panda73111/HDMI-eagle/README.md

[pandaLight on 3D Warehouse](https://3dwarehouse.sketchup.com/model.html?id=u218e26f0-69cc-4069-a915-63719f472bee)
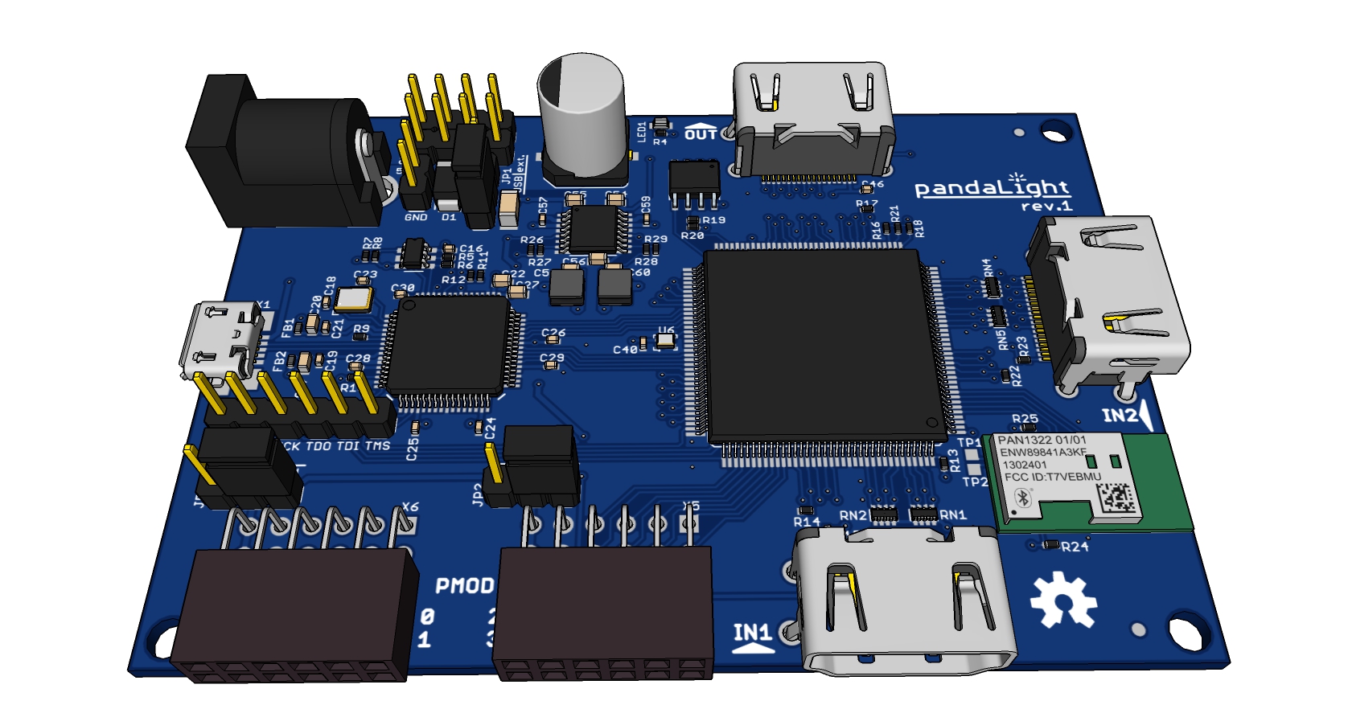
[picture p1: pandalLight/render/full.jpg]
pandaLight render
