panda73111/HDMI-eagle/pandalLight/Collada/pandaLight_rev1/eagleUp_pandaLight_bottom_board.png

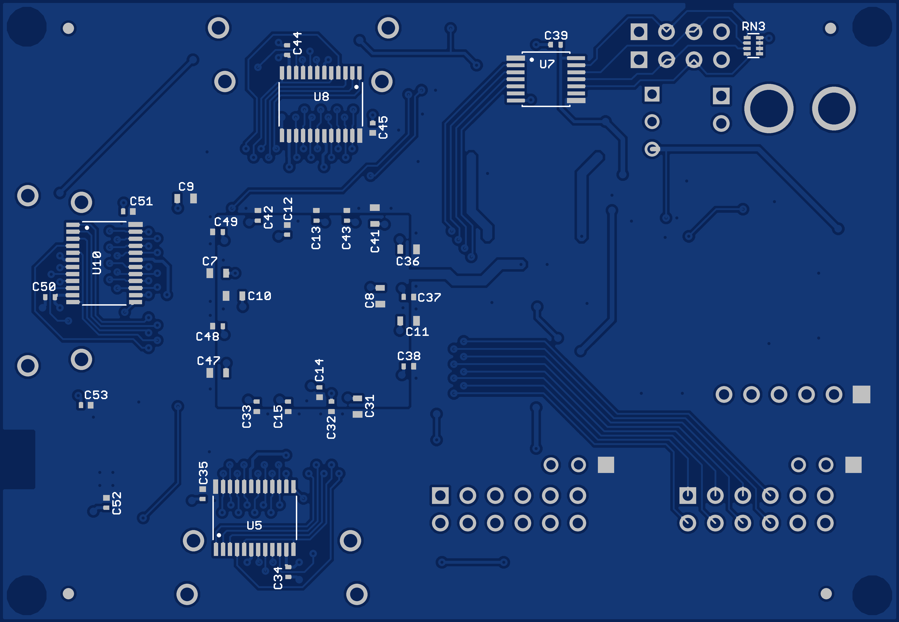
pandalLight/Collada/pandaLight_rev1/eagleUp_pandaLight_bottom_board.png
