panda73111/HDMI-eagle/pandalLight/Collada/pandaLight_rev1/textur_top.png

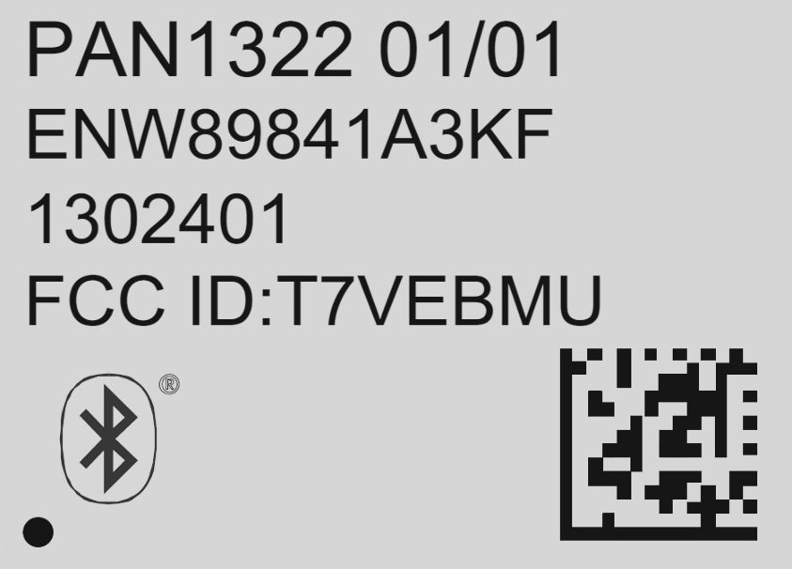
pandalLight/Collada/pandaLight_rev1/textur_top.png
