panda73111/HDMI-eagle/pandalLight/render/bottom.jpg

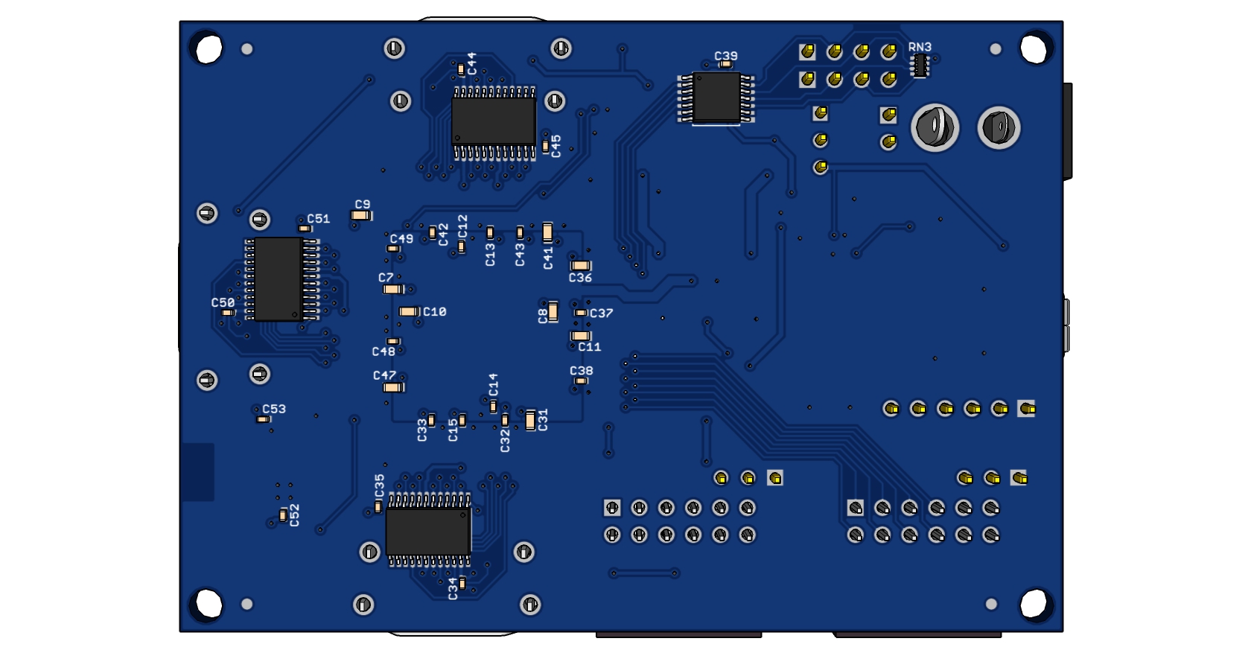
pandalLight/render/bottom.jpg
