panda73111/HDMI-eagle/pandalLight/render/top.jpg

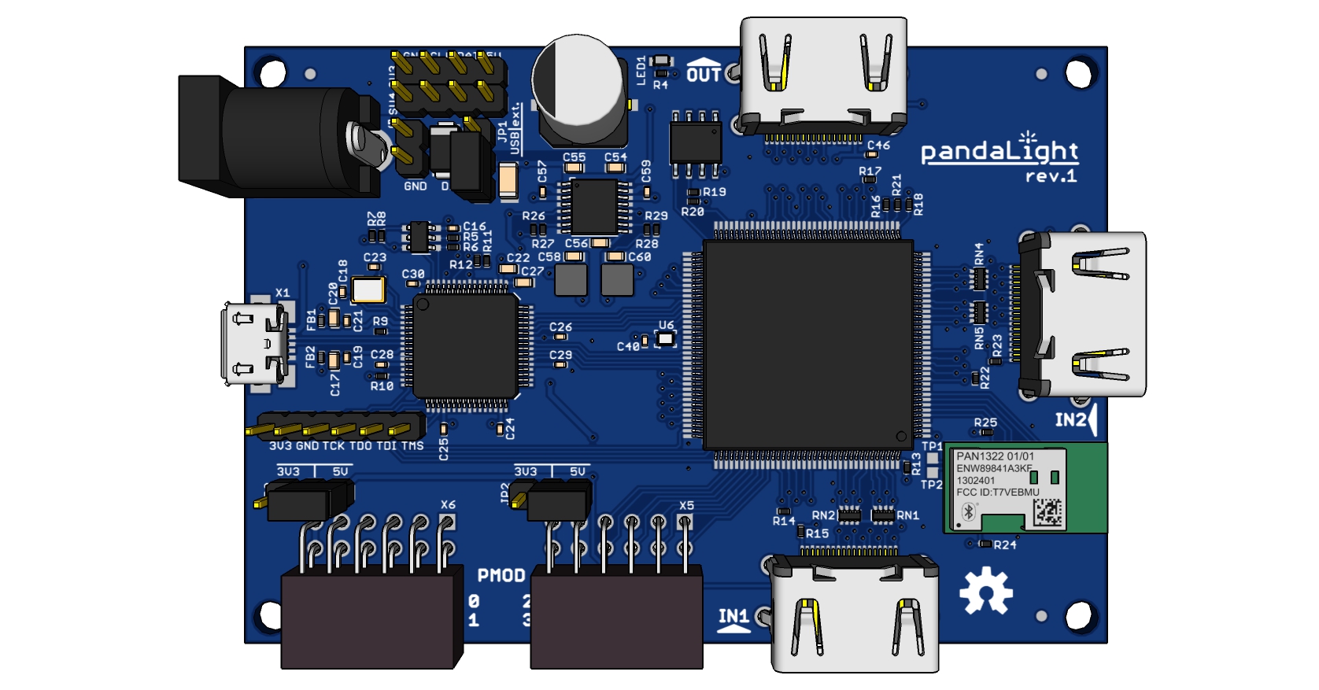
pandalLight/render/top.jpg
