panda73111/HDMI-eagle/(list of files, cad)

Other CAD files:
pandalLight/pandaLight_rev1.skp
