panda73111/HDMI-eagle/pandalLight/pandaLight.brd

## EAGLE design pandalLight/pandaLight.brd (2017-02-20)

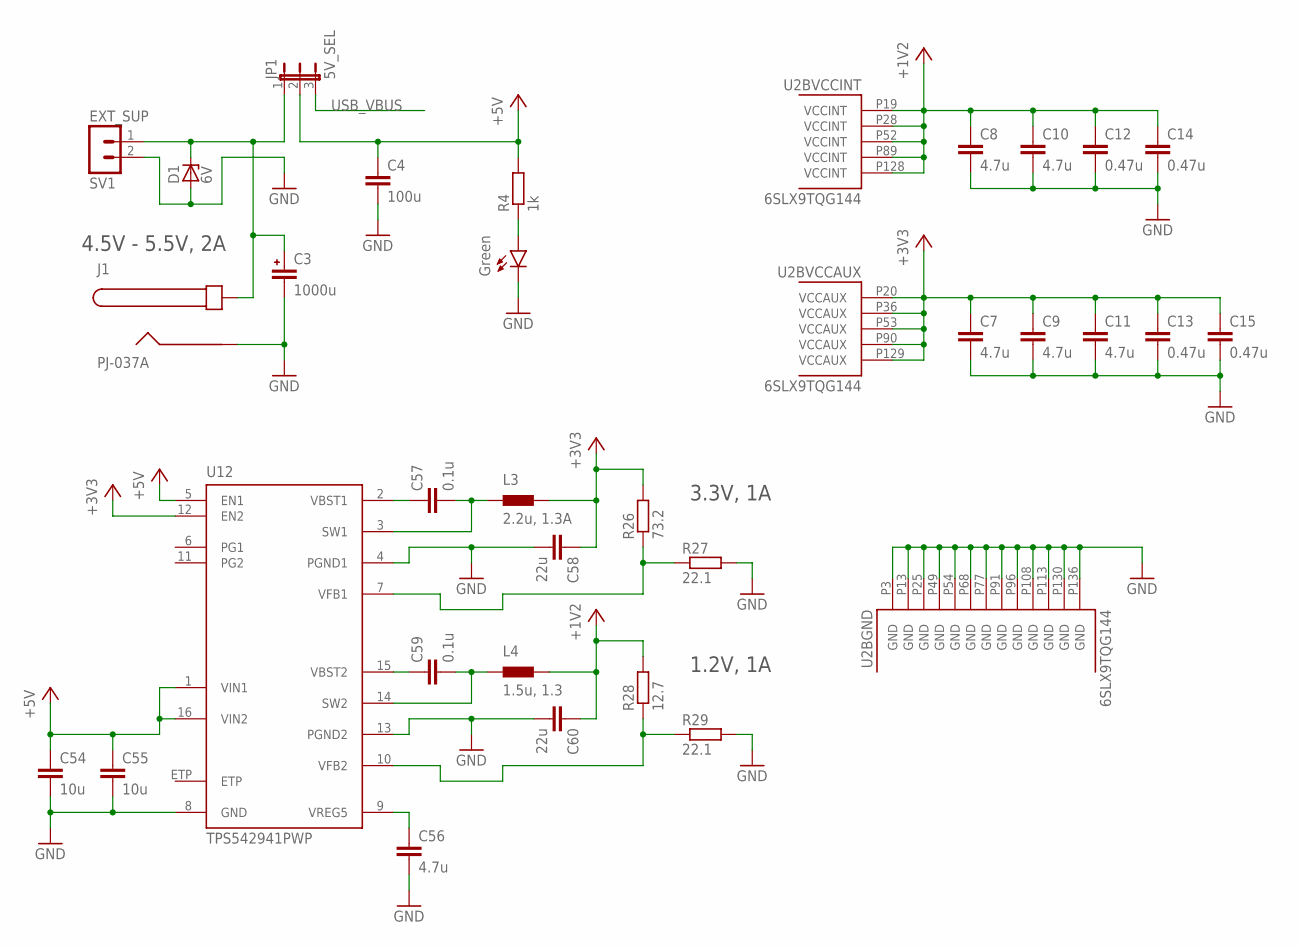
[picture p7: schematic pandaLight.sch, sheet 1, Power]

Parts:
C3: 1000u; MVY_HA0; PARTNO EMVY6R3ADA102MHA0G
C4: 100u; C1206; PARTNO CL31A107MQHNNNE
C7, C8, C9, C10, C11, C56: 4.7u; C0603; PARTNO C0603C475K9PACTU
C12, C13, C14, C15: 0.47u; C0402; PARTNO C1005X5R0J474K050BB
C54, C55: 10u; C0603; PARTNO CL10A106MQ8NNNC
C57, C59: 0.1u; C0402; PARTNO CL05B104KP5NNNC
C58, C60: 22u; C0603; PARTNO CL10A226MQ8NRNC
D1: 6V; DO-214AC; PARTNO SMAJ6.0A
J1: PJ-037A; PARTNO PJ-037A
JP1: 5V_SEL; JP2; PARTNO SPC02SYAN
L3: 2.2u, 1.3A; SRN3015_3X3; PARTNO SRN3015-2R2M
L4: 1.5u, 1.3; SRN3015_3X3; PARTNO SRN3015-1R5Y
LED1: Green; LED-0603; PARTNO LTST-C191KGKT
R4: 1k; R0402; PARTNO ERJ-2RKF1001X
R26: 73.2; R0402; PARTNO ERJ-2RKF73R2X
R27, R29: 22.1; R0402; PARTNO ERJ-2RKF22R1X
R28: 12.7; R0402; PARTNO ERJ-2RKF12R7X
SV1: EXT_SUP; MA02-1; PARTNO *
U2: 6SLX9TQG144; TQ144; PARTNO XC6SLX9-3TQG144C
U12: TPS542941PWP; R-PDSO-G16; PARTNO TPS542941PWP

Connections:
5V_SUP: C3.1, D1.C, J1.CENTER, JP1.1, SV1.1; also elsewhere on the board
+1V2: C8.1, C10.1, C12.1, C14.1, C60.1, L4.2, R28.2, U2.P19 (VCCINT), U2.P28 (VCCINT), U2.P52 (VCCINT), U2.P89 (VCCINT), U2.P128 (VCCINT)
+3V3: C7.1, C9.1, C11.1, C13.1, C15.1, C58.1, L3.2, R26.2, U2.P20 (VCCAUX), U2.P36 (VCCAUX), U2.P53 (VCCAUX), U2.P90 (VCCAUX), U2.P129 (VCCAUX), U12.12 (EN2); also elsewhere on the board
+5V: C4.1, C54.1, C55.1, JP1.2, R4.2, U12.1 (VIN1), U12.5 (EN1), U12.16 (VIN2); also elsewhere on the board
GND: C3.2, C4.2, C7.2, C8.2, C9.2, C10.2, C11.2, C12.2, C13.2, C14.2, C15.2, C54.2, C55.2, C56.2, C58.2, C60.2, D1.A, J1.BARREL, LED1.C, R27.2, R29.2, SV1.2, U2.P3 (GND), U2.P13 (GND), U2.P25 (GND), U2.P49 (GND), U2.P54 (GND), U2.P68 (GND), U2.P77 (GND), U2.P91 (GND), U2.P96 (GND), U2.P108 (GND), U2.P113 (GND), U2.P130 (GND), U2.P136 (GND), U12.4 (PGND1), U12.8 (GND), U12.13 (PGND2); also elsewhere on the board
unnamed: C57.2, L3.1, U12.3 (SW1)
unnamed: R26.1, R27.1, U12.7 (VFB1)
unnamed: C57.1, U12.2 (VBST1)
unnamed: R28.1, R29.1, U12.10 (VFB2)
unnamed: C59.1, U12.15 (VBST2)
unnamed: C59.2, L4.1, U12.14 (SW2)
unnamed: LED1.A, R4.1
USB_VBUS: JP1.3; also elsewhere on the board
VREG5: C56.1, U12.9 (VREG5)

Notes on the sheet:
4.5V - 5.5V, 2A
3.3V, 1A
1.2V, 1A

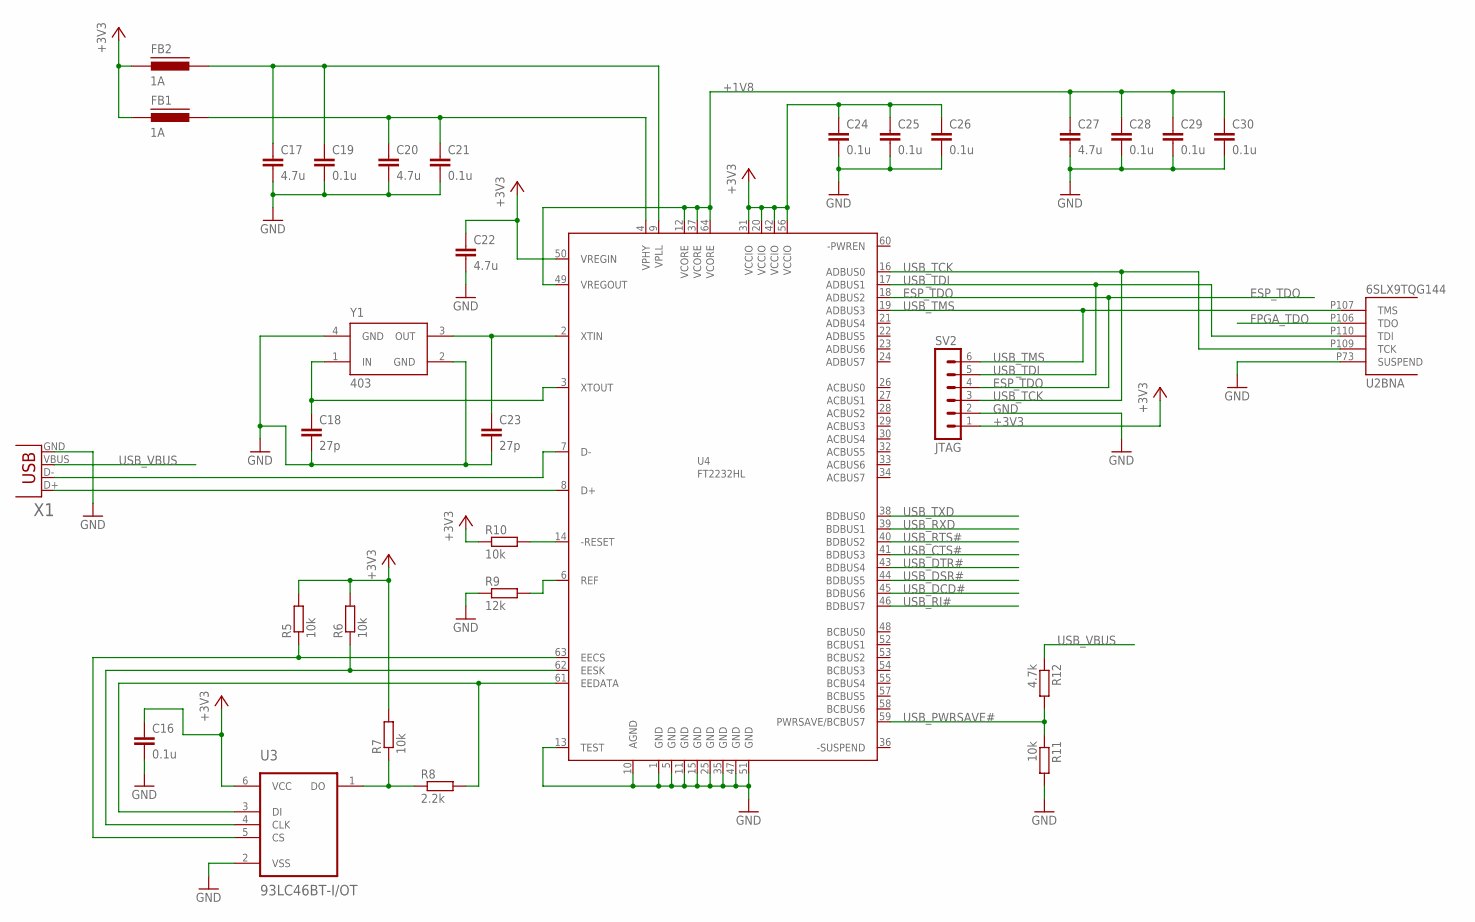
[picture p8: schematic pandaLight.sch, sheet 2, USB]

Parts:
C16, C19, C21, C24, C25, C26, C28, C29, C30: 0.1u; C0402; PARTNO CL05B104KP5NNNC
C17, C20, C22, C27: 4.7u; C0603; PARTNO C0603C475K9PACTU
C18, C23: 27p; C0402; PARTNO CL05C270JB5NNNC
FB1, FB2: 1A; FB0402; PARTNO BK1005HS100-T
R5, R6, R7, R10, R11: 10k; R0402; PARTNO ERJ-2RKF1002X
R8: 2.2k; R0402; PARTNO ERJ-2RKF2201X
R9: 12k; R0402; PARTNO ERJ-2RKF1202X
R12: 4.7k; R0402; PARTNO ERJ-2RKF4701X
SV2: JTAG; MA06-1; PARTNO *
U2: 6SLX9TQG144; TQ144; PARTNO XC6SLX9-3TQG144C
U3: 93LC46BT-I/OT; SOT23-6; PARTNO 93LC46BT-I/OT
U4: FT2232HL; LQFP64; PARTNO FT2232HL-REEL
X1: USBUB-S; USB-UB-S; PARTNO 10118192-0001LF
Y1: 403; 403-3.2X2.5; PARTNO 403C35D12M00000

Connections:
+1V8: C27.1, C28.1, C29.1, C30.1, U4.12 (VCORE), U4.37 (VCORE), U4.49 (VREGOUT), U4.64 (VCORE)
+3V3: C16.1, C22.1, C24.1, C25.1, C26.1, FB1.1, FB2.1, R5.2, R6.2, R7.2, R10.1, SV2.1, U3.6 (VCC), U4.20 (VCCIO), U4.31 (VCCIO), U4.42 (VCCIO), U4.50 (VREGIN), U4.56 (VCCIO); also elsewhere on the board
ESP_TDO: SV2.4, U4.18 (ADBUS2); also elsewhere on the board
FPGA_TDO: U2.P106 (TDO); also elsewhere on the board
GND: C16.2, C17.2, C18.2, C19.2, C20.2, C21.2, C22.2, C23.2, C24.2, C25.2, C26.2, C27.2, C28.2, C29.2, C30.2, R9.1, R11.2, SV2.2, U2.P73 (SUSPEND), U3.2 (VSS), U4.1 (GND), U4.5 (GND), U4.10 (AGND), U4.11 (GND), U4.13 (TEST), U4.15 (GND), U4.25 (GND), U4.35 (GND), U4.47 (GND), U4.51 (GND), X1.GND, Y1.2 (GND), Y1.4 (GND); also elsewhere on the board
unnamed: C23.1, U4.2 (XTIN), Y1.3 (OUT)
unnamed: C18.1, U4.3 (XTOUT), Y1.1 (IN)
unnamed: R5.1, U3.5 (CS), U4.63 (EECS)
unnamed: U4.7 (D-), X1.D-
unnamed: U4.8 (D+), X1.D+
unnamed: R6.1, U3.4 (CLK), U4.62 (EESK)
unnamed: R8.2, U3.3 (DI), U4.61 (EEDATA)
unnamed: R9.2, U4.6 (REF)
unnamed: R7.1, R8.1, U3.1 (DO)
unnamed: R10.2, U4.14 (-RESET)
unnamed: C20.1, C21.1, FB1.2, U4.4 (VPHY)
unnamed: C17.1, C19.1, FB2.2, U4.9 (VPLL)
USB_CTS#: U4.41 (BDBUS3); also elsewhere on the board
USB_DCD#: U4.45 (BDBUS6); also elsewhere on the board
USB_DSR#: U4.44 (BDBUS5); also elsewhere on the board
USB_DTR#: U4.43 (BDBUS4); also elsewhere on the board
USB_PWRSAVE#: R11.1, R12.2, U4.59 (PWRSAVE/BCBUS7)
USB_RI#: U4.46 (BDBUS7); also elsewhere on the board
USB_RTS#: U4.40 (BDBUS2); also elsewhere on the board
USB_RXD: U4.39 (BDBUS1); also elsewhere on the board
USB_TCK: SV2.3, U2.P109 (TCK), U4.16 (ADBUS0); also elsewhere on the board
USB_TDI: SV2.5, U2.P110 (TDI), U4.17 (ADBUS1)
USB_TMS: SV2.6, U2.P107 (TMS), U4.19 (ADBUS3); also elsewhere on the board
USB_TXD: U4.38 (BDBUS0); also elsewhere on the board
USB_VBUS: R12.1, X1.VBUS; also elsewhere on the board

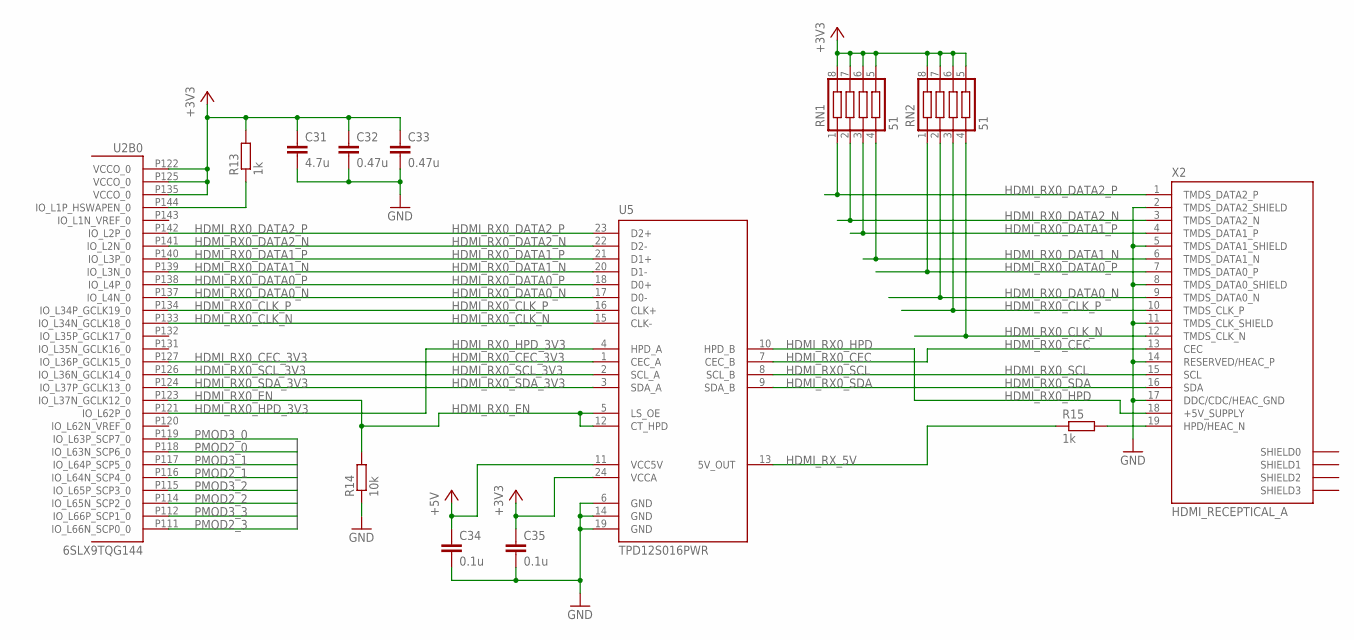
[picture p9: schematic pandaLight.sch, sheet 3, B0, HDMI Rx0]

Parts:
C31: 4.7u; C0603; PARTNO C0603C475K9PACTU
C32, C33: 0.47u; C0402; PARTNO C1005X5R0J474K050BB
C34, C35: 0.1u; C0402; PARTNO CL05B104KP5NNNC
R13, R15: 1k; R0402; PARTNO ERJ-2RKF1001X
R14: 10k; R0402; PARTNO ERJ-2RKF1002X
RN1, RN2: 51; 741C083; PARTNO 741C083510JP
U2: 6SLX9TQG144; TQ144; PARTNO XC6SLX9-3TQG144C
U5: TPD12S016PWR; PW_R-PDSO-G24; PARTNO TPD12S016PWR
X2: HDMI_RECEPTICAL_A; HDMI_TYPE_A_RECEPTICAL; PARTNO 10029449-111RLF

Connections:
+3V3: C31.1, C32.1, C33.1, C35.1, R13.2, RN1.5, RN1.6, RN1.7, RN1.8, RN2.5, RN2.6, RN2.7, RN2.8, U2.P122 (VCCO_0), U2.P125 (VCCO_0), U2.P135 (VCCO_0), U5.24 (VCCA); also elsewhere on the board
+5V: C34.1, U5.11 (VCC5V); also elsewhere on the board
GND: C31.2, C32.2, C33.2, C34.2, C35.2, R14.1, U5.6 (GND), U5.14 (GND), U5.19 (GND), X2.2 (TMDS_DATA2_SHIELD), X2.5 (TMDS_DATA1_SHIELD), X2.8 (TMDS_DATA0_SHIELD), X2.11 (TMDS_CLK_SHIELD), X2.14 (RESERVED/HEAC_P), X2.17 (DDC/CDC/HEAC_GND); also elsewhere on the board
HDMI_RX0_CEC: U5.7 (CEC_B), X2.13 (CEC)
HDMI_RX0_CEC_3V3: U2.P127 (IO_L36P_GCLK15_0), U5.1 (CEC_A)
HDMI_RX0_CLK_N: RN2.4, U2.P133 (IO_L34N_GCLK18_0), U5.15 (CLK-), X2.12 (TMDS_CLK_N)
HDMI_RX0_CLK_P: RN2.3, U2.P134 (IO_L34P_GCLK19_0), U5.16 (CLK+), X2.10 (TMDS_CLK_P)
HDMI_RX0_DATA0_N: RN2.2, U2.P137 (IO_L4N_0), U5.17 (D0-), X2.9 (TMDS_DATA0_N)
HDMI_RX0_DATA0_P: RN2.1, U2.P138 (IO_L4P_0), U5.18 (D0+), X2.7 (TMDS_DATA0_P)
HDMI_RX0_DATA1_N: RN1.4, U2.P139 (IO_L3N_0), U5.20 (D1-), X2.6 (TMDS_DATA1_N)
HDMI_RX0_DATA1_P: RN1.3, U2.P140 (IO_L3P_0), U5.21 (D1+), X2.4 (TMDS_DATA1_P)
HDMI_RX0_DATA2_N: RN1.2, U2.P141 (IO_L2N_0), U5.22 (D2-), X2.3 (TMDS_DATA2_N)
HDMI_RX0_DATA2_P: RN1.1, U2.P142 (IO_L2P_0), U5.23 (D2+), X2.1 (TMDS_DATA2_P)
HDMI_RX0_EN: R14.2, U2.P123 (IO_L37N_GCLK12_0), U5.5 (LS_OE), U5.12 (CT_HPD)
HDMI_RX0_HPD: U5.10 (HPD_B), X2.18 (+5V_SUPPLY)
HDMI_RX0_HPD_3V3: U2.P121 (IO_L62P_0), U5.4 (HPD_A)
HDMI_RX0_SCL: U5.8 (SCL_B), X2.15 (SCL)
HDMI_RX0_SCL_3V3: U2.P126 (IO_L36N_GCLK14_0), U5.2 (SCL_A)
HDMI_RX0_SDA: U5.9 (SDA_B), X2.16 (SDA)
HDMI_RX0_SDA_3V3: U2.P124 (IO_L37P_GCLK13_0), U5.3 (SDA_A)
HDMI_RX_5V: R15.1, U5.13 (5V_OUT)
unnamed: R13.1, U2.P144 (IO_L1P_HSWAPEN_0)
unnamed: R15.2, X2.19 (HPD/HEAC_N)
PMOD2_0: U2.P118 (IO_L63N_SCP6_0); also elsewhere on the board
PMOD2_1: U2.P116 (IO_L64N_SCP4_0); also elsewhere on the board
PMOD2_2: U2.P114 (IO_L65N_SCP2_0); also elsewhere on the board
PMOD2_3: U2.P111 (IO_L66N_SCP0_0); also elsewhere on the board
PMOD3_0: U2.P119 (IO_L63P_SCP7_0); also elsewhere on the board
PMOD3_1: U2.P117 (IO_L64P_SCP5_0); also elsewhere on the board
PMOD3_2: U2.P115 (IO_L65P_SCP3_0); also elsewhere on the board
PMOD3_3: U2.P112 (IO_L66P_SCP1_0); also elsewhere on the board

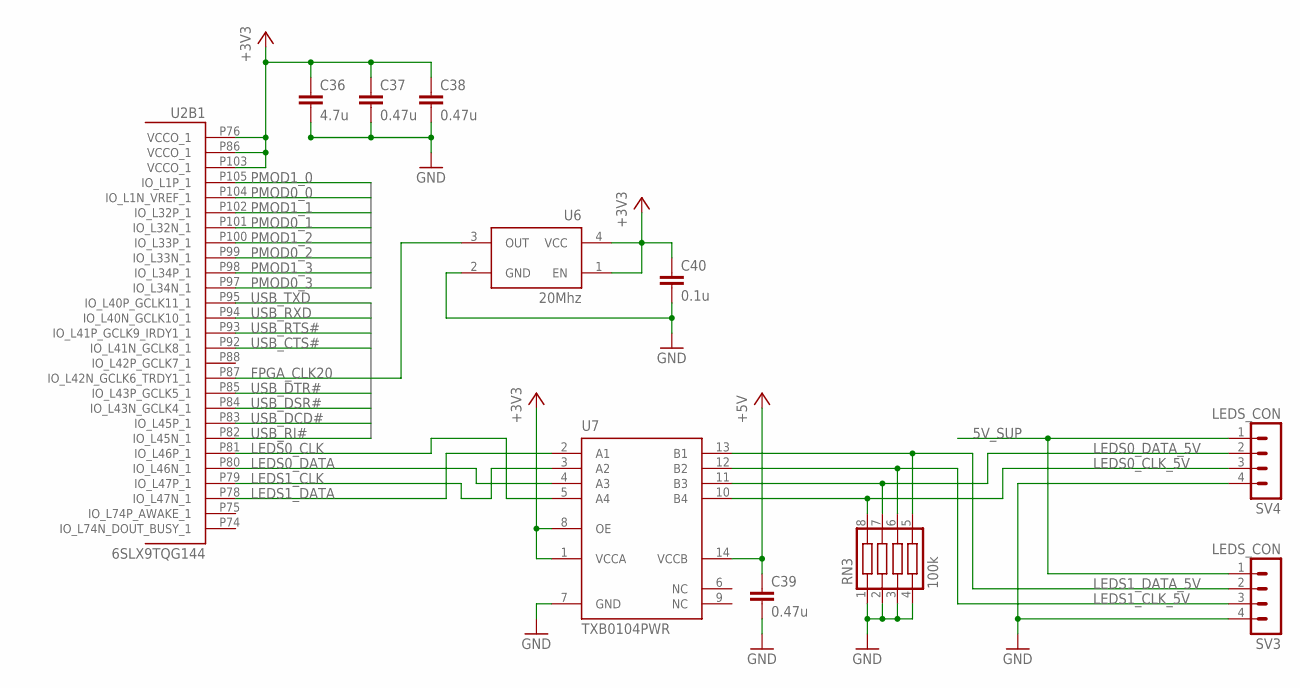
[picture p10: schematic pandaLight.sch, sheet 4, B1, LEDs]

Parts:
C36: 4.7u; C0603; PARTNO C0603C475K9PACTU
C37, C38, C39: 0.47u; C0402; PARTNO C1005X5R0J474K050BB
C40: 0.1u; C0402; PARTNO CL05B104KP5NNNC
RN3: 100k; 741C083; PARTNO 741C083104JP
SV3, SV4: LEDS_CON; MA04-1; PARTNO *
U2: 6SLX9TQG144; TQ144; PARTNO XC6SLX9-3TQG144C
U6: 20Mhz; OSCI-1.6X1.2; PARTNO ASCO-20.000MHZ-EK-T3
U7: TXB0104PWR; R-PDSO-G14; PARTNO TXB0104PWR

Connections:
5V_SUP: SV3.1, SV4.1; also elsewhere on the board
+3V3: C36.1, C37.1, C38.1, C40.1, U2.P76 (VCCO_1), U2.P86 (VCCO_1), U2.P103 (VCCO_1), U6.1 (EN), U6.4 (VCC), U7.1 (VCCA), U7.8 (OE); also elsewhere on the board
+5V: C39.1, U7.14 (VCCB); also elsewhere on the board
FPGA_CLK20: U2.P87 (IO_L42N_GCLK6_TRDY1_1), U6.3 (OUT)
GND: C36.2, C37.2, C38.2, C39.2, C40.2, RN3.1, RN3.2, RN3.3, RN3.4, SV3.4, SV4.4, U6.2 (GND), U7.7 (GND); also elsewhere on the board
LEDS0_CLK: U2.P81 (IO_L46P_1), U7.5 (A4)
LEDS0_CLK_5V: RN3.8, SV4.3, U7.10 (B4)
LEDS0_DATA: U2.P80 (IO_L46N_1), U7.4 (A3)
LEDS0_DATA_5V: RN3.7, SV4.2, U7.11 (B3)
LEDS1_CLK: U2.P79 (IO_L47P_1), U7.3 (A2)
LEDS1_CLK_5V: RN3.6, SV3.3, U7.12 (B2)
LEDS1_DATA: U2.P78 (IO_L47N_1), U7.2 (A1)
LEDS1_DATA_5V: RN3.5, SV3.2, U7.13 (B1)
PMOD0_0: U2.P104 (IO_L1N_VREF_1); also elsewhere on the board
PMOD0_1: U2.P101 (IO_L32N_1); also elsewhere on the board
PMOD0_2: U2.P99 (IO_L33N_1); also elsewhere on the board
PMOD0_3: U2.P97 (IO_L34N_1); also elsewhere on the board
PMOD1_0: U2.P105 (IO_L1P_1); also elsewhere on the board
PMOD1_1: U2.P102 (IO_L32P_1); also elsewhere on the board
PMOD1_2: U2.P100 (IO_L33P_1); also elsewhere on the board
PMOD1_3: U2.P98 (IO_L34P_1); also elsewhere on the board
USB_CTS#: U2.P92 (IO_L41N_GCLK8_1); also elsewhere on the board
USB_DCD#: U2.P83 (IO_L45P_1); also elsewhere on the board
USB_DSR#: U2.P84 (IO_L43N_GCLK4_1); also elsewhere on the board
USB_DTR#: U2.P85 (IO_L43P_GCLK5_1); also elsewhere on the board
USB_RI#: U2.P82 (IO_L45N_1); also elsewhere on the board
USB_RTS#: U2.P93 (IO_L41P_GCLK9_IRDY1_1); also elsewhere on the board
USB_RXD: U2.P94 (IO_L40N_GCLK10_1); also elsewhere on the board
USB_TXD: U2.P95 (IO_L40P_GCLK11_1); also elsewhere on the board

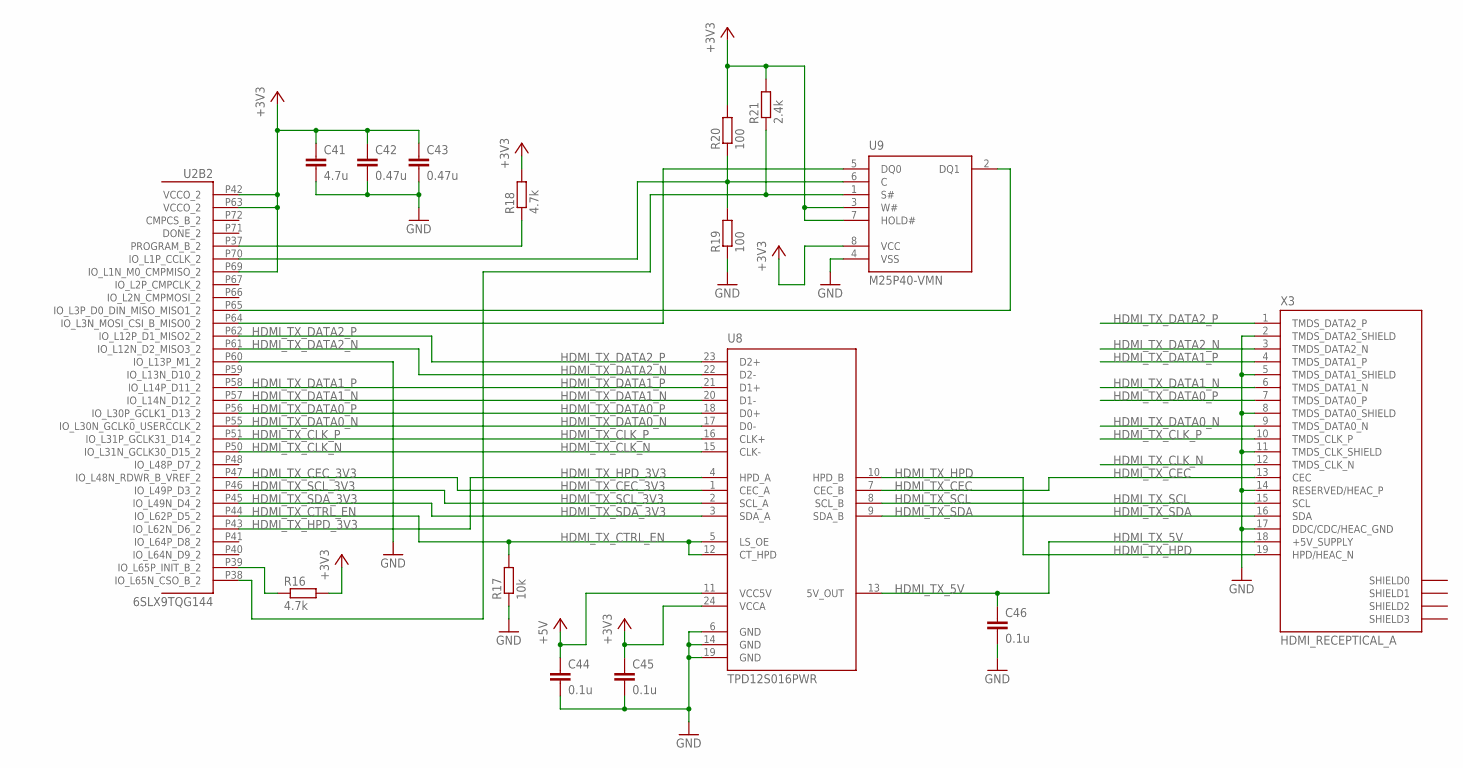
[picture p11: schematic pandaLight.sch, sheet 5, B2, HDMI Tx]

Parts:
C41: 4.7u; C0603; PARTNO C0603C475K9PACTU
C42, C43: 0.47u; C0402; PARTNO C1005X5R0J474K050BB
C44, C45, C46: 0.1u; C0402; PARTNO CL05B104KP5NNNC
R16, R18: 4.7k; R0402; PARTNO ERJ-2RKF4701X
R17: 10k; R0402; PARTNO ERJ-2RKF1002X
R19, R20: 100; R0402; PARTNO ERJ-2GEJ101X
R21: 2.4k; R0402; PARTNO ERJ-2RKF2401X
U2: 6SLX9TQG144; TQ144; PARTNO XC6SLX9-3TQG144C
U8: TPD12S016PWR; PW_R-PDSO-G24; PARTNO TPD12S016PWR
U9: M25P40-VMN; SO8N; PARTNO M25P80-VMN6TP
X3: HDMI_RECEPTICAL_A; HDMI_TYPE_A_RECEPTICAL; PARTNO 10029449-111RLF

Connections:
+3V3: C41.1, C42.1, C43.1, C45.1, R16.2, R18.2, R20.2, R21.2, U2.P42 (VCCO_2), U2.P63 (VCCO_2), U2.P69 (IO_L1N_M0_CMPMISO_2), U8.24 (VCCA), U9.3 (W#), U9.7 (HOLD#), U9.8 (VCC); also elsewhere on the board
+5V: C44.1, U8.11 (VCC5V); also elsewhere on the board
GND: C41.2, C42.2, C43.2, C44.2, C45.2, C46.2, R17.1, R19.1, U2.P60 (IO_L13P_M1_2), U8.6 (GND), U8.14 (GND), U8.19 (GND), U9.4 (VSS), X3.2 (TMDS_DATA2_SHIELD), X3.5 (TMDS_DATA1_SHIELD), X3.8 (TMDS_DATA0_SHIELD), X3.11 (TMDS_CLK_SHIELD), X3.14 (RESERVED/HEAC_P), X3.17 (DDC/CDC/HEAC_GND); also elsewhere on the board
HDMI_TX_5V: C46.1, U8.13 (5V_OUT), X3.18 (+5V_SUPPLY)
HDMI_TX_CEC: U8.7 (CEC_B), X3.13 (CEC)
HDMI_TX_CEC_3V3: U2.P47 (IO_L48N_RDWR_B_VREF_2), U8.1 (CEC_A)
HDMI_TX_CLK_N: U2.P50 (IO_L31N_GCLK30_D15_2), U8.15 (CLK-), X3.12 (TMDS_CLK_N)
HDMI_TX_CLK_P: U2.P51 (IO_L31P_GCLK31_D14_2), U8.16 (CLK+), X3.10 (TMDS_CLK_P)
HDMI_TX_CTRL_EN: R17.2, U2.P44 (IO_L62P_D5_2), U8.5 (LS_OE), U8.12 (CT_HPD)
HDMI_TX_DATA0_N: U2.P55 (IO_L30N_GCLK0_USERCCLK_2), U8.17 (D0-), X3.9 (TMDS_DATA0_N)
HDMI_TX_DATA0_P: U2.P56 (IO_L30P_GCLK1_D13_2), U8.18 (D0+), X3.7 (TMDS_DATA0_P)
HDMI_TX_DATA1_N: U2.P57 (IO_L14N_D12_2), U8.20 (D1-), X3.6 (TMDS_DATA1_N)
HDMI_TX_DATA1_P: U2.P58 (IO_L14P_D11_2), U8.21 (D1+), X3.4 (TMDS_DATA1_P)
HDMI_TX_DATA2_N: U2.P61 (IO_L12N_D2_MISO3_2), U8.22 (D2-), X3.3 (TMDS_DATA2_N)
HDMI_TX_DATA2_P: U2.P62 (IO_L12P_D1_MISO2_2), U8.23 (D2+), X3.1 (TMDS_DATA2_P)
HDMI_TX_HPD: U8.10 (HPD_B), X3.19 (HPD/HEAC_N)
HDMI_TX_HPD_3V3: U2.P43 (IO_L62N_D6_2), U8.4 (HPD_A)
HDMI_TX_SCL: U8.8 (SCL_B), X3.15 (SCL)
HDMI_TX_SCL_3V3: U2.P46 (IO_L49P_D3_2), U8.2 (SCL_A)
HDMI_TX_SDA: U8.9 (SDA_B), X3.16 (SDA)
HDMI_TX_SDA_3V3: U2.P45 (IO_L49N_D4_2), U8.3 (SDA_A)
unnamed: R18.1, U2.P37 (PROGRAM_B_2)
unnamed: R16.1, U2.P39 (IO_L65P_INIT_B_2)
unnamed: U2.P64 (IO_L3N_MOSI_CSI_B_MISO0_2), U9.5 (DQ0)
unnamed: R21.1, U2.P38 (IO_L65N_CSO_B_2), U9.1 (S#)
unnamed: R19.2, R20.1, U2.P70 (IO_L1P_CCLK_2), U9.6 (C)
unnamed: U2.P65 (IO_L3P_D0_DIN_MISO_MISO1_2), U9.2 (DQ1)

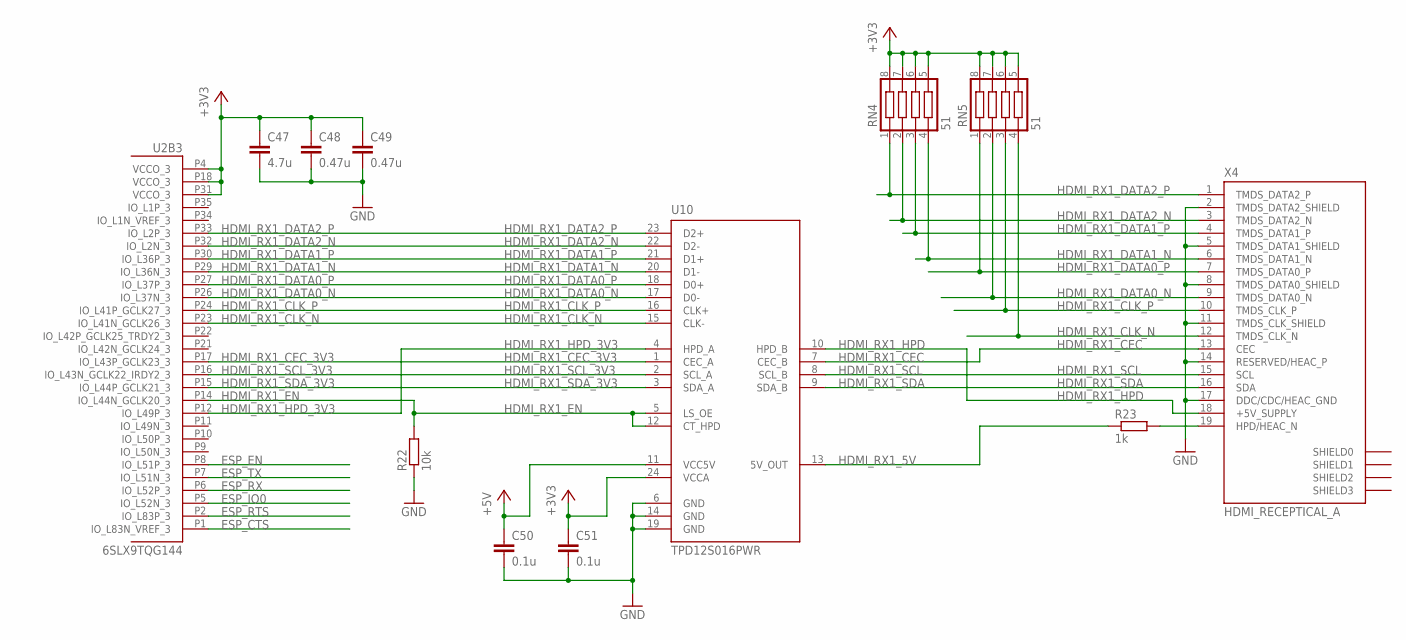
[picture p12: schematic pandaLight.sch, sheet 6, B3, HDMI Rx1, Bluetooth/WiFi]

Parts:
C47: 4.7u; C0603; PARTNO C0603C475K9PACTU
C48, C49: 0.47u; C0402; PARTNO C1005X5R0J474K050BB
C50, C51: 0.1u; C0402; PARTNO CL05B104KP5NNNC
R22: 10k; R0402; PARTNO ERJ-2RKF1002X
R23: 1k; R0402; PARTNO ERJ-2RKF1001X
RN4, RN5: 51; 741C083; PARTNO 741C083510JP
U2: 6SLX9TQG144; TQ144; PARTNO XC6SLX9-3TQG144C
U10: TPD12S016PWR; PW_R-PDSO-G24; PARTNO TPD12S016PWR
X4: HDMI_RECEPTICAL_A; HDMI_TYPE_A_RECEPTICAL; PARTNO 10029449-111RLF

Connections:
+3V3: C47.1, C48.1, C49.1, C51.1, RN4.5, RN4.6, RN4.7, RN4.8, RN5.5, RN5.6, RN5.7, RN5.8, U2.P4 (VCCO_3), U2.P18 (VCCO_3), U2.P31 (VCCO_3), U10.24 (VCCA); also elsewhere on the board
+5V: C50.1, U10.11 (VCC5V); also elsewhere on the board
ESP_CTS: U2.P1 (IO_L83N_VREF_3); also elsewhere on the board
ESP_EN: U2.P8 (IO_L51P_3); also elsewhere on the board
ESP_IO0: U2.P5 (IO_L52N_3); also elsewhere on the board
ESP_RTS: U2.P2 (IO_L83P_3); also elsewhere on the board
ESP_RX: U2.P6 (IO_L52P_3); also elsewhere on the board
ESP_TX: U2.P7 (IO_L51N_3); also elsewhere on the board
GND: C47.2, C48.2, C49.2, C50.2, C51.2, R22.1, U10.6 (GND), U10.14 (GND), U10.19 (GND), X4.2 (TMDS_DATA2_SHIELD), X4.5 (TMDS_DATA1_SHIELD), X4.8 (TMDS_DATA0_SHIELD), X4.11 (TMDS_CLK_SHIELD), X4.14 (RESERVED/HEAC_P), X4.17 (DDC/CDC/HEAC_GND); also elsewhere on the board
HDMI_RX1_5V: R23.1, U10.13 (5V_OUT)
HDMI_RX1_CEC: U10.7 (CEC_B), X4.13 (CEC)
HDMI_RX1_CEC_3V3: U2.P17 (IO_L43P_GCLK23_3), U10.1 (CEC_A)
HDMI_RX1_CLK_N: RN5.4, U2.P23 (IO_L41N_GCLK26_3), U10.15 (CLK-), X4.12 (TMDS_CLK_N)
HDMI_RX1_CLK_P: RN5.3, U2.P24 (IO_L41P_GCLK27_3), U10.16 (CLK+), X4.10 (TMDS_CLK_P)
HDMI_RX1_DATA0_N: RN5.2, U2.P26 (IO_L37N_3), U10.17 (D0-), X4.9 (TMDS_DATA0_N)
HDMI_RX1_DATA0_P: RN5.1, U2.P27 (IO_L37P_3), U10.18 (D0+), X4.7 (TMDS_DATA0_P)
HDMI_RX1_DATA1_N: RN4.4, U2.P29 (IO_L36N_3), U10.20 (D1-), X4.6 (TMDS_DATA1_N)
HDMI_RX1_DATA1_P: RN4.3, U2.P30 (IO_L36P_3), U10.21 (D1+), X4.4 (TMDS_DATA1_P)
HDMI_RX1_DATA2_N: RN4.2, U2.P32 (IO_L2N_3), U10.22 (D2-), X4.3 (TMDS_DATA2_N)
HDMI_RX1_DATA2_P: RN4.1, U2.P33 (IO_L2P_3), U10.23 (D2+), X4.1 (TMDS_DATA2_P)
HDMI_RX1_EN: R22.2, U2.P14 (IO_L44N_GCLK20_3), U10.5 (LS_OE), U10.12 (CT_HPD)
HDMI_RX1_HPD: U10.10 (HPD_B), X4.18 (+5V_SUPPLY)
HDMI_RX1_HPD_3V3: U2.P12 (IO_L49P_3), U10.4 (HPD_A)
HDMI_RX1_SCL: U10.8 (SCL_B), X4.15 (SCL)
HDMI_RX1_SCL_3V3: U2.P16 (IO_L43N_GCLK22_IRDY2_3), U10.2 (SCL_A)
HDMI_RX1_SDA: U10.9 (SDA_B), X4.16 (SDA)
HDMI_RX1_SDA_3V3: U2.P15 (IO_L44P_GCLK21_3), U10.3 (SDA_A)
unnamed: R23.2, X4.19 (HPD/HEAC_N)

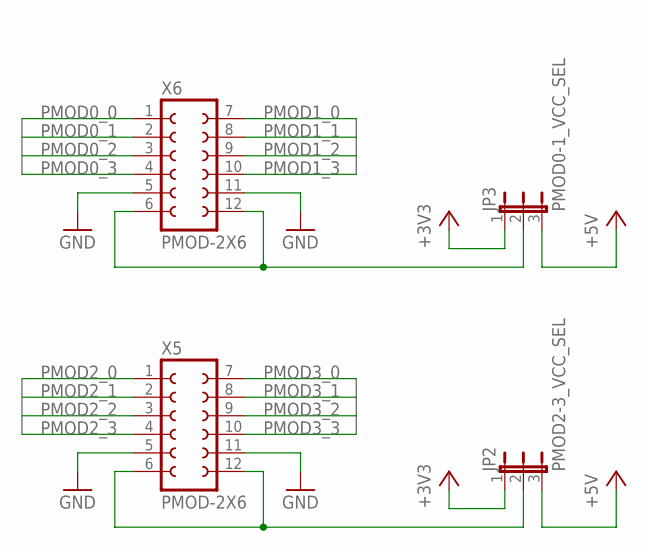
[picture p13: schematic pandaLight.sch, sheet 7, PMOD]

Parts:
JP2: PMOD2-3_VCC_SEL; JP2; PARTNO SPC02SYAN
JP3: PMOD0-1_VCC_SEL; JP2; PARTNO SPC02SYAN
X5, X6: PMOD-2X6; PARTNO PPTC062LJBN-RC

Connections:
+3V3: JP2.1, JP3.1; also elsewhere on the board
+5V: JP2.3, JP3.3; also elsewhere on the board
GND: X5.5, X5.11, X6.5, X6.11; also elsewhere on the board
unnamed: JP2.2, X5.6, X5.12
unnamed: JP3.2, X6.6, X6.12
PMOD0_0: X6.1; also elsewhere on the board
PMOD0_1: X6.2; also elsewhere on the board
PMOD0_2: X6.3; also elsewhere on the board
PMOD0_3: X6.4; also elsewhere on the board
PMOD1_0: X6.7; also elsewhere on the board
PMOD1_1: X6.8; also elsewhere on the board
PMOD1_2: X6.9; also elsewhere on the board
PMOD1_3: X6.10; also elsewhere on the board
PMOD2_0: X5.1; also elsewhere on the board
PMOD2_1: X5.2; also elsewhere on the board
PMOD2_2: X5.3; also elsewhere on the board
PMOD2_3: X5.4; also elsewhere on the board
PMOD3_0: X5.7; also elsewhere on the board
PMOD3_1: X5.8; also elsewhere on the board
PMOD3_2: X5.9; also elsewhere on the board
PMOD3_3: X5.10; also elsewhere on the board

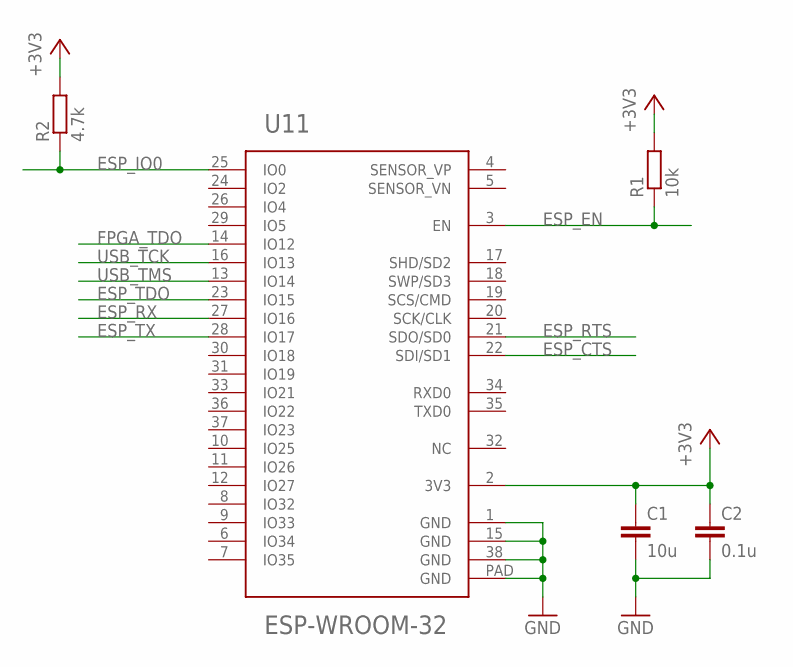
[picture p14: schematic pandaLight.sch, sheet 8, Bluetooth/WiFi]

Parts:
C1: 10u; C0603
C2: 0.1u; C0402; PARTNO CL05B104KP5NNNC
R1: 10k; R0402; PARTNO ERJ-2RKF1002X
R2: 4.7k; R0402; PARTNO ERJ-2RKF1002X
U11: ESP-WROOM-32

Connections:
+3V3: C1.1, C2.1, R1.2, R2.2, U11.2 (3V3); also elsewhere on the board
ESP_CTS: U11.22 (SDI/SD1); also elsewhere on the board
ESP_EN: R1.1, U11.3 (EN); also elsewhere on the board
ESP_IO0: R2.1, U11.25 (IO0); also elsewhere on the board
ESP_RTS: U11.21 (SDO/SD0); also elsewhere on the board
ESP_RX: U11.27 (IO16); also elsewhere on the board
ESP_TDO: U11.23 (IO15); also elsewhere on the board
ESP_TX: U11.28 (IO17); also elsewhere on the board
FPGA_TDO: U11.14 (IO12); also elsewhere on the board
GND: C1.2, C2.2, U11.1 (GND), U11.15 (GND), U11.38 (GND), U11.PAD (GND); also elsewhere on the board
USB_TCK: U11.16 (IO13); also elsewhere on the board
USB_TMS: U11.13 (IO14); also elsewhere on the board

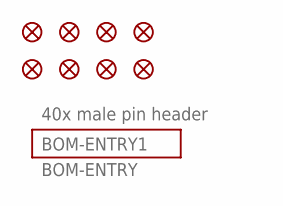
[picture p15: schematic pandaLight.sch, sheet 9, misc]

Parts:
FID1, FID2, FID3, FID4, FID5, FID6, FID7, FID8: FIDUCIAL1X2; FIDUCIAL-1X2

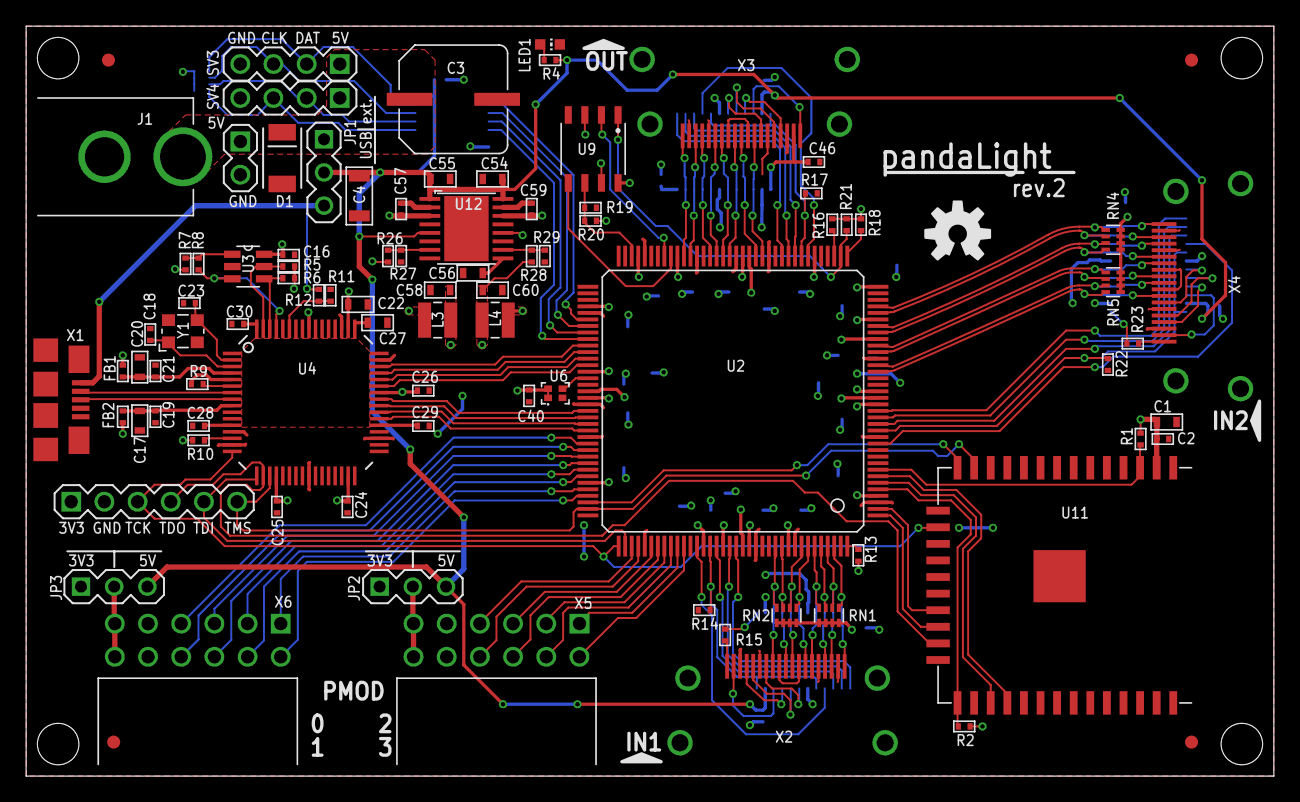
[picture p16: board pandaLight.brd from above]

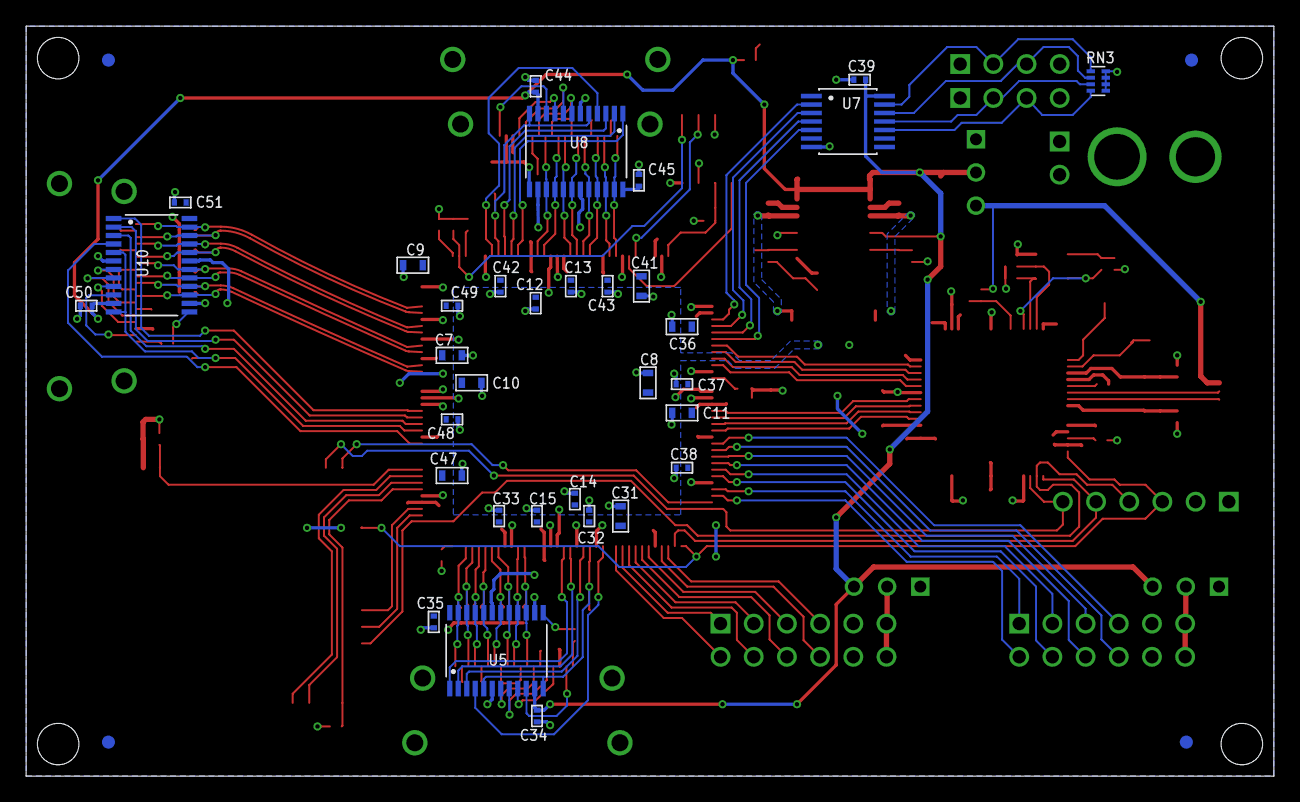
[picture p17: board pandaLight.brd from below]

Board: 2 copper layers, 95.5 x 57.4 mm, 128 parts (37 on the bottom side), 137 nets.

Other parts of the board:
OSHW-LOGO: OSHW-LOGO-M
