panda73111/HDMI-eagle/pandaLightPlus/pandaLightPlus.brd

## EAGLE design pandaLightPlus/pandaLightPlus.brd (2014-06-23)

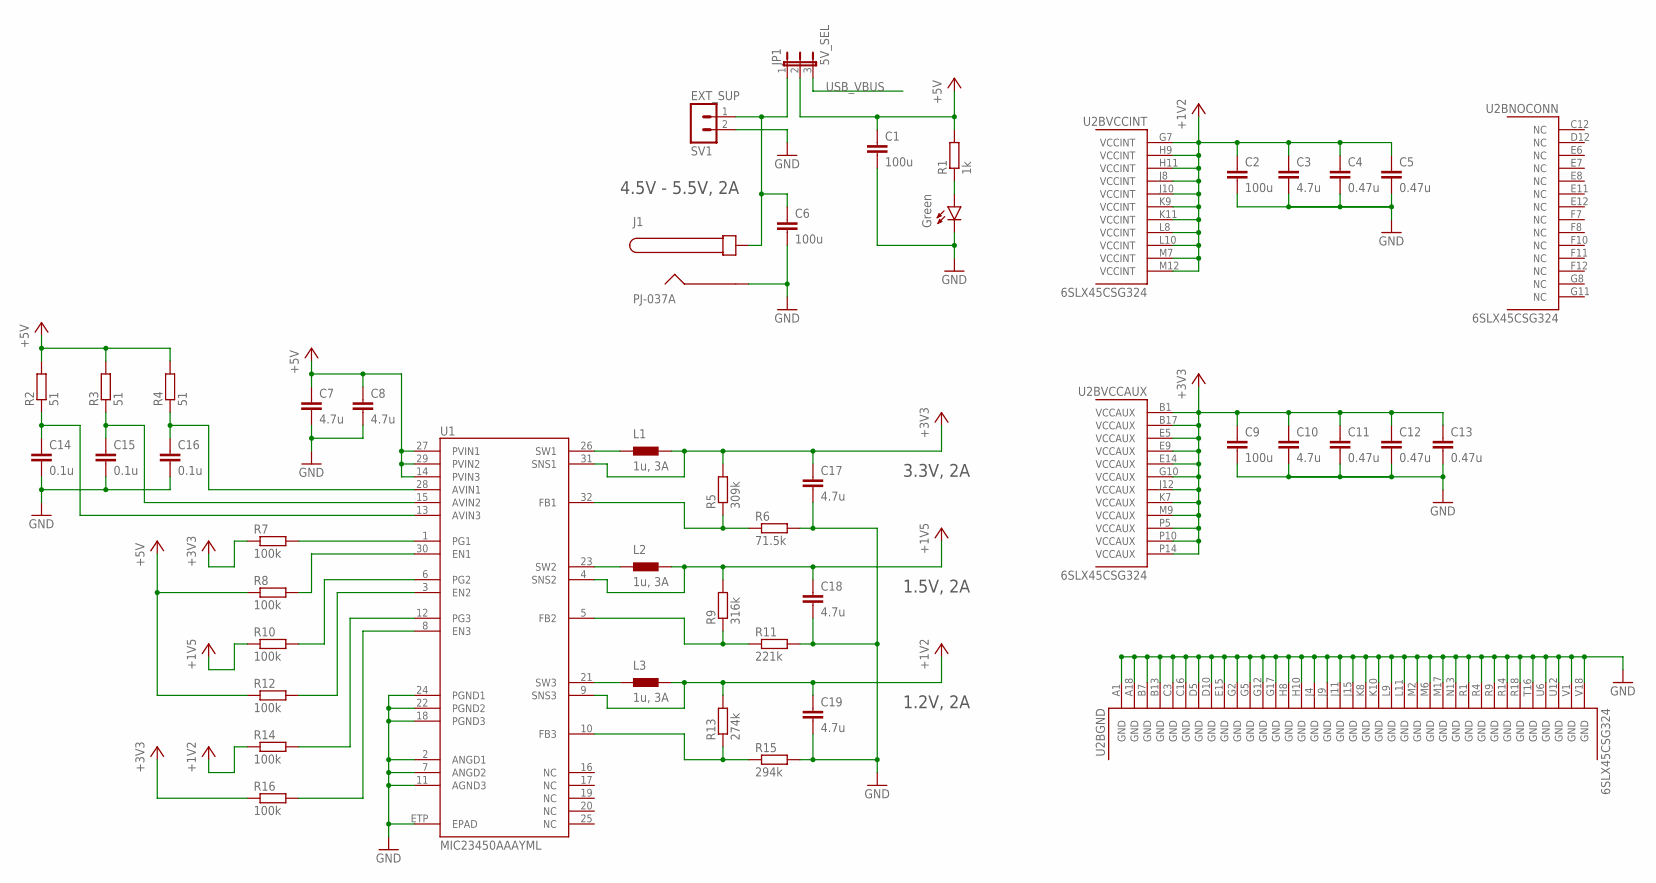
[picture p18: schematic pandaLightPlus.sch, sheet 1, Power]

Parts:
C1, C2, C6, C9: 100u; 1206; PARTNO CL31A107MQHNNNE
C3, C7, C8, C10, C17, C18, C19: 4.7u; 0603; PARTNO C0603C475K9PACTU
C4, C5, C11, C12, C13: 0.47u; 0402; PARTNO C1005X5R0J474K050BB
C14, C15, C16: 0.1u; 0402; PARTNO CL05B104KP5NNNC
J1: PJ-037A; PARTNO PJ-037A
JP1: 5V_SEL; JP2; PARTNO *
L1, L2, L3: 1u, 3A; 1008; PARTNO CIG22E1R0MNE
LED1: Green; LED-0603; PARTNO LG Q971-KN-1
R1: 1k; 0402; PARTNO ERJ-2RKF1001X
R2, R3, R4: 51; 0402; PARTNO ERJ-2RKF51R0X
R5: 309k; 0402; PARTNO ERJ-2RKF3093X
R6: 71.5k; 0402; PARTNO ERJ-2RKF7152X
R7, R8, R10, R12, R14, R16: 100k; 0402; PARTNO ERJ-2RKF1003X
R9: 316k; 0402; PARTNO ERJ-2RKF3163X
R11: 221k; 0402; PARTNO ERJ-2RKF2213X
R13: 274k; 0402; PARTNO ERJ-2RKF2743X
R15: 294k; 0402; PARTNO ERJ-2RKF2943X
SV1: EXT_SUP; MA02-1; PARTNO *
U1: MIC23450AAAYML; QFN-32-5X5; PARTNO MIC23450-AAAYML TR
U2: 6SLX45CSG324; CS324; PARTNO XC6SLX45-3CSG324C

Connections:
+1V2: C2.1, C3.1, C4.1, C5.1, C19.1, L3.2, R13.2, R14.1, U1.9 (SNS3), U2.G7 (VCCINT), U2.H9 (VCCINT), U2.H11 (VCCINT), U2.J8 (VCCINT), U2.J10 (VCCINT), U2.K9 (VCCINT), U2.K11 (VCCINT), U2.L8 (VCCINT), U2.L10 (VCCINT), U2.M7 (VCCINT), U2.M12 (VCCINT)
+1V5: C18.1, L2.2, R9.2, R10.1, U1.4 (SNS2); also elsewhere on the board
+3V3: C9.1, C10.1, C11.1, C12.1, C13.1, C17.1, L1.2, R5.2, R7.1, R16.1, U1.31 (SNS1), U2.B1 (VCCAUX), U2.B17 (VCCAUX), U2.E5 (VCCAUX), U2.E9 (VCCAUX), U2.E14 (VCCAUX), U2.G10 (VCCAUX), U2.J12 (VCCAUX), U2.K7 (VCCAUX), U2.M9 (VCCAUX), U2.P5 (VCCAUX), U2.P10 (VCCAUX), U2.P14 (VCCAUX); also elsewhere on the board
+5V: C1.1, C7.1, C8.1, JP1.2, R1.2, R2.2, R3.2, R4.2, R8.1, R12.1, U1.14 (PVIN3), U1.27 (PVIN1), U1.29 (PVIN2); also elsewhere on the board
CENTER: C6.1, J1.CENTER, JP1.1, SV1.1
GND: C1.2, C2.2, C3.2, C4.2, C5.2, C6.2, C7.2, C8.2, C9.2, C10.2, C11.2, C12.2, C13.2, C14.2, C15.2, C16.2, C17.2, C18.2, C19.2, J1.BARREL, LED1.C, R6.2, R11.2, R15.2, SV1.2, U1.2 (ANGD1), U1.7 (ANGD2), U1.11 (AGND3), U1.18 (PGND3), U1.22 (PGND2), U1.24 (PGND1), U1.ETP (EPAD), U2.A1 (GND), U2.A18 (GND), U2.B7 (GND), U2.B13 (GND), U2.C3 (GND), U2.C16 (GND), U2.D5 (GND), U2.D10 (GND), U2.E15 (GND), U2.G2 (GND), U2.G5 (GND), U2.G12 (GND), U2.G17 (GND), U2.H8 (GND), U2.H10 (GND), U2.J4 (GND), U2.J9 (GND), U2.J11 (GND), U2.J15 (GND), U2.K8 (GND), U2.K10 (GND), U2.L9 (GND), U2.L11 (GND), U2.M2 (GND), U2.M6 (GND), U2.M17 (GND), U2.N13 (GND), U2.R1 (GND), U2.R4 (GND), U2.R9 (GND), U2.R14 (GND), U2.R18 (GND), U2.T16 (GND), U2.U6 (GND), U2.U12 (GND), U2.V1 (GND), U2.V18 (GND); also elsewhere on the board
unnamed: L1.1, U1.26 (SW1)
unnamed: C16.1, R4.1, U1.28 (AVIN1)
unnamed: L2.1, U1.23 (SW2)
unnamed: L3.1, U1.21 (SW3)
unnamed: R13.1, R15.1, U1.10 (FB3)
unnamed: R10.2, U1.6 (PG2)
unnamed: R5.1, R6.1, U1.32 (FB1)
unnamed: R7.2, U1.1 (PG1)
unnamed: R9.1, R11.1, U1.5 (FB2)
unnamed: R12.2, U1.3 (EN2)
unnamed: R8.2, U1.30 (EN1)
unnamed: R14.2, U1.12 (PG3)
unnamed: R16.2, U1.8 (EN3)
unnamed: C15.1, R3.1, U1.15 (AVIN2)
unnamed: LED1.A, R1.1
unnamed: C14.1, R2.1, U1.13 (AVIN3)
USB_VBUS: JP1.3; also elsewhere on the board

Notes on the sheet:
4.5V - 5.5V, 2A
3.3V, 2A
1.5V, 2A
1.2V, 2A

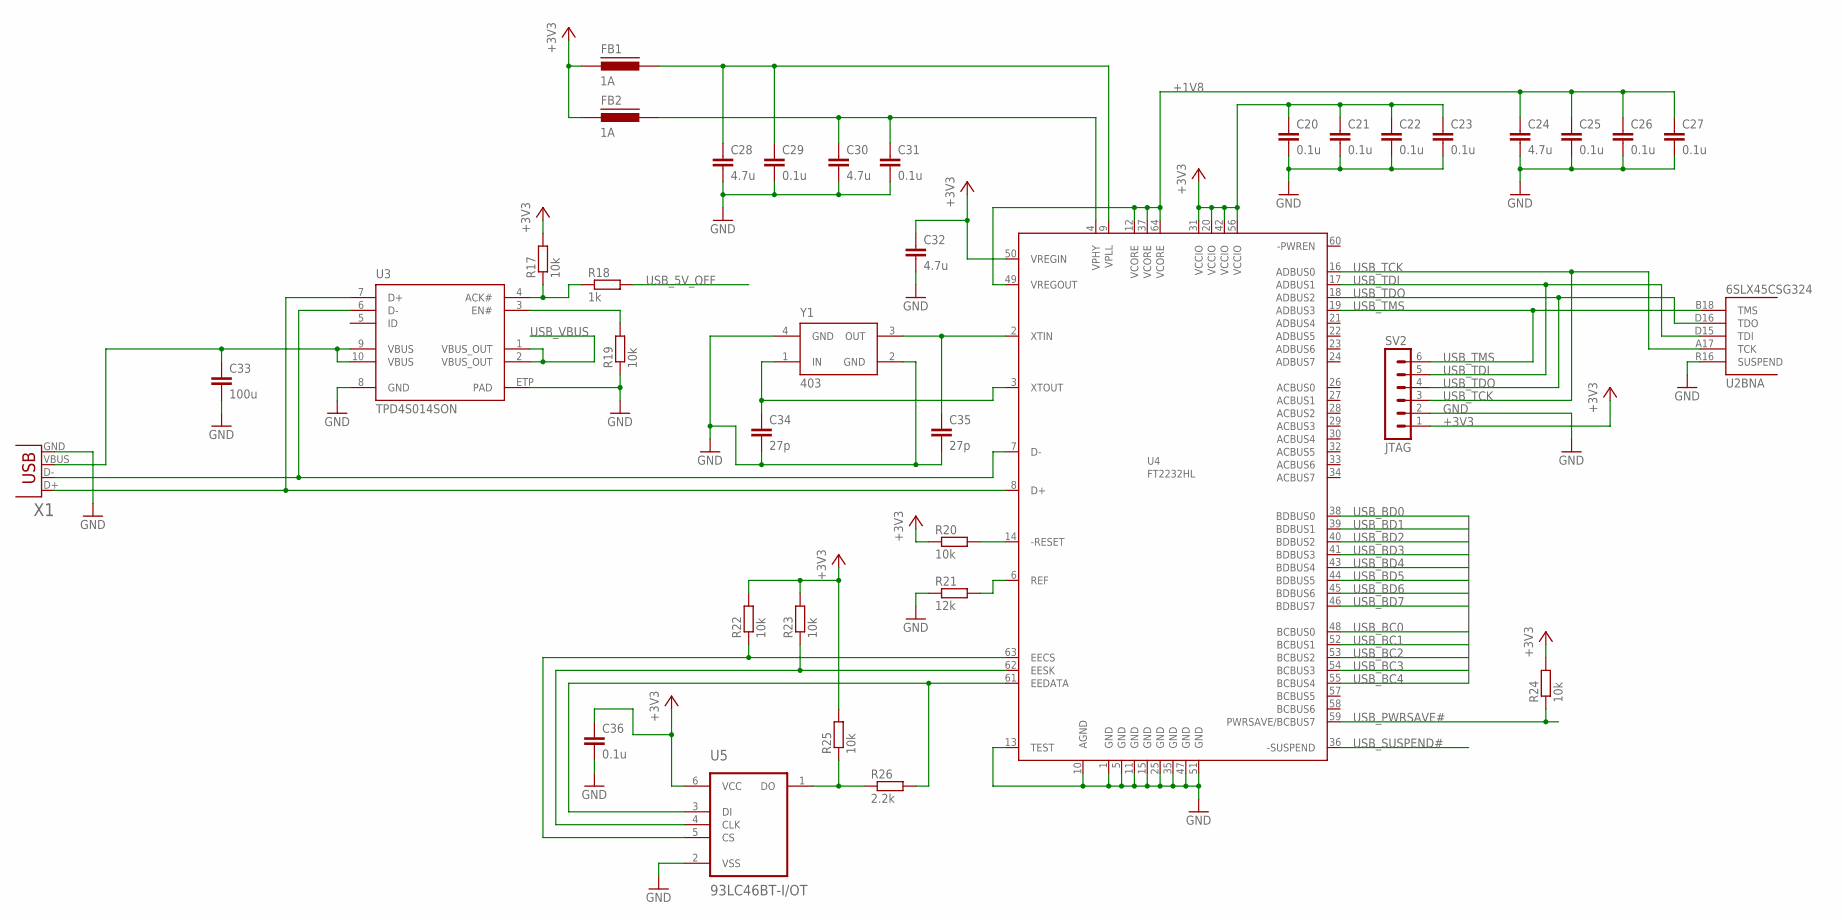
[picture p19: schematic pandaLightPlus.sch, sheet 2, USB]

Parts:
C20, C21, C22, C23, C25, C26, C27, C29, C31, C36: 0.1u; 0402; PARTNO CL05B104KP5NNNC
C24, C28, C30, C32: 4.7u; 0603; PARTNO C0603C475K9PACTU
C33: 100u; 1206; PARTNO CL31A107MQHNNNE
C34, C35: 27p; 0402; PARTNO CL05C270JB5NNNC
FB1, FB2: 1A; 0402; PARTNO BK1005HS100-T
R17, R19, R20, R22, R23, R24, R25: 10k; 0402; PARTNO ERJ-2RKF1002X
R18: 1k; 0402; PARTNO ERJ-2RKF1001X
R21: 12k; 0402; PARTNO ERJ-2RKF1202X
R26: 2.2k; 0402; PARTNO ERJ-2RKF2201X
SV2: JTAG; MA06-1; PARTNO *
U2: 6SLX45CSG324; CS324; PARTNO XC6SLX45-3CSG324C
U3: TPD4S014SON; SON10; PARTNO TPD4S014DSQR
U4: FT2232HL; LQFP64; PARTNO FT2232HL-REEL
U5: 93LC46BT-I/OT; SOT23-6; PARTNO 93LC46BT-I/OT
X1: USBUB-S; USB-UB-S; PARTNO 10118192-0001LF
Y1: 403; 403-3.2X2.5; PARTNO 403C35D12M00000

Connections:
+1V8: C24.1, C25.1, C26.1, C27.1, U4.12 (VCORE), U4.37 (VCORE), U4.49 (VREGOUT), U4.64 (VCORE)
+3V3: C20.1, C21.1, C22.1, C23.1, C32.1, C36.1, FB1.1, FB2.1, R17.2, R20.1, R22.2, R23.2, R24.2, R25.2, SV2.1, U4.20 (VCCIO), U4.31 (VCCIO), U4.42 (VCCIO), U4.50 (VREGIN), U4.56 (VCCIO), U5.6 (VCC); also elsewhere on the board
GND: C20.2, C21.2, C22.2, C23.2, C24.2, C25.2, C26.2, C27.2, C28.2, C29.2, C30.2, C31.2, C32.2, C33.2, C34.2, C35.2, C36.2, R19.1, R21.1, SV2.2, U2.R16 (SUSPEND), U3.8 (GND), U3.ETP (PAD), U4.1 (GND), U4.5 (GND), U4.10 (AGND), U4.11 (GND), U4.13 (TEST), U4.15 (GND), U4.25 (GND), U4.35 (GND), U4.47 (GND), U4.51 (GND), U5.2 (VSS), X1.GND, Y1.2 (GND), Y1.4 (GND); also elsewhere on the board
unnamed: C35.1, U4.2 (XTIN), Y1.3 (OUT)
unnamed: C34.1, U4.3 (XTOUT), Y1.1 (IN)
unnamed: R22.1, U4.63 (EECS), U5.5 (CS)
unnamed: U3.6 (D-), U4.7 (D-), X1.D-
unnamed: U3.7 (D+), U4.8 (D+), X1.D+
unnamed: R23.1, U4.62 (EESK), U5.4 (CLK)
unnamed: R26.2, U4.61 (EEDATA), U5.3 (DI)
unnamed: R21.2, U4.6 (REF)
unnamed: R25.1, R26.1, U5.1 (DO)
unnamed: R20.2, U4.14 (-RESET)
unnamed: C30.1, C31.1, FB2.2, U4.4 (VPHY)
unnamed: C28.1, C29.1, FB1.2, U4.9 (VPLL)
unnamed: C33.1, U3.9 (VBUS), U3.10 (VBUS), X1.VBUS
USB_5V_ACK#: R17.1, R18.1, U3.4 (ACK#)
USB_5V_DISABLE: R19.2, U3.3 (EN#)
USB_5V_OFF: R18.2
USB_BC0: U4.48 (BCBUS0)
USB_BC1: U4.52 (BCBUS1)
USB_BC2: U4.53 (BCBUS2)
USB_BC3: U4.54 (BCBUS3)
USB_BC4: U4.55 (BCBUS4)
USB_BD0: U4.38 (BDBUS0)
USB_BD1: U4.39 (BDBUS1)
USB_BD2: U4.40 (BDBUS2)
USB_BD3: U4.41 (BDBUS3)
USB_BD4: U4.43 (BDBUS4)
USB_BD5: U4.44 (BDBUS5)
USB_BD6: U4.45 (BDBUS6)
USB_BD7: U4.46 (BDBUS7)
USB_PWRSAVE#: R24.1, U4.59 (PWRSAVE/BCBUS7)
USB_SUSPEND#: U4.36 (-SUSPEND)
USB_TCK: SV2.3, U2.A17 (TCK), U4.16 (ADBUS0)
USB_TDI: SV2.5, U2.D15 (TDI), U4.17 (ADBUS1)
USB_TDO: SV2.4, U2.D16 (TDO), U4.18 (ADBUS2)
USB_TMS: SV2.6, U2.B18 (TMS), U4.19 (ADBUS3)
USB_VBUS: U3.1 (VBUS_OUT), U3.2 (VBUS_OUT); also elsewhere on the board

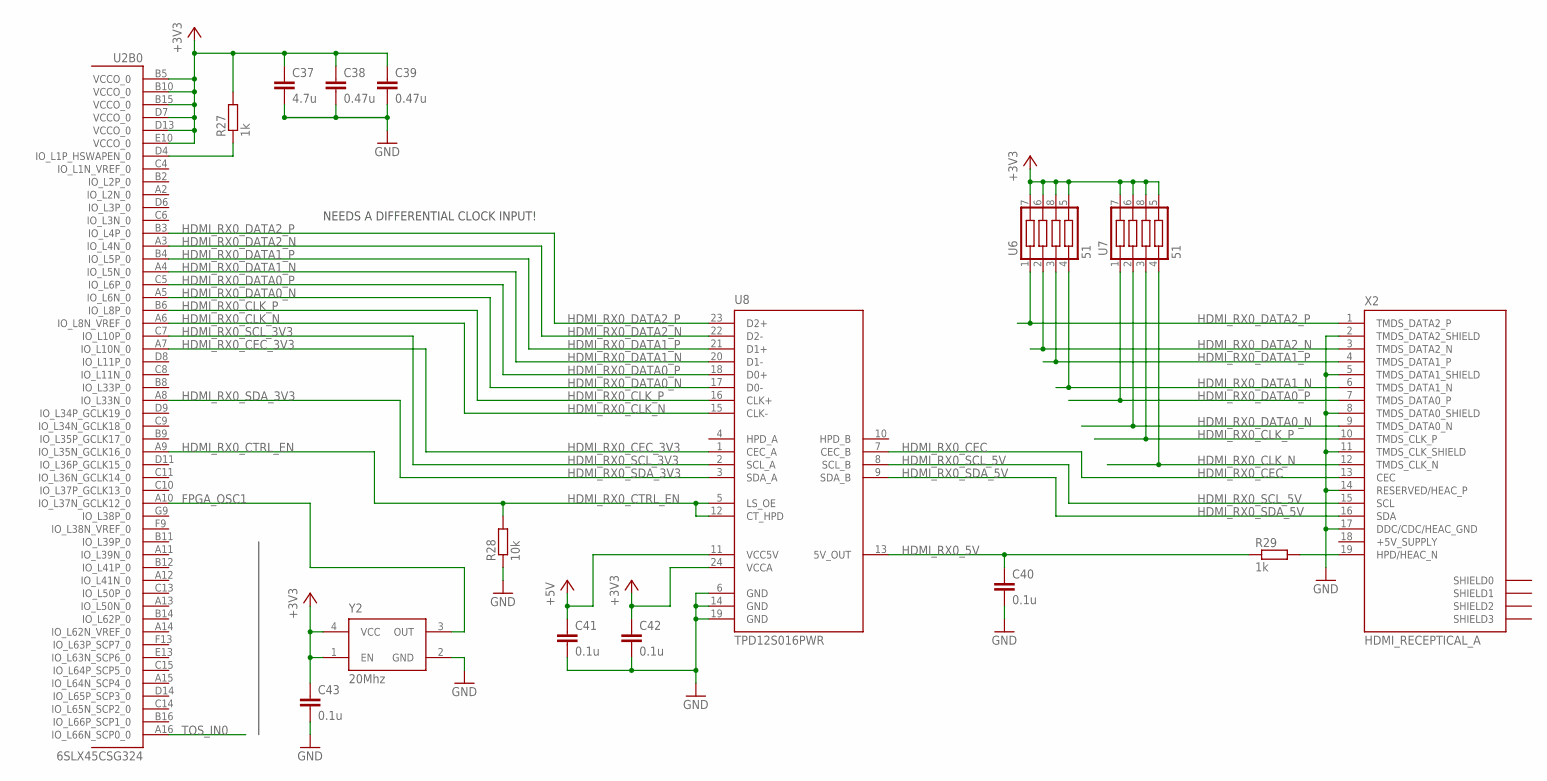
[picture p20: schematic pandaLightPlus.sch, sheet 3, B0, HDMI Rx0]

Parts:
C37: 4.7u; 0603; PARTNO C0603C475K9PACTU
C38, C39: 0.47u; 0402; PARTNO C1005X5R0J474K050BB
C40, C41, C42, C43: 0.1u; 0402; PARTNO CL05B104KP5NNNC
R27, R29: 1k; 0402; PARTNO ERJ-2RKF1001X
R28: 10k; 0402; PARTNO ERJ-2RKF1002X
U2: 6SLX45CSG324; CS324; PARTNO XC6SLX45-3CSG324C
U6, U7: 51; 741C083; PARTNO 741C083510JP
U8: TPD12S016PWR; PW_R-PDSO-G24; PARTNO TPD12S016PWR
X2: HDMI_RECEPTICAL_A; HDMI_TYPE_A_RECEPTICAL; PARTNO 10029449-111RLF
Y2: 20Mhz; 636; PARTNO 636L3C020M00000

Connections:
+3V3: C37.1, C38.1, C39.1, C42.1, C43.1, R27.2, U2.B5 (VCCO_0), U2.B10 (VCCO_0), U2.B15 (VCCO_0), U2.D7 (VCCO_0), U2.D13 (VCCO_0), U2.E10 (VCCO_0), U6.5 (13), U6.6 (15), U6.7 (16), U6.8 (C3), U7.5 (13), U7.6 (15), U7.7 (16), U7.8 (C3), U8.24 (VCCA), Y2.1 (EN), Y2.4 (VCC); also elsewhere on the board
+5V: C41.1, U8.11 (VCC5V); also elsewhere on the board
FPGA_OSC1: U2.A10 (IO_L37N_GCLK12_0), Y2.3 (OUT)
GND: C37.2, C38.2, C39.2, C40.2, C41.2, C42.2, C43.2, R28.1, U8.6 (GND), U8.14 (GND), U8.19 (GND), X2.2 (TMDS_DATA2_SHIELD), X2.5 (TMDS_DATA1_SHIELD), X2.8 (TMDS_DATA0_SHIELD), X2.11 (TMDS_CLK_SHIELD), X2.14 (RESERVED/HEAC_P), X2.17 (DDC/CDC/HEAC_GND), Y2.2 (GND); also elsewhere on the board
HDMI_RX0_5V: C40.1, R29.1, U8.13 (5V_OUT)
HDMI_RX0_CEC: U8.7 (CEC_B), X2.13 (CEC)
HDMI_RX0_CEC_3V3: U2.A7 (IO_L10N_0), U8.1 (CEC_A)
HDMI_RX0_CLK_N: U2.A6 (IO_L8N_VREF_0), U7.4, U8.15 (CLK-), X2.12 (TMDS_CLK_N)
HDMI_RX0_CLK_P: U2.B6 (IO_L8P_0), U7.3, U8.16 (CLK+), X2.10 (TMDS_CLK_P)
HDMI_RX0_CTRL_EN: R28.2, U2.A9 (IO_L35N_GCLK16_0), U8.5 (LS_OE), U8.12 (CT_HPD)
HDMI_RX0_DATA0_N: U2.A5 (IO_L6N_0), U7.2, U8.17 (D0-), X2.9 (TMDS_DATA0_N)
HDMI_RX0_DATA0_P: U2.C5 (IO_L6P_0), U7.1, U8.18 (D0+), X2.7 (TMDS_DATA0_P)
HDMI_RX0_DATA1_N: U2.A4 (IO_L5N_0), U6.4, U8.20 (D1-), X2.6 (TMDS_DATA1_N)
HDMI_RX0_DATA1_P: U2.B4 (IO_L5P_0), U6.3, U8.21 (D1+), X2.4 (TMDS_DATA1_P)
HDMI_RX0_DATA2_N: U2.A3 (IO_L4N_0), U6.2, U8.22 (D2-), X2.3 (TMDS_DATA2_N)
HDMI_RX0_DATA2_P: U2.B3 (IO_L4P_0), U6.1, U8.23 (D2+), X2.1 (TMDS_DATA2_P)
HDMI_RX0_SCL_3V3: U2.C7 (IO_L10P_0), U8.2 (SCL_A)
HDMI_RX0_SCL_5V: U8.8 (SCL_B), X2.15 (SCL)
HDMI_RX0_SDA_3V3: U2.A8 (IO_L33N_0), U8.3 (SDA_A)
HDMI_RX0_SDA_5V: U8.9 (SDA_B), X2.16 (SDA)
unnamed: R27.1, U2.D4 (IO_L1P_HSWAPEN_0)
unnamed: R29.2, X2.19 (HPD/HEAC_N)
TOS_IN0: U2.A16 (IO_L66N_SCP0_0); also elsewhere on the board

Notes on the sheet:
NEEDS A DIFFERENTIAL CLOCK INPUT!

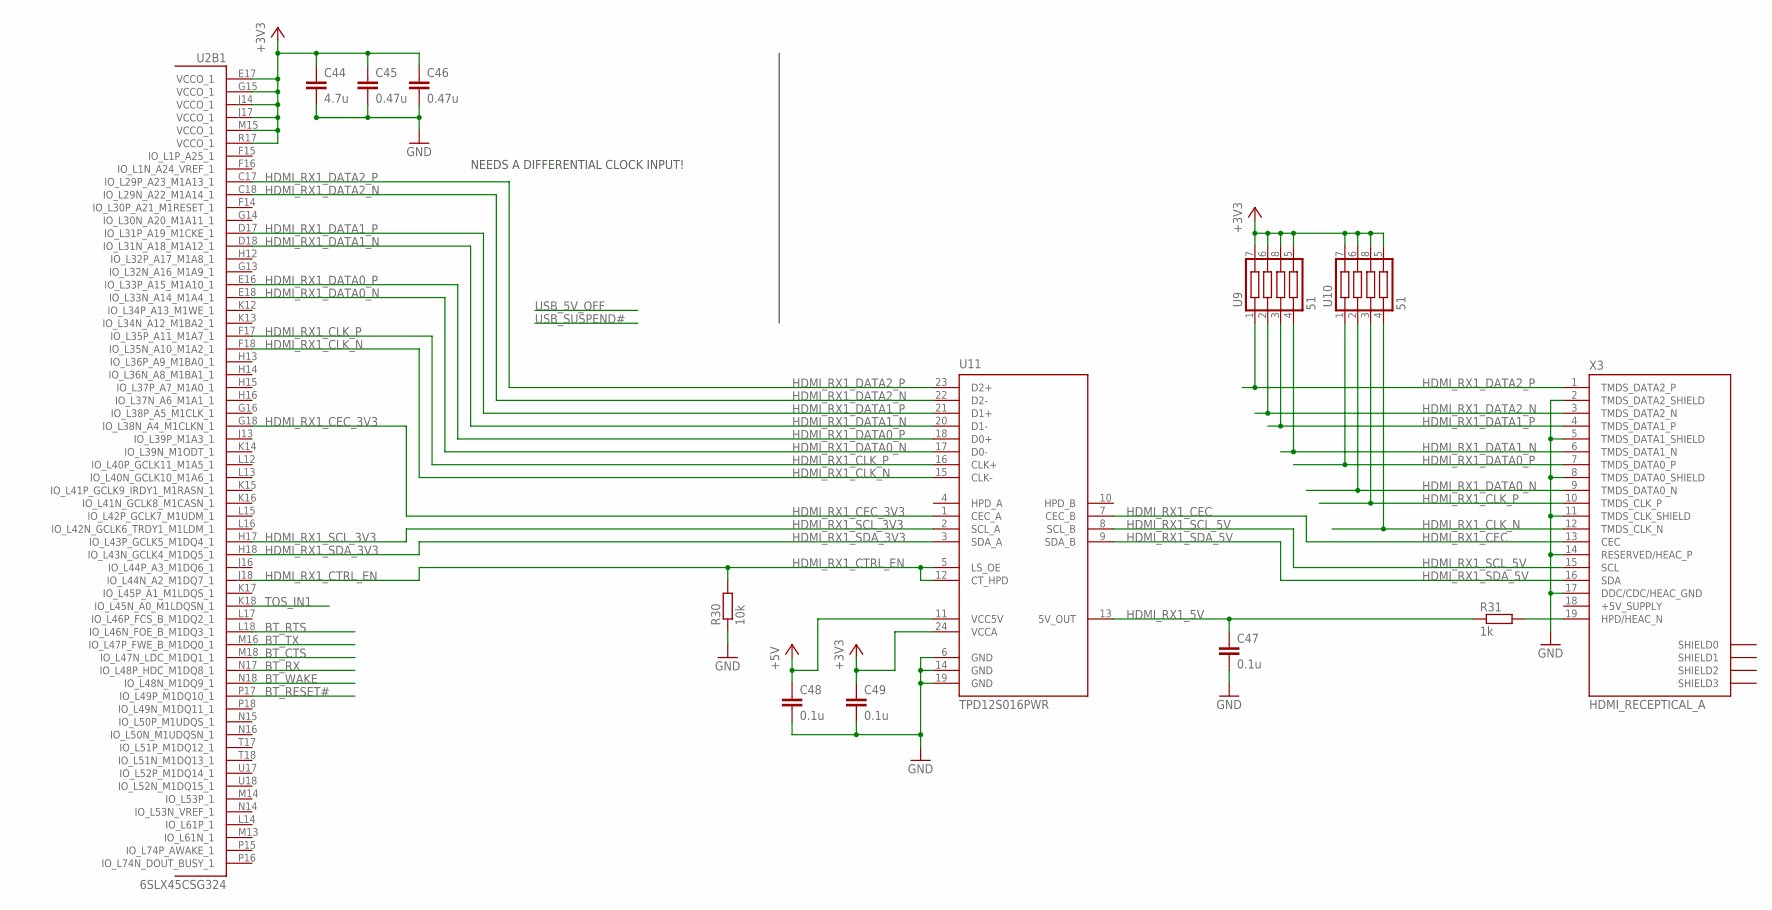
[picture p21: schematic pandaLightPlus.sch, sheet 4, B1, HDMI Rx1]

Parts:
C44: 4.7u; 0603; PARTNO C0603C475K9PACTU
C45, C46: 0.47u; 0402; PARTNO C1005X5R0J474K050BB
C47, C48, C49: 0.1u; 0402; PARTNO CL05B104KP5NNNC
R30: 10k; 0402; PARTNO ERJ-2RKF1002X
R31: 1k; 0402; PARTNO ERJ-2RKF1001X
U2: 6SLX45CSG324; CS324; PARTNO XC6SLX45-3CSG324C
U9, U10: 51; 741C083; PARTNO 741C083510JP
U11: TPD12S016PWR; PW_R-PDSO-G24; PARTNO TPD12S016PWR
X3: HDMI_RECEPTICAL_A; HDMI_TYPE_A_RECEPTICAL; PARTNO 10029449-111RLF

Connections:
+3V3: C44.1, C45.1, C46.1, C49.1, U2.E17 (VCCO_1), U2.G15 (VCCO_1), U2.J14 (VCCO_1), U2.J17 (VCCO_1), U2.M15 (VCCO_1), U2.R17 (VCCO_1), U9.5 (13), U9.6 (15), U9.7 (16), U9.8 (C3), U10.5 (13), U10.6 (15), U10.7 (16), U10.8 (C3), U11.24 (VCCA); also elsewhere on the board
+5V: C48.1, U11.11 (VCC5V); also elsewhere on the board
BT_CTS: U2.M18 (IO_L47N_LDC_M1DQ1_1); also elsewhere on the board
BT_RESET#: U2.P17 (IO_L49P_M1DQ10_1); also elsewhere on the board
BT_RTS: U2.L18 (IO_L46N_FOE_B_M1DQ3_1); also elsewhere on the board
BT_RX: U2.N17 (IO_L48P_HDC_M1DQ8_1); also elsewhere on the board
BT_TX: U2.M16 (IO_L47P_FWE_B_M1DQ0_1); also elsewhere on the board
BT_WAKE: U2.N18 (IO_L48N_M1DQ9_1); also elsewhere on the board
GND: C44.2, C45.2, C46.2, C47.2, C48.2, C49.2, R30.1, U11.6 (GND), U11.14 (GND), U11.19 (GND), X3.2 (TMDS_DATA2_SHIELD), X3.5 (TMDS_DATA1_SHIELD), X3.8 (TMDS_DATA0_SHIELD), X3.11 (TMDS_CLK_SHIELD), X3.14 (RESERVED/HEAC_P), X3.17 (DDC/CDC/HEAC_GND); also elsewhere on the board
HDMI_RX1_5V: C47.1, R31.1, U11.13 (5V_OUT)
HDMI_RX1_CEC: U11.7 (CEC_B), X3.13 (CEC)
HDMI_RX1_CEC_3V3: U2.G18 (IO_L38N_A4_M1CLKN_1), U11.1 (CEC_A)
HDMI_RX1_CLK_N: U2.F18 (IO_L35N_A10_M1A2_1), U10.4, U11.15 (CLK-), X3.12 (TMDS_CLK_N)
HDMI_RX1_CLK_P: U2.F17 (IO_L35P_A11_M1A7_1), U10.3, U11.16 (CLK+), X3.10 (TMDS_CLK_P)
HDMI_RX1_CTRL_EN: R30.2, U2.J18 (IO_L44N_A2_M1DQ7_1), U11.5 (LS_OE), U11.12 (CT_HPD)
HDMI_RX1_DATA0_N: U2.E18 (IO_L33N_A14_M1A4_1), U10.2, U11.17 (D0-), X3.9 (TMDS_DATA0_N)
HDMI_RX1_DATA0_P: U2.E16 (IO_L33P_A15_M1A10_1), U10.1, U11.18 (D0+), X3.7 (TMDS_DATA0_P)
HDMI_RX1_DATA1_N: U2.D18 (IO_L31N_A18_M1A12_1), U9.4, U11.20 (D1-), X3.6 (TMDS_DATA1_N)
HDMI_RX1_DATA1_P: U2.D17 (IO_L31P_A19_M1CKE_1), U9.3, U11.21 (D1+), X3.4 (TMDS_DATA1_P)
HDMI_RX1_DATA2_N: U2.C18 (IO_L29N_A22_M1A14_1), U9.2, U11.22 (D2-), X3.3 (TMDS_DATA2_N)
HDMI_RX1_DATA2_P: U2.C17 (IO_L29P_A23_M1A13_1), U9.1, U11.23 (D2+), X3.1 (TMDS_DATA2_P)
HDMI_RX1_SCL_3V3: U2.H17 (IO_L43P_GCLK5_M1DQ4_1), U11.2 (SCL_A)
HDMI_RX1_SCL_5V: U11.8 (SCL_B), X3.15 (SCL)
HDMI_RX1_SDA_3V3: U2.H18 (IO_L43N_GCLK4_M1DQ5_1), U11.3 (SDA_A)
HDMI_RX1_SDA_5V: U11.9 (SDA_B), X3.16 (SDA)
unnamed: R31.2, X3.19 (HPD/HEAC_N)
TOS_IN1: U2.K18 (IO_L45N_A0_M1LDQSN_1); also elsewhere on the board

Notes on the sheet:
NEEDS A DIFFERENTIAL CLOCK INPUT!

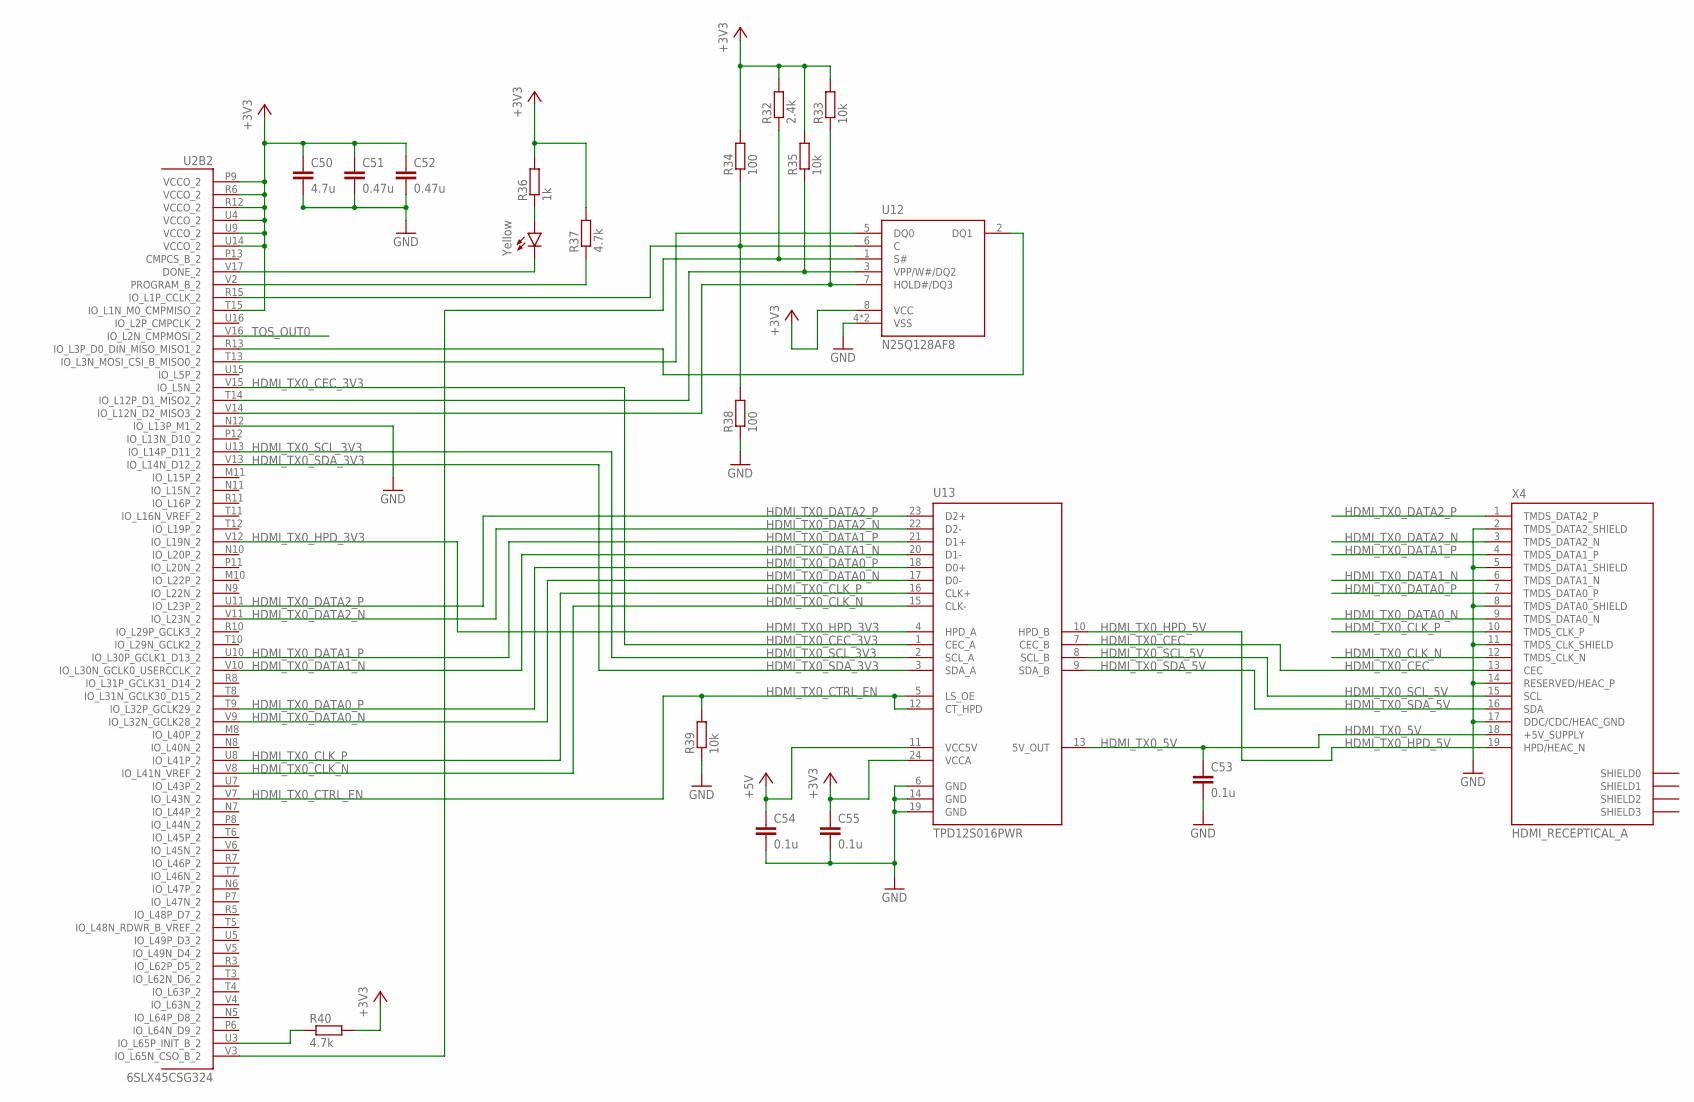
[picture p22: schematic pandaLightPlus.sch, sheet 5, B2, HDMI Tx0]

Parts:
C50: 4.7u; 0603; PARTNO C0603C475K9PACTU
C51, C52: 0.47u; 0402; PARTNO C1005X5R0J474K050BB
C53, C54, C55: 0.1u; 0402; PARTNO CL05B104KP5NNNC
LED2: Yellow; LED-0603; PARTNO LY Q976-P1S2-36
R32: 2.4k; 0402; PARTNO ERJ-2RKF2401X
R33, R35, R39: 10k; 0402; PARTNO ERJ-2RKF1002X
R34, R38: 100; 0402; PARTNO ERJ-2GEJ101X
R36: 1k; 0402; PARTNO ERJ-2RKF1001X
R37, R40: 4.7k; 0402; PARTNO ERJ-2RKF4701X
U2: 6SLX45CSG324; CS324; PARTNO XC6SLX45-3CSG324C
U12: N25Q128AF8; V-PDFN-8_8X6; PARTNO N25Q128A13EF840E
U13: TPD12S016PWR; PW_R-PDSO-G24; PARTNO TPD12S016PWR
X4: HDMI_RECEPTICAL_A; HDMI_TYPE_A_RECEPTICAL; PARTNO 10029449-111RLF

Connections:
+3V3: C50.1, C51.1, C52.1, C55.1, R32.2, R33.2, R34.2, R35.2, R36.2, R37.2, R40.2, U2.P9 (VCCO_2), U2.R6 (VCCO_2), U2.R12 (VCCO_2), U2.T15 (IO_L1N_M0_CMPMISO_2), U2.U4 (VCCO_2), U2.U9 (VCCO_2), U2.U14 (VCCO_2), U12.8 (VCC), U13.24 (VCCA); also elsewhere on the board
+5V: C54.1, U13.11 (VCC5V); also elsewhere on the board
GND: C50.2, C51.2, C52.2, C53.2, C54.2, C55.2, R38.1, R39.1, U2.N12 (IO_L13P_M1_2), U12.4 (VSS), U12.ETP (VSS), U13.6 (GND), U13.14 (GND), U13.19 (GND), X4.2 (TMDS_DATA2_SHIELD), X4.5 (TMDS_DATA1_SHIELD), X4.8 (TMDS_DATA0_SHIELD), X4.11 (TMDS_CLK_SHIELD), X4.14 (RESERVED/HEAC_P), X4.17 (DDC/CDC/HEAC_GND); also elsewhere on the board
HDMI_TX0_5V: C53.1, U13.13 (5V_OUT), X4.18 (+5V_SUPPLY)
HDMI_TX0_CEC: U13.7 (CEC_B), X4.13 (CEC)
HDMI_TX0_CEC_3V3: U2.V15 (IO_L5N_2), U13.1 (CEC_A)
HDMI_TX0_CLK_N: U2.V8 (IO_L41N_VREF_2), U13.15 (CLK-), X4.12 (TMDS_CLK_N)
HDMI_TX0_CLK_P: U2.U8 (IO_L41P_2), U13.16 (CLK+), X4.10 (TMDS_CLK_P)
HDMI_TX0_CTRL_EN: R39.2, U2.V7 (IO_L43N_2), U13.5 (LS_OE), U13.12 (CT_HPD)
HDMI_TX0_DATA0_N: U2.V9 (IO_L32N_GCLK28_2), U13.17 (D0-), X4.9 (TMDS_DATA0_N)
HDMI_TX0_DATA0_P: U2.T9 (IO_L32P_GCLK29_2), U13.18 (D0+), X4.7 (TMDS_DATA0_P)
HDMI_TX0_DATA1_N: U2.V10 (IO_L30N_GCLK0_USERCCLK_2), U13.20 (D1-), X4.6 (TMDS_DATA1_N)
HDMI_TX0_DATA1_P: U2.U10 (IO_L30P_GCLK1_D13_2), U13.21 (D1+), X4.4 (TMDS_DATA1_P)
HDMI_TX0_DATA2_N: U2.V11 (IO_L23N_2), U13.22 (D2-), X4.3 (TMDS_DATA2_N)
HDMI_TX0_DATA2_P: U2.U11 (IO_L23P_2), U13.23 (D2+), X4.1 (TMDS_DATA2_P)
HDMI_TX0_HPD_3V3: U2.V12 (IO_L19N_2), U13.4 (HPD_A)
HDMI_TX0_HPD_5V: U13.10 (HPD_B), X4.19 (HPD/HEAC_N)
HDMI_TX0_SCL_3V3: U2.U13 (IO_L14P_D11_2), U13.2 (SCL_A)
HDMI_TX0_SCL_5V: U13.8 (SCL_B), X4.15 (SCL)
HDMI_TX0_SDA_3V3: U2.V13 (IO_L14N_D12_2), U13.3 (SDA_A)
HDMI_TX0_SDA_5V: U13.9 (SDA_B), X4.16 (SDA)
unnamed: LED2.C, U2.V17 (DONE_2)
unnamed: R37.1, U2.V2 (PROGRAM_B_2)
unnamed: LED2.A, R36.1
unnamed: R40.1, U2.U3 (IO_L65P_INIT_B_2)
unnamed: U2.T13 (IO_L3N_MOSI_CSI_B_MISO0_2), U12.5 (DQ0)
unnamed: R32.1, U2.V3 (IO_L65N_CSO_B_2), U12.1 (S#)
unnamed: R34.1, R38.2, U2.R15 (IO_L1P_CCLK_2), U12.6 (C)
unnamed: U2.R13 (IO_L3P_D0_DIN_MISO_MISO1_2), U12.2 (DQ1)
unnamed: R35.1, U2.T14 (IO_L12P_D1_MISO2_2), U12.3 (VPP/W#/DQ2)
unnamed: R33.1, U2.V14 (IO_L12N_D2_MISO3_2), U12.7 (HOLD#/DQ3)
TOS_OUT0: U2.V16 (IO_L2N_CMPMOSI_2); also elsewhere on the board

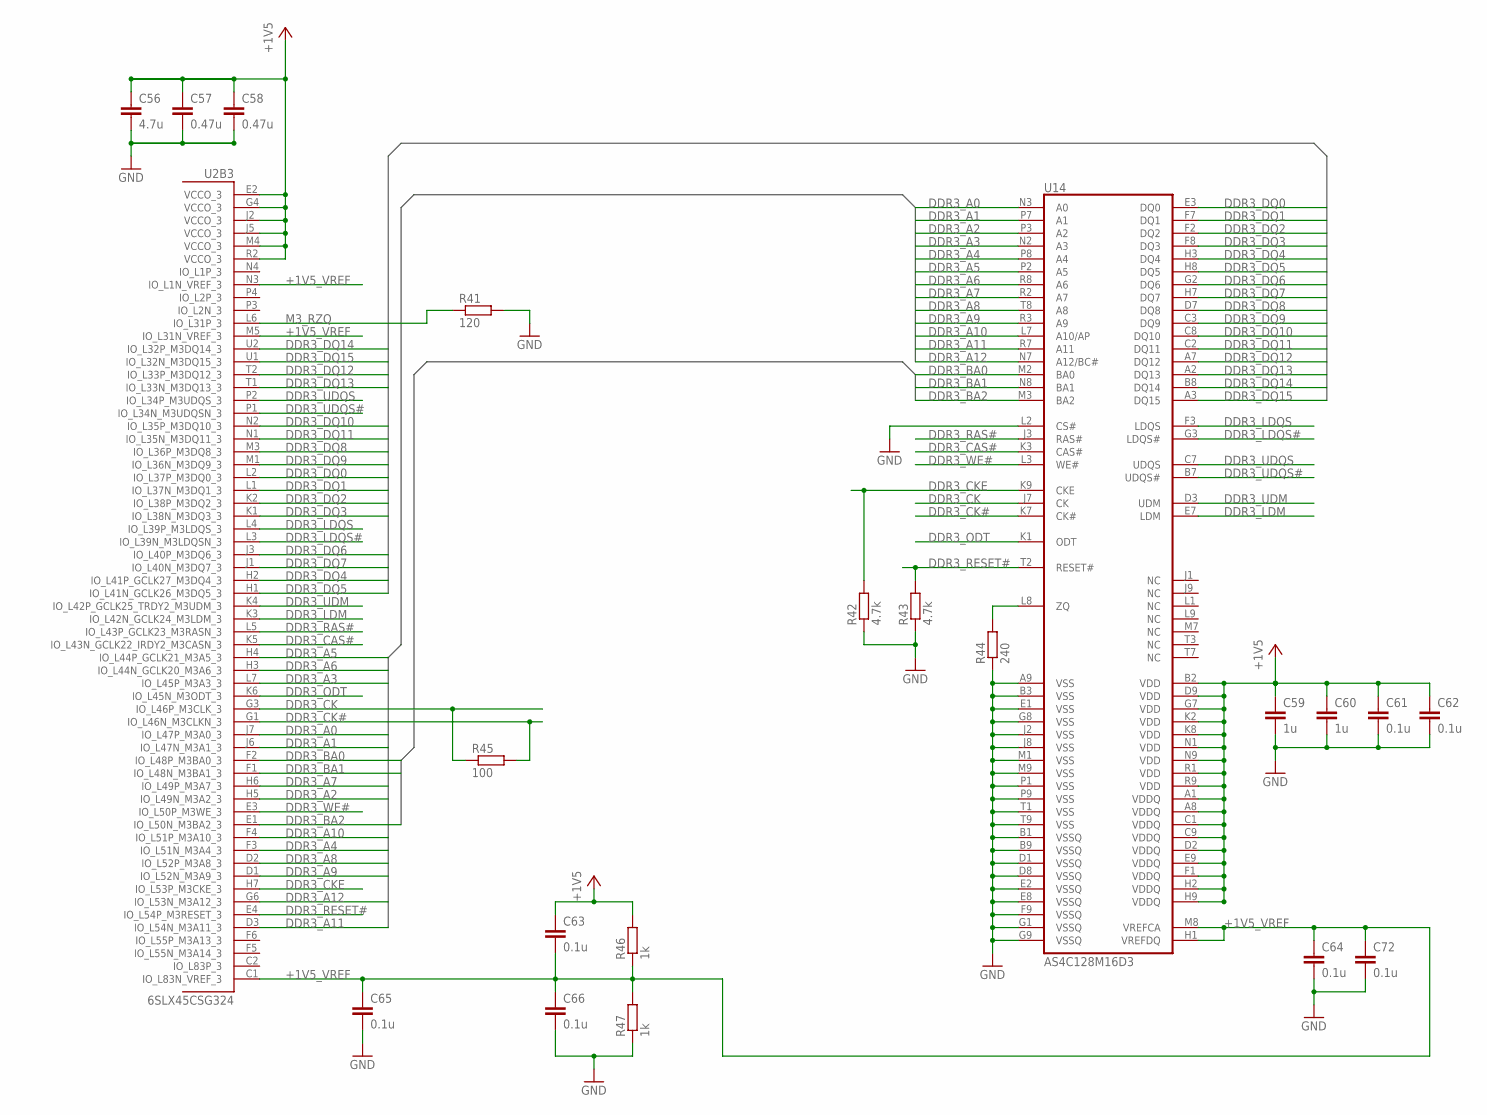
[picture p23: schematic pandaLightPlus.sch, sheet 6, B3, DDR3]

Parts:
C56: 4.7u; 0603; PARTNO C0603C475K9PACTU
C57, C58: 0.47u; 0402; PARTNO C1005X5R0J474K050BB
C59, C60: 1u; 0402; PARTNO C1005X5R0J105M050BB
C61, C62, C63, C64, C65, C66, C72: 0.1u; 0402; PARTNO CL05B104KP5NNNC
R41: 120; 0402; PARTNO ERJ-2RKF1200X
R42, R43: 4.7k; 0402; PARTNO ERJ-2RKF4701X
R44: 240; 0402; PARTNO ERJ-2RKF2400X
R45: 100; 0402; PARTNO ERJ-2GEJ101X
R46, R47: 1k; 0402; PARTNO ERJ-2RKF1001X
U2: 6SLX45CSG324; CS324; PARTNO XC6SLX45-3CSG324C
U14: AS4C128M16D3; 96-FBGA_13X9; PARTNO AS4C128M16D3-12BCN

Connections:
+1V5: C56.1, C57.1, C58.1, C59.1, C60.1, C61.1, C62.1, C63.1, R46.2, U2.E2 (VCCO_3), U2.G4 (VCCO_3), U2.J2 (VCCO_3), U2.J5 (VCCO_3), U2.M4 (VCCO_3), U2.R2 (VCCO_3), U14.A1 (VDDQ), U14.A8 (VDDQ), U14.B2 (VDD), U14.C1 (VDDQ), U14.C9 (VDDQ), U14.D2 (VDDQ), U14.D9 (VDD), U14.E9 (VDDQ), U14.F1 (VDDQ), U14.G7 (VDD), U14.H2 (VDDQ), U14.H9 (VDDQ), U14.K2 (VDD), U14.K8 (VDD), U14.N1 (VDD), U14.N9 (VDD), U14.R1 (VDD), U14.R9 (VDD); also elsewhere on the board
+1V5_VREF: C63.2, C64.1, C65.1, C66.1, C72.1, R46.1, R47.2, U2.C1 (IO_L83N_VREF_3), U2.M5 (IO_L31N_VREF_3), U2.N3 (IO_L1N_VREF_3), U14.H1 (VREFDQ), U14.M8 (VREFCA)
DDR3_A0: U2.J7 (IO_L47P_M3A0_3), U14.N3 (A0)
DDR3_A1: U2.J6 (IO_L47N_M3A1_3), U14.P7 (A1)
DDR3_A2: U2.H5 (IO_L49N_M3A2_3), U14.P3 (A2)
DDR3_A3: U2.L7 (IO_L45P_M3A3_3), U14.N2 (A3)
DDR3_A4: U2.F3 (IO_L51N_M3A4_3), U14.P8 (A4)
DDR3_A5: U2.H4 (IO_L44P_GCLK21_M3A5_3), U14.P2 (A5)
DDR3_A6: U2.H3 (IO_L44N_GCLK20_M3A6_3), U14.R8 (A6)
DDR3_A7: U2.H6 (IO_L49P_M3A7_3), U14.R2 (A7)
DDR3_A8: U2.D2 (IO_L52P_M3A8_3), U14.T8 (A8)
DDR3_A9: U2.D1 (IO_L52N_M3A9_3), U14.R3 (A9)
DDR3_A10: U2.F4 (IO_L51P_M3A10_3), U14.L7 (A10/AP)
DDR3_A11: U2.D3 (IO_L54N_M3A11_3), U14.R7 (A11)
DDR3_A12: U2.G6 (IO_L53N_M3A12_3), U14.N7 (A12/BC#)
DDR3_BA0: U2.F2 (IO_L48P_M3BA0_3), U14.M2 (BA0)
DDR3_BA1: U2.F1 (IO_L48N_M3BA1_3), U14.N8 (BA1)
DDR3_BA2: U2.E1 (IO_L50N_M3BA2_3), U14.M3 (BA2)
DDR3_CAS#: U2.K5 (IO_L43N_GCLK22_IRDY2_M3CASN_3), U14.K3 (CAS#)
DDR3_CK: R45.1, U2.G3 (IO_L46P_M3CLK_3), U14.J7 (CK)
DDR3_CK#: R45.2, U2.G1 (IO_L46N_M3CLKN_3), U14.K7 (CK#)
DDR3_CKE: R42.2, U2.H7 (IO_L53P_M3CKE_3), U14.K9 (CKE)
DDR3_DQ0: U2.L2 (IO_L37P_M3DQ0_3), U14.E3 (DQ0)
DDR3_DQ1: U2.L1 (IO_L37N_M3DQ1_3), U14.F7 (DQ1)
DDR3_DQ2: U2.K2 (IO_L38P_M3DQ2_3), U14.F2 (DQ2)
DDR3_DQ3: U2.K1 (IO_L38N_M3DQ3_3), U14.F8 (DQ3)
DDR3_DQ4: U2.H2 (IO_L41P_GCLK27_M3DQ4_3), U14.H3 (DQ4)
DDR3_DQ5: U2.H1 (IO_L41N_GCLK26_M3DQ5_3), U14.H8 (DQ5)
DDR3_DQ6: U2.J3 (IO_L40P_M3DQ6_3), U14.G2 (DQ6)
DDR3_DQ7: U2.J1 (IO_L40N_M3DQ7_3), U14.H7 (DQ7)
DDR3_DQ8: U2.M3 (IO_L36P_M3DQ8_3), U14.D7 (DQ8)
DDR3_DQ9: U2.M1 (IO_L36N_M3DQ9_3), U14.C3 (DQ9)
DDR3_DQ10: U2.N2 (IO_L35P_M3DQ10_3), U14.C8 (DQ10)
DDR3_DQ11: U2.N1 (IO_L35N_M3DQ11_3), U14.C2 (DQ11)
DDR3_DQ12: U2.T2 (IO_L33P_M3DQ12_3), U14.A7 (DQ12)
DDR3_DQ13: U2.T1 (IO_L33N_M3DQ13_3), U14.A2 (DQ13)
DDR3_DQ14: U2.U2 (IO_L32P_M3DQ14_3), U14.B8 (DQ14)
DDR3_DQ15: U2.U1 (IO_L32N_M3DQ15_3), U14.A3 (DQ15)
DDR3_LDM: U2.K3 (IO_L42N_GCLK24_M3LDM_3), U14.E7 (LDM)
DDR3_LDQS: U2.L4 (IO_L39P_M3LDQS_3), U14.F3 (LDQS)
DDR3_LDQS#: U2.L3 (IO_L39N_M3LDQSN_3), U14.G3 (LDQS#)
DDR3_ODT: U2.K6 (IO_L45N_M3ODT_3), U14.K1 (ODT)
DDR3_RAS#: U2.L5 (IO_L43P_GCLK23_M3RASN_3), U14.J3 (RAS#)
DDR3_RESET#: R43.2, U2.E4 (IO_L54P_M3RESET_3), U14.T2 (RESET#)
DDR3_UDM: U2.K4 (IO_L42P_GCLK25_TRDY2_M3UDM_3), U14.D3 (UDM)
DDR3_UDQS: U2.P2 (IO_L34P_M3UDQS_3), U14.C7 (UDQS)
DDR3_UDQS#: U2.P1 (IO_L34N_M3UDQSN_3), U14.B7 (UDQS#)
DDR3_WE#: U2.E3 (IO_L50P_M3WE_3), U14.L3 (WE#)
GND: C56.2, C57.2, C58.2, C59.2, C60.2, C61.2, C62.2, C64.2, C65.2, C66.2, C72.2, R41.2, R42.1, R43.1, R44.1, R47.1, U14.A9 (VSS), U14.B1 (VSSQ), U14.B3 (VSS), U14.B9 (VSSQ), U14.D1 (VSSQ), U14.D8 (VSSQ), U14.E1 (VSS), U14.E2 (VSSQ), U14.E8 (VSSQ), U14.F9 (VSSQ), U14.G1 (VSSQ), U14.G8 (VSS), U14.G9 (VSSQ), U14.J2 (VSS), U14.J8 (VSS), U14.L2 (CS#), U14.M1 (VSS), U14.M9 (VSS), U14.P1 (VSS), U14.P9 (VSS), U14.T1 (VSS), U14.T9 (VSS); also elsewhere on the board
M3_RZQ: R41.1, U2.L6 (IO_L31P_3)
unnamed: R44.2, U14.L8 (ZQ)

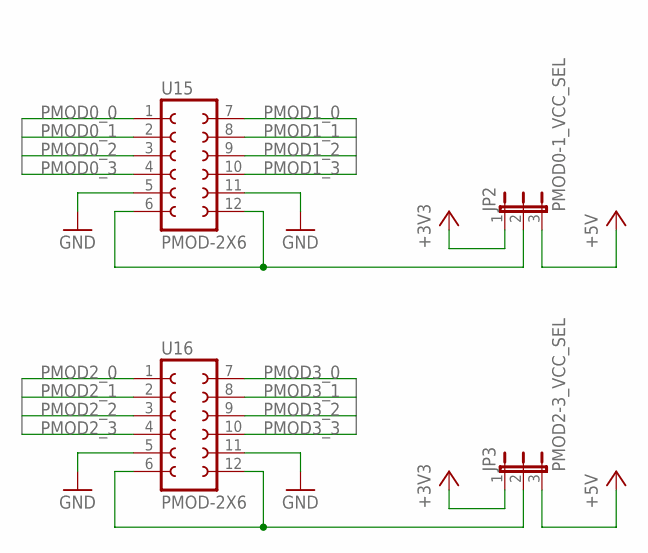
[picture p24: schematic pandaLightPlus.sch, sheet 7, PMOD]

Parts:
JP2: PMOD0-1_VCC_SEL; JP2; PARTNO *
JP3: PMOD2-3_VCC_SEL; JP2; PARTNO *
U15, U16: PMOD-2X6; PARTNO PPTC062LJBN-RC

Connections:
+3V3: JP2.1, JP3.1; also elsewhere on the board
+5V: JP2.3, JP3.3; also elsewhere on the board
GND: U15.5, U15.11, U16.5, U16.11; also elsewhere on the board
unnamed: JP3.2, U16.6, U16.12
unnamed: JP2.2, U15.6, U15.12
PMOD0_0: U15.1
PMOD0_1: U15.2
PMOD0_2: U15.3
PMOD0_3: U15.4
PMOD1_0: U15.7
PMOD1_1: U15.8
PMOD1_2: U15.9
PMOD1_3: U15.10
PMOD2_0: U16.1
PMOD2_1: U16.2
PMOD2_2: U16.3
PMOD2_3: U16.4
PMOD3_0: U16.7
PMOD3_1: U16.8
PMOD3_2: U16.9
PMOD3_3: U16.10

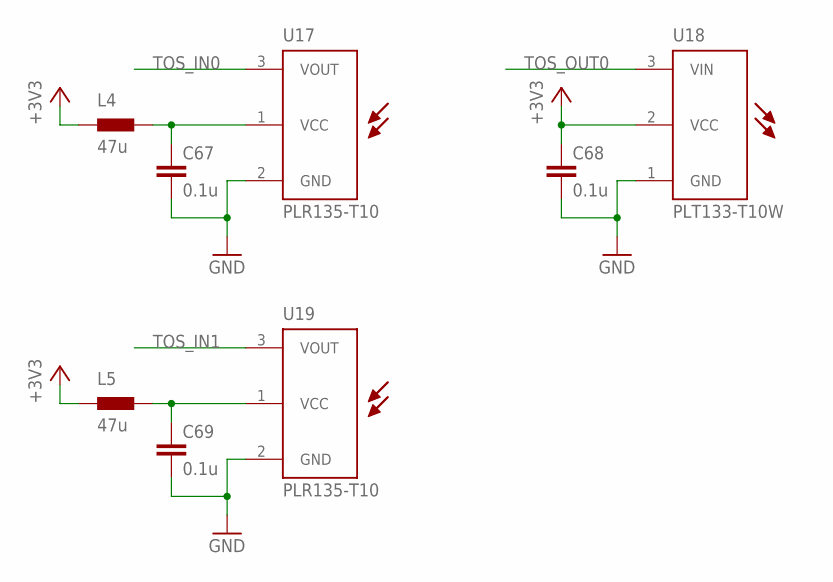
[picture p25: schematic pandaLightPlus.sch, sheet 8, Audio]

Parts:
C67, C68, C69: 0.1u; 0402; PARTNO CL05B104KP5NNNC
L4, L5: 47u; 0603; PARTNO GLFR1608T470M-LR
U17, U19: PLR135-T10; PLR135-T10_PLT133-T10W; PARTNO PLR135/T10
U18: PLT133-T10W; PLR135-T10_PLT133-T10W; PARTNO PLT133/T10W

Connections:
+3V3: C68.1, L4.1, L5.1, U18.2 (VCC); also elsewhere on the board
GND: C67.2, C68.2, C69.2, U17.2 (GND), U18.1 (GND), U19.2 (GND); also elsewhere on the board
unnamed: C69.1, L5.2, U19.1 (VCC)
unnamed: C67.1, L4.2, U17.1 (VCC)
TOS_IN0: U17.3 (VOUT); also elsewhere on the board
TOS_IN1: U19.3 (VOUT); also elsewhere on the board
TOS_OUT0: U18.3 (VIN); also elsewhere on the board
