panda73111/HDMI-eagle/pandaLightPlus/pandaLightPlus.brd

## EAGLE design pandaLightPlus/pandaLightPlus.brd (continued)

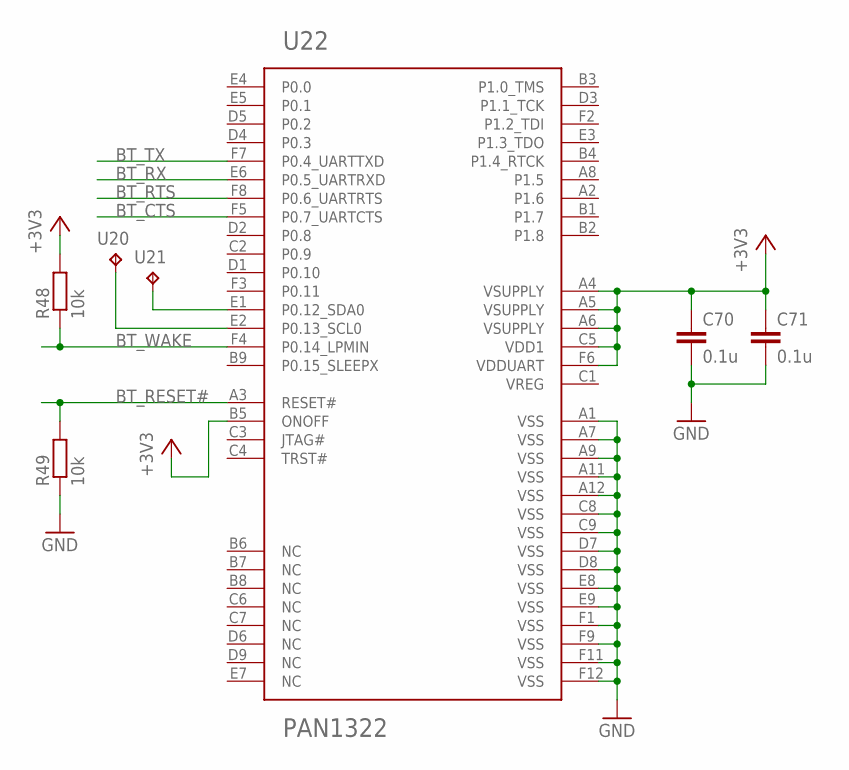
[picture p26: schematic pandaLightPlus.sch, sheet 9, Bluetooth]

Parts:
C70, C71: 0.1u; 0402; PARTNO CL05B104KP5NNNC
R48, R49: 10k; 0402; PARTNO ERJ-2RKF1002X
U20, U21: TP10SQ; PARTNO *
U22: PAN1322; PARTNO ENW-89841A3KF

Connections:
+3V3: C70.1, C71.1, R48.2, U22.A4 (VSUPPLY), U22.A5 (VSUPPLY), U22.A6 (VSUPPLY), U22.B5 (ONOFF), U22.C5 (VDD1), U22.F6 (VDDUART); also elsewhere on the board
BT_CTS: U22.F5 (P0.7_UARTCTS); also elsewhere on the board
BT_RESET#: R49.2, U22.A3 (RESET#); also elsewhere on the board
BT_RTS: U22.F8 (P0.6_UARTRTS); also elsewhere on the board
BT_RX: U22.E6 (P0.5_UARTRXD); also elsewhere on the board
BT_TX: U22.F7 (P0.4_UARTTXD); also elsewhere on the board
BT_WAKE: R48.1, U22.F4 (P0.14_LPMIN); also elsewhere on the board
GND: C70.2, C71.2, R49.1, U22.A1 (VSS), U22.A7 (VSS), U22.A9 (VSS), U22.A11 (VSS), U22.A12 (VSS), U22.C8 (VSS), U22.C9 (VSS), U22.D7 (VSS), U22.D8 (VSS), U22.E8 (VSS), U22.E9 (VSS), U22.F1 (VSS), U22.F9 (VSS), U22.F11 (VSS), U22.F12 (VSS); also elsewhere on the board
unnamed: U21.TP, U22.E1 (P0.12_SDA0)
unnamed: U20.TP, U22.E2 (P0.13_SCL0)

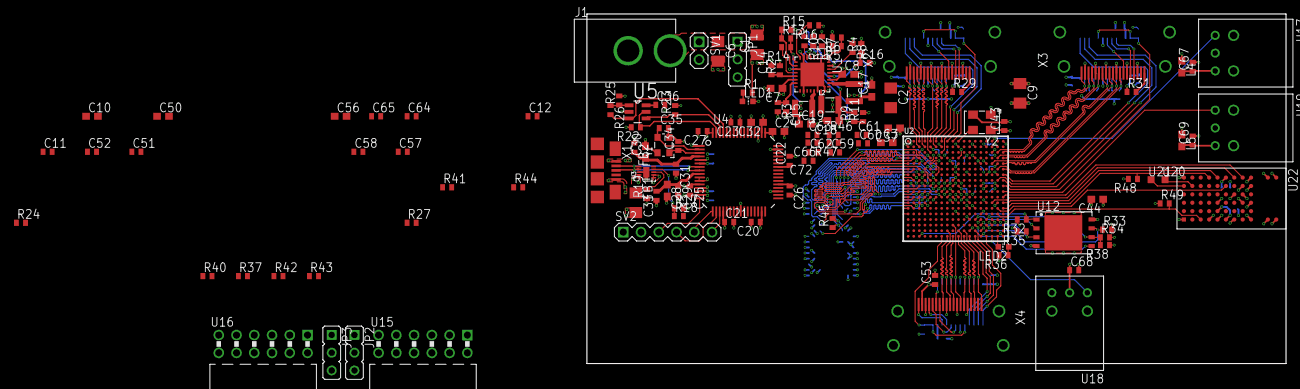
[picture p27: board pandaLightPlus.brd from above]

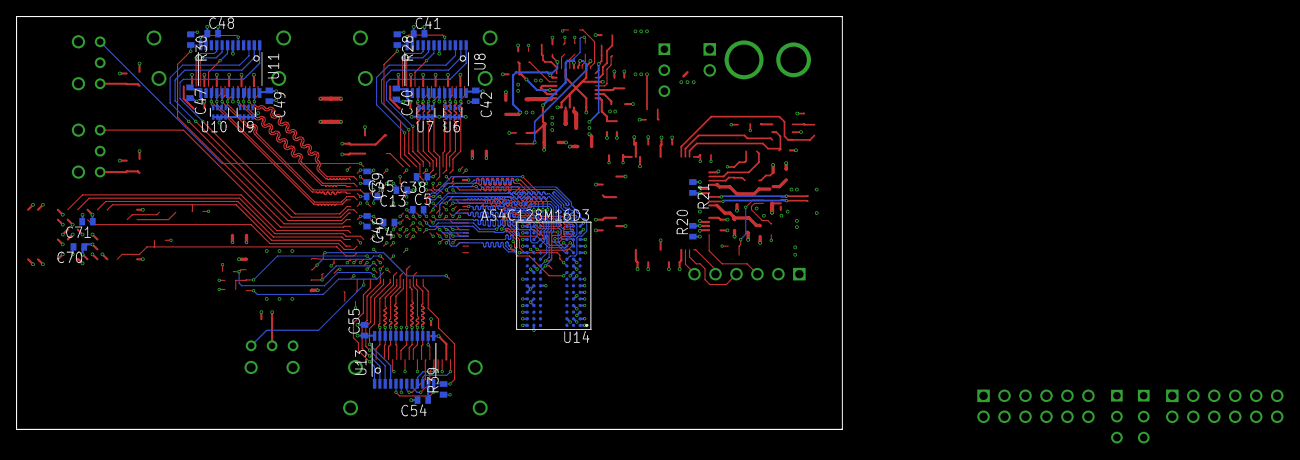
[picture p28: board pandaLightPlus.brd from below]

Board: 4 copper layers, 100.0 x 50.0 mm, 164 parts (30 on the bottom side), 172 nets.
