panda73111/HDMI-eagle/hdmi.brd

## EAGLE design hdmi.brd (2014-05-30)

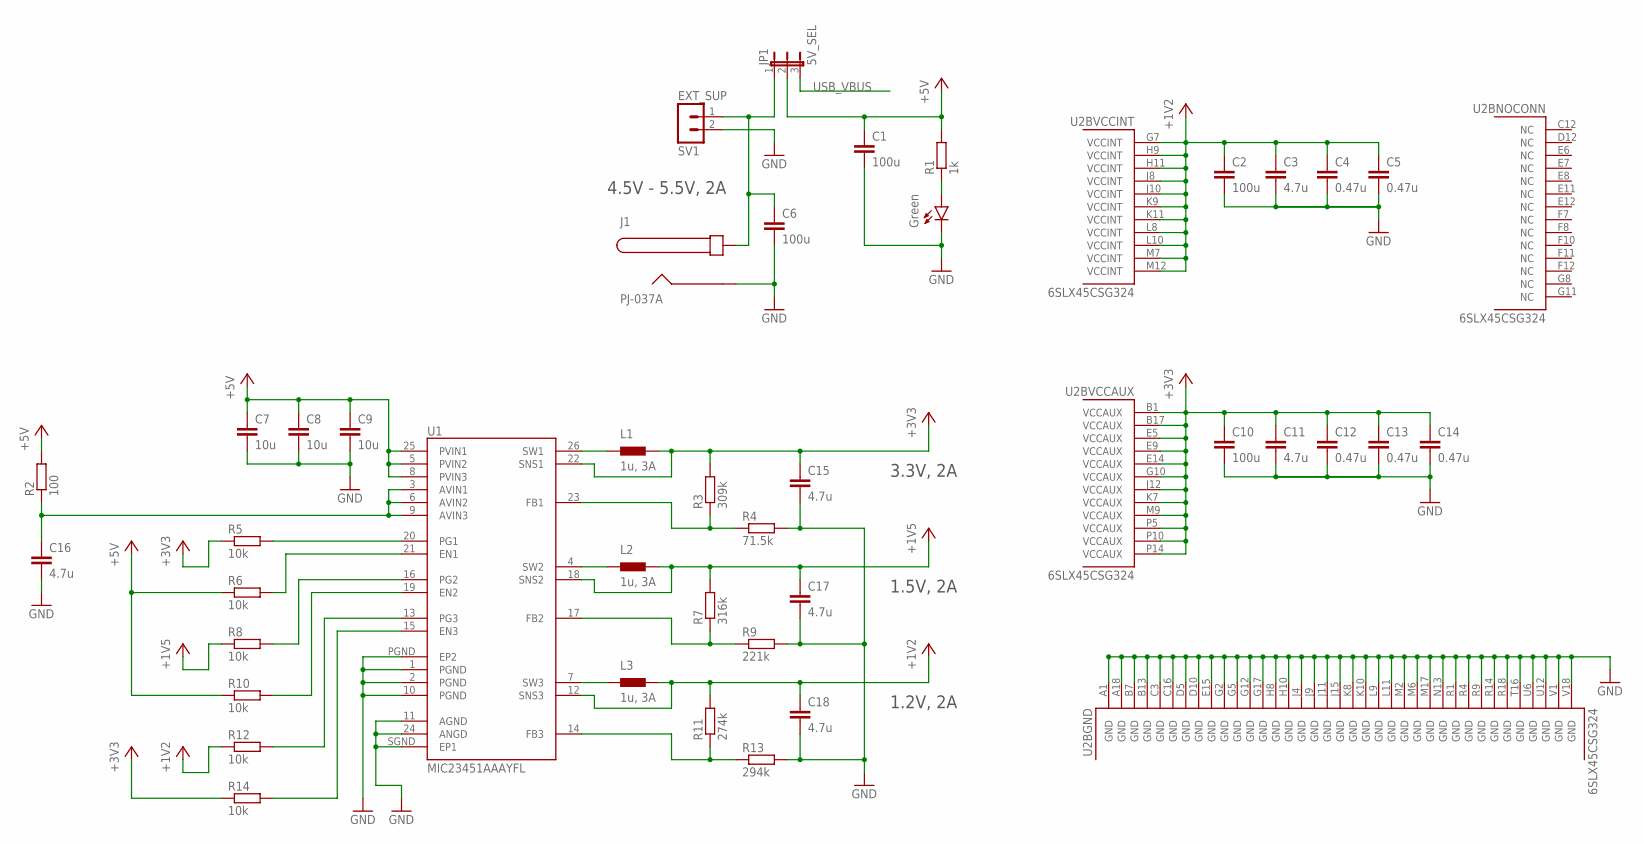
[picture p29: schematic hdmi.sch, sheet 1, Power]

Parts:
C1, C2, C6, C10: 100u; 1206
C3, C11, C15, C16, C17, C18: 4.7u; 0402
C4, C5, C12, C13, C14: 0.47u; 0402
C7, C8, C9: 10u; 0402
J1: PJ-037A
JP1: 5V_SEL; JP2
L1, L2, L3: 1u, 3A; 1008
LED1: Green; LED-0603
R1: 1k; 0402
R2: 100; 0402
R3: 309k; 0402
R4: 71.5k; 0402
R5, R6, R8, R10, R12, R14: 10k; 0402
R7: 316k; 0402
R9: 221k; 0402
R11: 274k; 0402
R13: 294k; 0402
SV1: EXT_SUP; MA02-1
U1: MIC23451AAAYFL; QFN-26-4X4
U2: 6SLX45CSG324; CS324

Connections:
+1V2: C2.1, C3.1, C4.1, C5.1, C18.1, L3.2, R11.2, R12.1, U1.12 (SNS3), U2.G7 (VCCINT), U2.H9 (VCCINT), U2.H11 (VCCINT), U2.J8 (VCCINT), U2.J10 (VCCINT), U2.K9 (VCCINT), U2.K11 (VCCINT), U2.L8 (VCCINT), U2.L10 (VCCINT), U2.M7 (VCCINT), U2.M12 (VCCINT)
+1V5: C17.1, L2.2, R7.2, R8.1, U1.18 (SNS2); also elsewhere on the board
+3V3: C10.1, C11.1, C12.1, C13.1, C14.1, C15.1, L1.2, R3.2, R5.1, R14.1, U1.22 (SNS1), U2.B1 (VCCAUX), U2.B17 (VCCAUX), U2.E5 (VCCAUX), U2.E9 (VCCAUX), U2.E14 (VCCAUX), U2.G10 (VCCAUX), U2.J12 (VCCAUX), U2.K7 (VCCAUX), U2.M9 (VCCAUX), U2.P5 (VCCAUX), U2.P10 (VCCAUX), U2.P14 (VCCAUX); also elsewhere on the board
+5V: C1.1, C7.1, C8.1, C9.1, JP1.2, R1.2, R2.2, R6.1, R10.1, U1.5 (PVIN2), U1.8 (PVIN3), U1.25 (PVIN1); also elsewhere on the board
CENTER: C6.1, J1.CENTER, JP1.1, SV1.1
GND: C1.2, C2.2, C3.2, C4.2, C5.2, C6.2, C7.2, C8.2, C9.2, C10.2, C11.2, C12.2, C13.2, C14.2, C15.2, C16.2, C17.2, C18.2, J1.BARREL, LED1.C, R4.2, R9.2, R13.2, SV1.2, U1.1 (PGND), U1.2 (PGND), U1.10 (PGND), U1.11 (AGND), U1.24 (ANGD), U1.PGND (EP2), U1.SGND (EP1), U2.A1 (GND), U2.A18 (GND), U2.B7 (GND), U2.B13 (GND), U2.C3 (GND), U2.C16 (GND), U2.D5 (GND), U2.D10 (GND), U2.E15 (GND), U2.G2 (GND), U2.G5 (GND), U2.G12 (GND), U2.G17 (GND), U2.H8 (GND), U2.H10 (GND), U2.J4 (GND), U2.J9 (GND), U2.J11 (GND), U2.J15 (GND), U2.K8 (GND), U2.K10 (GND), U2.L9 (GND), U2.L11 (GND), U2.M2 (GND), U2.M6 (GND), U2.M17 (GND), U2.N13 (GND), U2.R1 (GND), U2.R4 (GND), U2.R9 (GND), U2.R14 (GND), U2.R18 (GND), U2.T16 (GND), U2.U6 (GND), U2.U12 (GND), U2.V1 (GND), U2.V18 (GND); also elsewhere on the board
unnamed: L1.1, U1.26 (SW1)
unnamed: C16.1, R2.1, U1.3 (AVIN1), U1.6 (AVIN2), U1.9 (AVIN3)
unnamed: L2.1, U1.4 (SW2)
unnamed: L3.1, U1.7 (SW3)
unnamed: R11.1, R13.1, U1.14 (FB3)
unnamed: R8.2, U1.16 (PG2)
unnamed: R3.1, R4.1, U1.23 (FB1)
unnamed: R5.2, U1.20 (PG1)
unnamed: R7.1, R9.1, U1.17 (FB2)
unnamed: R10.2, U1.19 (EN2)
unnamed: R6.2, U1.21 (EN1)
unnamed: R12.2, U1.13 (PG3)
unnamed: R14.2, U1.15 (EN3)
unnamed: LED1.A, R1.1
USB_VBUS: JP1.3; also elsewhere on the board

Notes on the sheet:
4.5V - 5.5V, 2A
3.3V, 2A
1.5V, 2A
1.2V, 2A

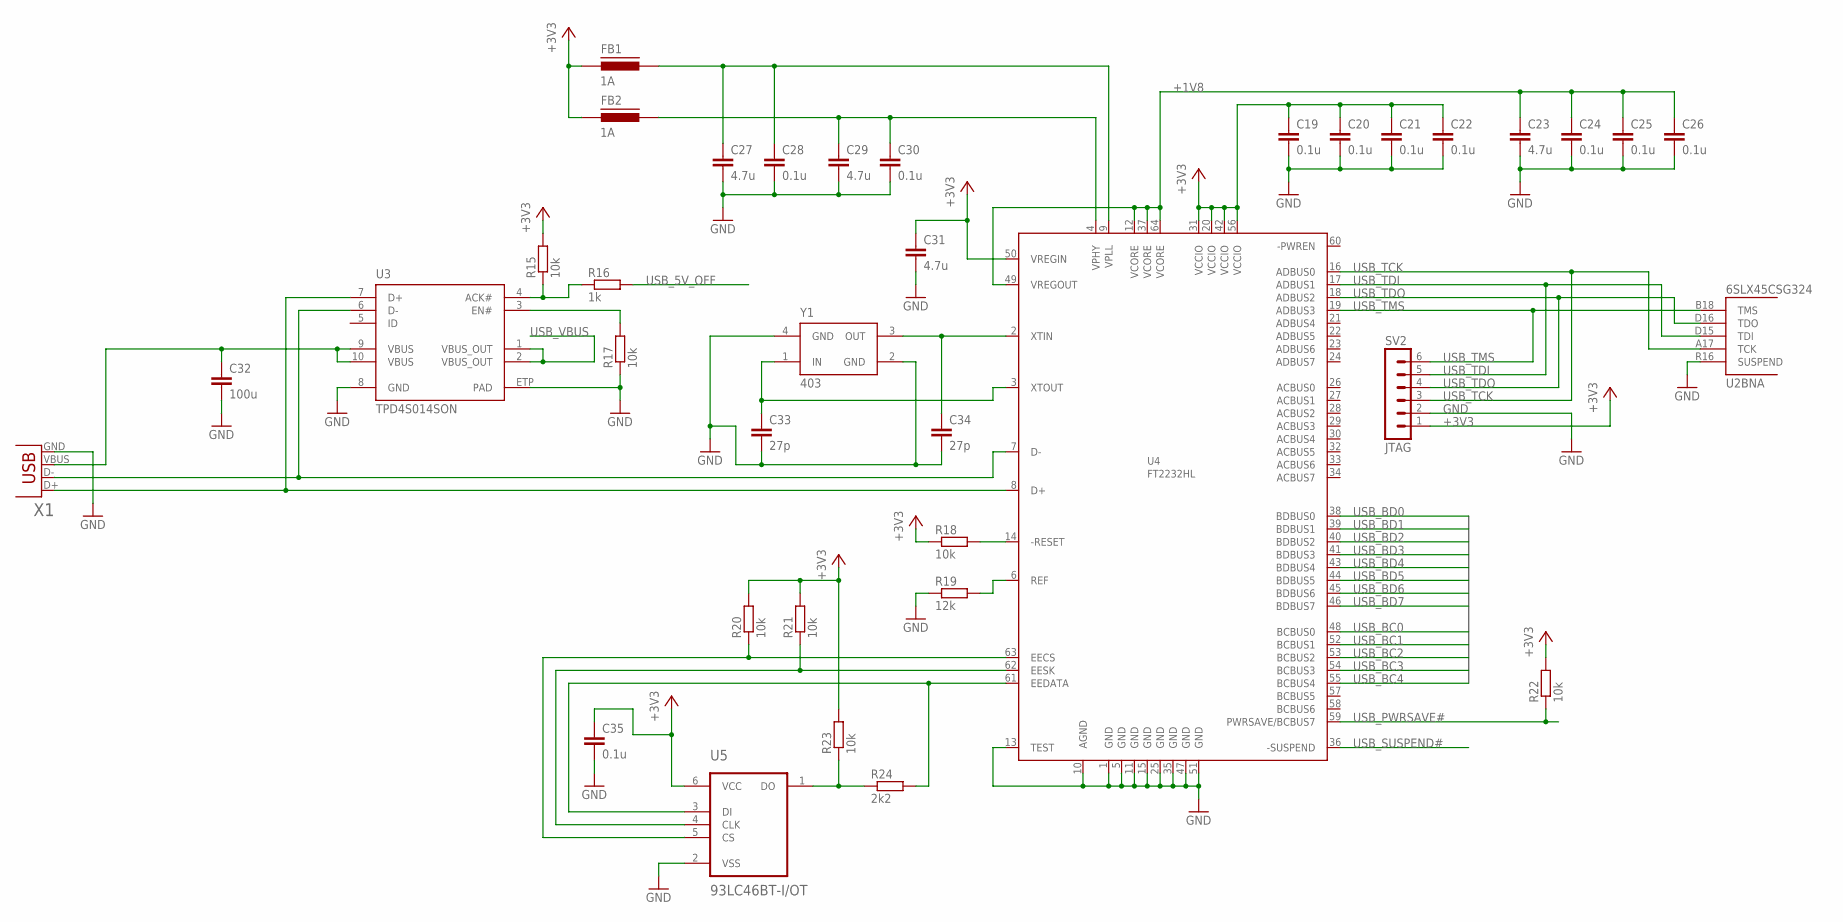
[picture p30: schematic hdmi.sch, sheet 2, USB]

Parts:
C19, C20, C21, C22, C24, C25, C26, C28, C30, C35: 0.1u; 0402
C23, C27, C29, C31: 4.7u; 0402
C32: 100u; 1206
C33, C34: 27p; 0402
FB1, FB2: 1A; 0402
R15, R17, R18, R20, R21, R22, R23: 10k; 0402
R16: 1k; 0402
R19: 12k; 0402
R24: 2k2; 0402
SV2: JTAG; MA06-1
U2: 6SLX45CSG324; CS324
U3: TPD4S014SON; SON10
U4: FT2232HL; LQFP64
U5: 93LC46BT-I/OT; SOT23-6
X1: USBUB-S; USB-UB-S
Y1: 403; 403-3.2X2.5

Connections:
+1V8: C23.1, C24.1, C25.1, C26.1, U4.12 (VCORE), U4.37 (VCORE), U4.49 (VREGOUT), U4.64 (VCORE)
+3V3: C19.1, C20.1, C21.1, C22.1, C31.1, C35.1, FB1.1, FB2.1, R15.2, R18.1, R20.2, R21.2, R22.2, R23.2, SV2.1, U4.20 (VCCIO), U4.31 (VCCIO), U4.42 (VCCIO), U4.50 (VREGIN), U4.56 (VCCIO), U5.6 (VCC); also elsewhere on the board
GND: C19.2, C20.2, C21.2, C22.2, C23.2, C24.2, C25.2, C26.2, C27.2, C28.2, C29.2, C30.2, C31.2, C32.2, C33.2, C34.2, C35.2, R17.1, R19.1, SV2.2, U2.R16 (SUSPEND), U3.8 (GND), U3.ETP (PAD), U4.1 (GND), U4.5 (GND), U4.10 (AGND), U4.11 (GND), U4.13 (TEST), U4.15 (GND), U4.25 (GND), U4.35 (GND), U4.47 (GND), U4.51 (GND), U5.2 (VSS), X1.GND, Y1.2 (GND), Y1.4 (GND); also elsewhere on the board
unnamed: C34.1, U4.2 (XTIN), Y1.3 (OUT)
unnamed: C33.1, U4.3 (XTOUT), Y1.1 (IN)
unnamed: R20.1, U4.63 (EECS), U5.5 (CS)
unnamed: U3.6 (D-), U4.7 (D-), X1.D-
unnamed: U3.7 (D+), U4.8 (D+), X1.D+
unnamed: R21.1, U4.62 (EESK), U5.4 (CLK)
unnamed: R24.2, U4.61 (EEDATA), U5.3 (DI)
unnamed: R19.2, U4.6 (REF)
unnamed: R23.1, R24.1, U5.1 (DO)
unnamed: R18.2, U4.14 (-RESET)
unnamed: C29.1, C30.1, FB2.2, U4.4 (VPHY)
unnamed: C27.1, C28.1, FB1.2, U4.9 (VPLL)
unnamed: C32.1, U3.9 (VBUS), U3.10 (VBUS), X1.VBUS
USB_5V_ACK#: R15.1, R16.1, U3.4 (ACK#)
USB_5V_DISABLE: R17.2, U3.3 (EN#)
USB_5V_OFF: R16.2; also elsewhere on the board
USB_BC0: U4.48 (BCBUS0); also elsewhere on the board
USB_BC1: U4.52 (BCBUS1); also elsewhere on the board
USB_BC2: U4.53 (BCBUS2); also elsewhere on the board
USB_BC3: U4.54 (BCBUS3); also elsewhere on the board
USB_BC4: U4.55 (BCBUS4); also elsewhere on the board
USB_BD0: U4.38 (BDBUS0); also elsewhere on the board
USB_BD1: U4.39 (BDBUS1); also elsewhere on the board
USB_BD2: U4.40 (BDBUS2); also elsewhere on the board
USB_BD3: U4.41 (BDBUS3); also elsewhere on the board
USB_BD4: U4.43 (BDBUS4); also elsewhere on the board
USB_BD5: U4.44 (BDBUS5); also elsewhere on the board
USB_BD6: U4.45 (BDBUS6); also elsewhere on the board
USB_BD7: U4.46 (BDBUS7); also elsewhere on the board
USB_PWRSAVE#: R22.1, U4.59 (PWRSAVE/BCBUS7)
USB_SUSPEND#: U4.36 (-SUSPEND); also elsewhere on the board
USB_TCK: SV2.3, U2.A17 (TCK), U4.16 (ADBUS0)
USB_TDI: SV2.5, U2.D15 (TDI), U4.17 (ADBUS1)
USB_TDO: SV2.4, U2.D16 (TDO), U4.18 (ADBUS2)
USB_TMS: SV2.6, U2.B18 (TMS), U4.19 (ADBUS3)
USB_VBUS: U3.1 (VBUS_OUT), U3.2 (VBUS_OUT); also elsewhere on the board

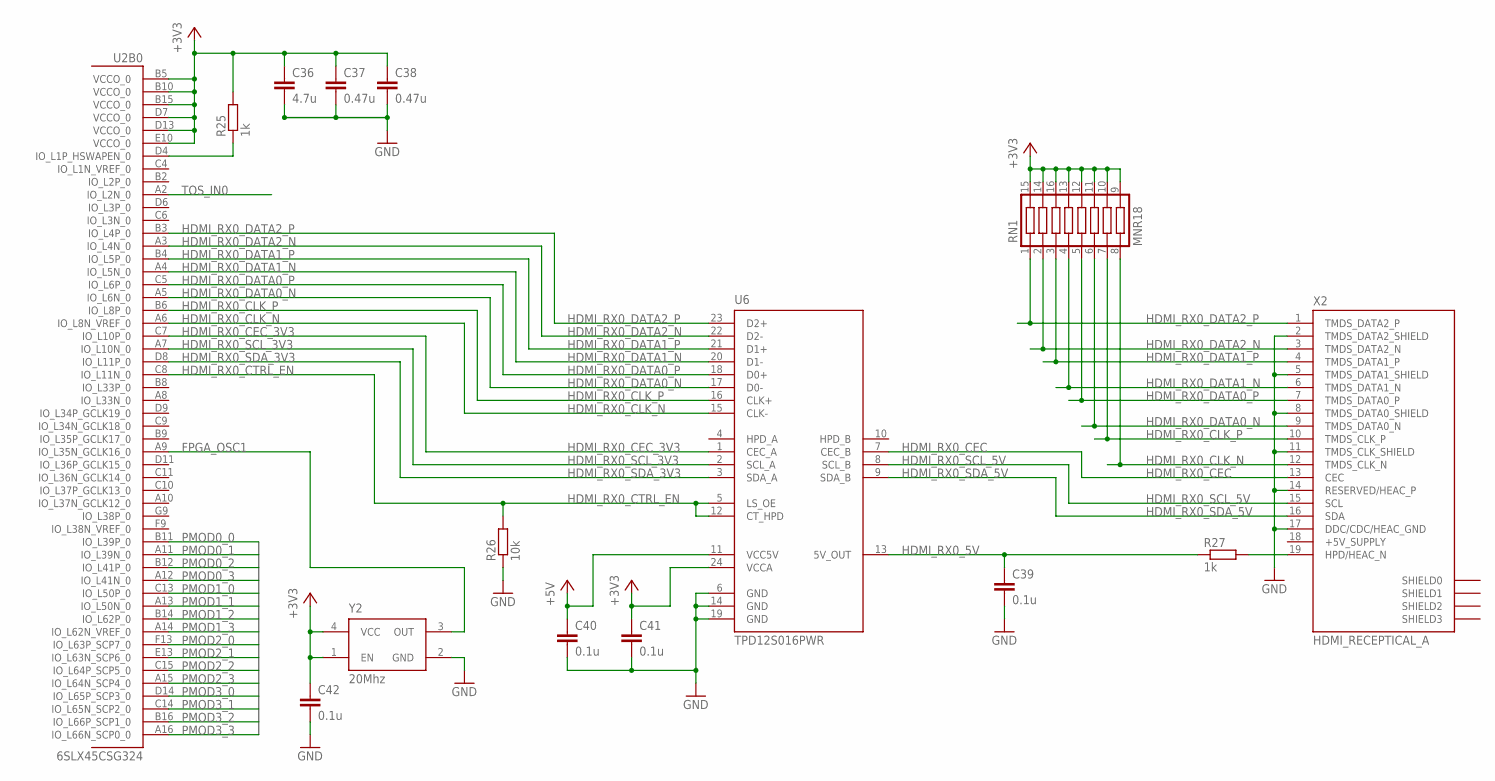
[picture p31: schematic hdmi.sch, sheet 3, B0, HDMI Rx0]

Parts:
C36: 4.7u; 0402
C37, C38: 0.47u; 0402
C39, C40, C41, C42: 0.1u; 0402
R25, R27: 1k; 0402
R26: 10k; 0402
RN1: MNR18
U2: 6SLX45CSG324; CS324
U6: TPD12S016PWR; PW_R-PDSO-G24
X2: HDMI_RECEPTICAL_A; HDMI_TYPE_A_RECEPTICAL
Y2: 20Mhz; 636

Connections:
+3V3: C36.1, C37.1, C38.1, C41.1, C42.1, R25.2, RN1.9, RN1.10, RN1.11, RN1.12, RN1.13, RN1.14 (15), RN1.15 (16), RN1.16 (C3), U2.B5 (VCCO_0), U2.B10 (VCCO_0), U2.B15 (VCCO_0), U2.D7 (VCCO_0), U2.D13 (VCCO_0), U2.E10 (VCCO_0), U6.24 (VCCA), Y2.1 (EN), Y2.4 (VCC); also elsewhere on the board
+5V: C40.1, U6.11 (VCC5V); also elsewhere on the board
+5V_SUPPLY: X2.18 (+5V_SUPPLY); also elsewhere on the board
FPGA_OSC1: U2.A9 (IO_L35N_GCLK16_0), Y2.3 (OUT)
GND: C36.2, C37.2, C38.2, C39.2, C40.2, C41.2, C42.2, R26.1, U6.6 (GND), U6.14 (GND), U6.19 (GND), X2.2 (TMDS_DATA2_SHIELD), X2.5 (TMDS_DATA1_SHIELD), X2.8 (TMDS_DATA0_SHIELD), X2.11 (TMDS_CLK_SHIELD), X2.14 (RESERVED/HEAC_P), X2.17 (DDC/CDC/HEAC_GND), Y2.2 (GND); also elsewhere on the board
HDMI_RX0_5V: C39.1, R27.1, U6.13 (5V_OUT)
HDMI_RX0_CEC: U6.7 (CEC_B), X2.13 (CEC)
HDMI_RX0_CEC_3V3: U2.C7 (IO_L10P_0), U6.1 (CEC_A)
HDMI_RX0_CLK_N: RN1.8, U2.A6 (IO_L8N_VREF_0), U6.15 (CLK-), X2.12 (TMDS_CLK_N)
HDMI_RX0_CLK_P: RN1.7, U2.B6 (IO_L8P_0), U6.16 (CLK+), X2.10 (TMDS_CLK_P)
HDMI_RX0_CTRL_EN: R26.2, U2.C8 (IO_L11N_0), U6.5 (LS_OE), U6.12 (CT_HPD)
HDMI_RX0_DATA0_N: RN1.6, U2.A5 (IO_L6N_0), U6.17 (D0-), X2.9 (TMDS_DATA0_N)
HDMI_RX0_DATA0_P: RN1.5, U2.C5 (IO_L6P_0), U6.18 (D0+), X2.7 (TMDS_DATA0_P)
HDMI_RX0_DATA1_N: RN1.4, U2.A4 (IO_L5N_0), U6.20 (D1-), X2.6 (TMDS_DATA1_N)
HDMI_RX0_DATA1_P: RN1.3, U2.B4 (IO_L5P_0), U6.21 (D1+), X2.4 (TMDS_DATA1_P)
HDMI_RX0_DATA2_N: RN1.2, U2.A3 (IO_L4N_0), U6.22 (D2-), X2.3 (TMDS_DATA2_N)
HDMI_RX0_DATA2_P: RN1.1, U2.B3 (IO_L4P_0), U6.23 (D2+), X2.1 (TMDS_DATA2_P)
HDMI_RX0_SCL_3V3: U2.A7 (IO_L10N_0), U6.2 (SCL_A)
HDMI_RX0_SCL_5V: U6.8 (SCL_B), X2.15 (SCL)
HDMI_RX0_SDA_3V3: U2.D8 (IO_L11P_0), U6.3 (SDA_A)
HDMI_RX0_SDA_5V: U6.9 (SDA_B), X2.16 (SDA)
unnamed: R25.1, U2.D4 (IO_L1P_HSWAPEN_0)
unnamed: R27.2, X2.19 (HPD/HEAC_N)
PMOD0_0: U2.B11 (IO_L39P_0); also elsewhere on the board
PMOD0_1: U2.A11 (IO_L39N_0); also elsewhere on the board
PMOD0_2: U2.B12 (IO_L41P_0); also elsewhere on the board
PMOD0_3: U2.A12 (IO_L41N_0); also elsewhere on the board
PMOD1_0: U2.C13 (IO_L50P_0); also elsewhere on the board
PMOD1_1: U2.A13 (IO_L50N_0); also elsewhere on the board
PMOD1_2: U2.B14 (IO_L62P_0); also elsewhere on the board
PMOD1_3: U2.A14 (IO_L62N_VREF_0); also elsewhere on the board
PMOD2_0: U2.F13 (IO_L63P_SCP7_0); also elsewhere on the board
PMOD2_1: U2.E13 (IO_L63N_SCP6_0); also elsewhere on the board
PMOD2_2: U2.C15 (IO_L64P_SCP5_0); also elsewhere on the board
PMOD2_3: U2.A15 (IO_L64N_SCP4_0); also elsewhere on the board
PMOD3_0: U2.D14 (IO_L65P_SCP3_0); also elsewhere on the board
PMOD3_1: U2.C14 (IO_L65N_SCP2_0); also elsewhere on the board
PMOD3_2: U2.B16 (IO_L66P_SCP1_0); also elsewhere on the board
PMOD3_3: U2.A16 (IO_L66N_SCP0_0); also elsewhere on the board
TOS_IN0: U2.A2 (IO_L2N_0); also elsewhere on the board

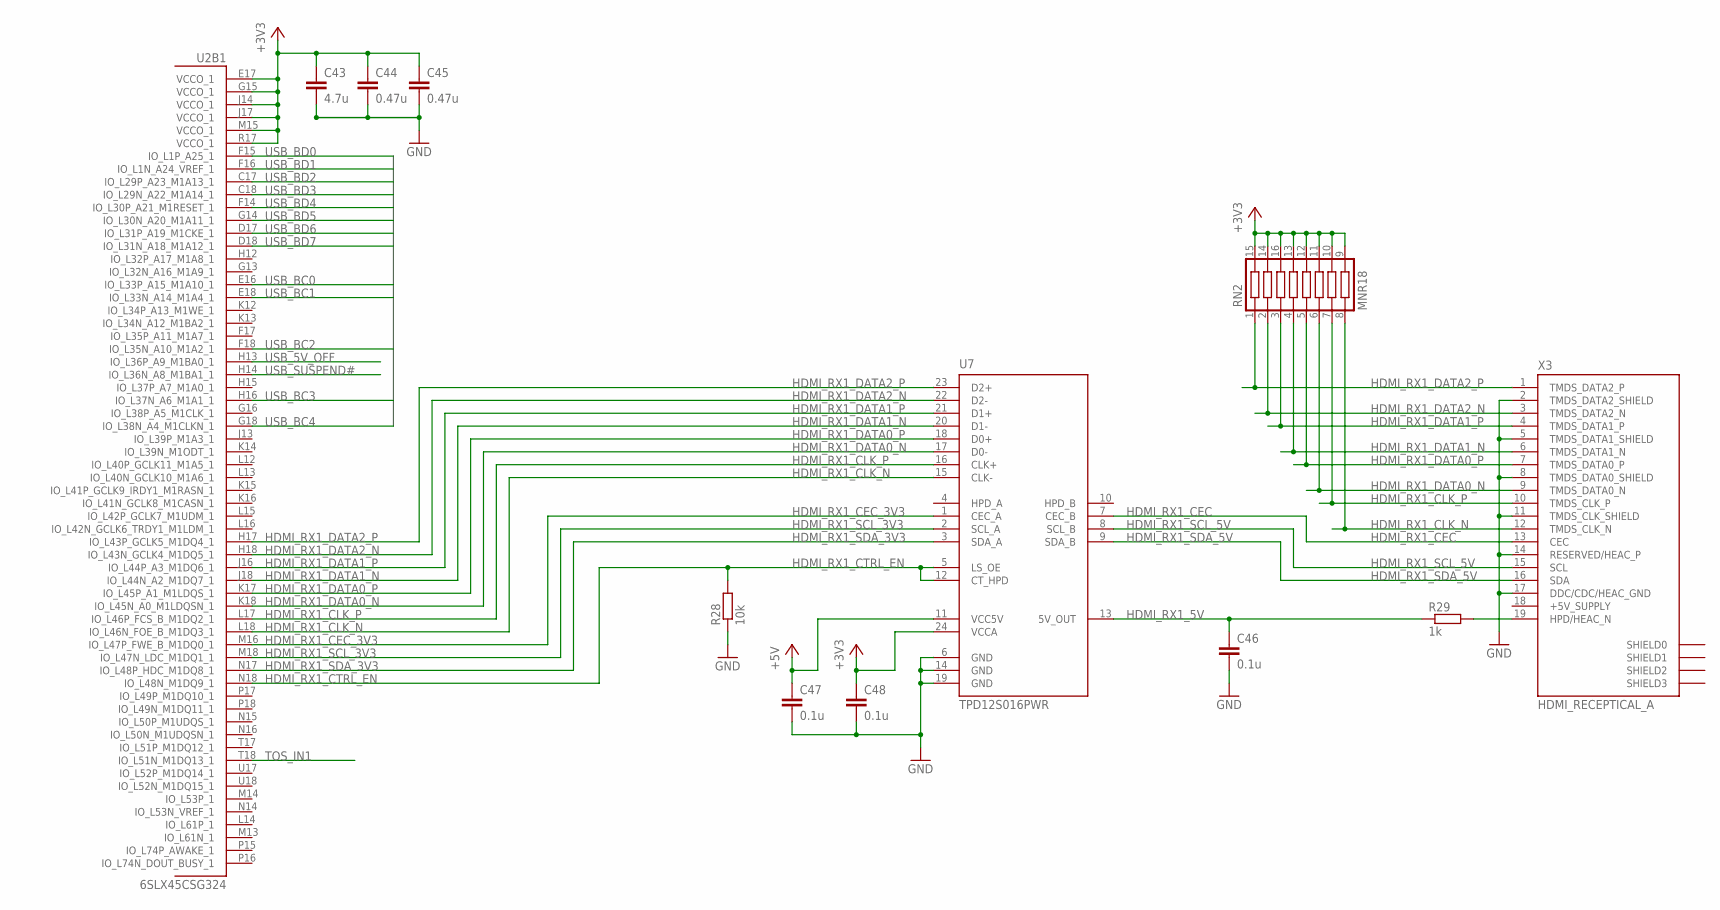
[picture p32: schematic hdmi.sch, sheet 4, B1, HDMI Rx1]

Parts:
C43: 4.7u; 0402
C44, C45: 0.47u; 0402
C46, C47, C48: 0.1u; 0402
R28: 10k; 0402
R29: 1k; 0402
RN2: MNR18
U2: 6SLX45CSG324; CS324
U7: TPD12S016PWR; PW_R-PDSO-G24
X3: HDMI_RECEPTICAL_A; HDMI_TYPE_A_RECEPTICAL

Connections:
+3V3: C43.1, C44.1, C45.1, C48.1, RN2.9, RN2.10, RN2.11, RN2.12, RN2.13, RN2.14 (15), RN2.15 (16), RN2.16 (C3), U2.E17 (VCCO_1), U2.G15 (VCCO_1), U2.J14 (VCCO_1), U2.J17 (VCCO_1), U2.M15 (VCCO_1), U2.R17 (VCCO_1), U7.24 (VCCA); also elsewhere on the board
+5V: C47.1, U7.11 (VCC5V); also elsewhere on the board
+5V_SUPPLY: X3.18 (+5V_SUPPLY); also elsewhere on the board
GND: C43.2, C44.2, C45.2, C46.2, C47.2, C48.2, R28.1, U7.6 (GND), U7.14 (GND), U7.19 (GND), X3.2 (TMDS_DATA2_SHIELD), X3.5 (TMDS_DATA1_SHIELD), X3.8 (TMDS_DATA0_SHIELD), X3.11 (TMDS_CLK_SHIELD), X3.14 (RESERVED/HEAC_P), X3.17 (DDC/CDC/HEAC_GND); also elsewhere on the board
HDMI_RX1_5V: C46.1, R29.1, U7.13 (5V_OUT)
HDMI_RX1_CEC: U7.7 (CEC_B), X3.13 (CEC)
HDMI_RX1_CEC_3V3: U2.M16 (IO_L47P_FWE_B_M1DQ0_1), U7.1 (CEC_A)
HDMI_RX1_CLK_N: RN2.8, U2.L18 (IO_L46N_FOE_B_M1DQ3_1), U7.15 (CLK-), X3.12 (TMDS_CLK_N)
HDMI_RX1_CLK_P: RN2.7, U2.L17 (IO_L46P_FCS_B_M1DQ2_1), U7.16 (CLK+), X3.10 (TMDS_CLK_P)
HDMI_RX1_CTRL_EN: R28.2, U2.N18 (IO_L48N_M1DQ9_1), U7.5 (LS_OE), U7.12 (CT_HPD)
HDMI_RX1_DATA0_N: RN2.6, U2.K18 (IO_L45N_A0_M1LDQSN_1), U7.17 (D0-), X3.9 (TMDS_DATA0_N)
HDMI_RX1_DATA0_P: RN2.5, U2.K17 (IO_L45P_A1_M1LDQS_1), U7.18 (D0+), X3.7 (TMDS_DATA0_P)
HDMI_RX1_DATA1_N: RN2.4, U2.J18 (IO_L44N_A2_M1DQ7_1), U7.20 (D1-), X3.6 (TMDS_DATA1_N)
HDMI_RX1_DATA1_P: RN2.3, U2.J16 (IO_L44P_A3_M1DQ6_1), U7.21 (D1+), X3.4 (TMDS_DATA1_P)
HDMI_RX1_DATA2_N: RN2.2, U2.H18 (IO_L43N_GCLK4_M1DQ5_1), U7.22 (D2-), X3.3 (TMDS_DATA2_N)
HDMI_RX1_DATA2_P: RN2.1, U2.H17 (IO_L43P_GCLK5_M1DQ4_1), U7.23 (D2+), X3.1 (TMDS_DATA2_P)
HDMI_RX1_SCL_3V3: U2.M18 (IO_L47N_LDC_M1DQ1_1), U7.2 (SCL_A)
HDMI_RX1_SCL_5V: U7.8 (SCL_B), X3.15 (SCL)
HDMI_RX1_SDA_3V3: U2.N17 (IO_L48P_HDC_M1DQ8_1), U7.3 (SDA_A)
HDMI_RX1_SDA_5V: U7.9 (SDA_B), X3.16 (SDA)
unnamed: R29.2, X3.19 (HPD/HEAC_N)
TOS_IN1: U2.T18 (IO_L51N_M1DQ13_1); also elsewhere on the board
USB_5V_OFF: U2.H13 (IO_L36P_A9_M1BA0_1); also elsewhere on the board
USB_BC0: U2.E16 (IO_L33P_A15_M1A10_1); also elsewhere on the board
USB_BC1: U2.E18 (IO_L33N_A14_M1A4_1); also elsewhere on the board
USB_BC2: U2.F18 (IO_L35N_A10_M1A2_1); also elsewhere on the board
USB_BC3: U2.H16 (IO_L37N_A6_M1A1_1); also elsewhere on the board
USB_BC4: U2.G18 (IO_L38N_A4_M1CLKN_1); also elsewhere on the board
USB_BD0: U2.F15 (IO_L1P_A25_1); also elsewhere on the board
USB_BD1: U2.F16 (IO_L1N_A24_VREF_1); also elsewhere on the board
USB_BD2: U2.C17 (IO_L29P_A23_M1A13_1); also elsewhere on the board
USB_BD3: U2.C18 (IO_L29N_A22_M1A14_1); also elsewhere on the board
USB_BD4: U2.F14 (IO_L30P_A21_M1RESET_1); also elsewhere on the board
USB_BD5: U2.G14 (IO_L30N_A20_M1A11_1); also elsewhere on the board
USB_BD6: U2.D17 (IO_L31P_A19_M1CKE_1); also elsewhere on the board
USB_BD7: U2.D18 (IO_L31N_A18_M1A12_1); also elsewhere on the board
USB_SUSPEND#: U2.H14 (IO_L36N_A8_M1BA1_1); also elsewhere on the board

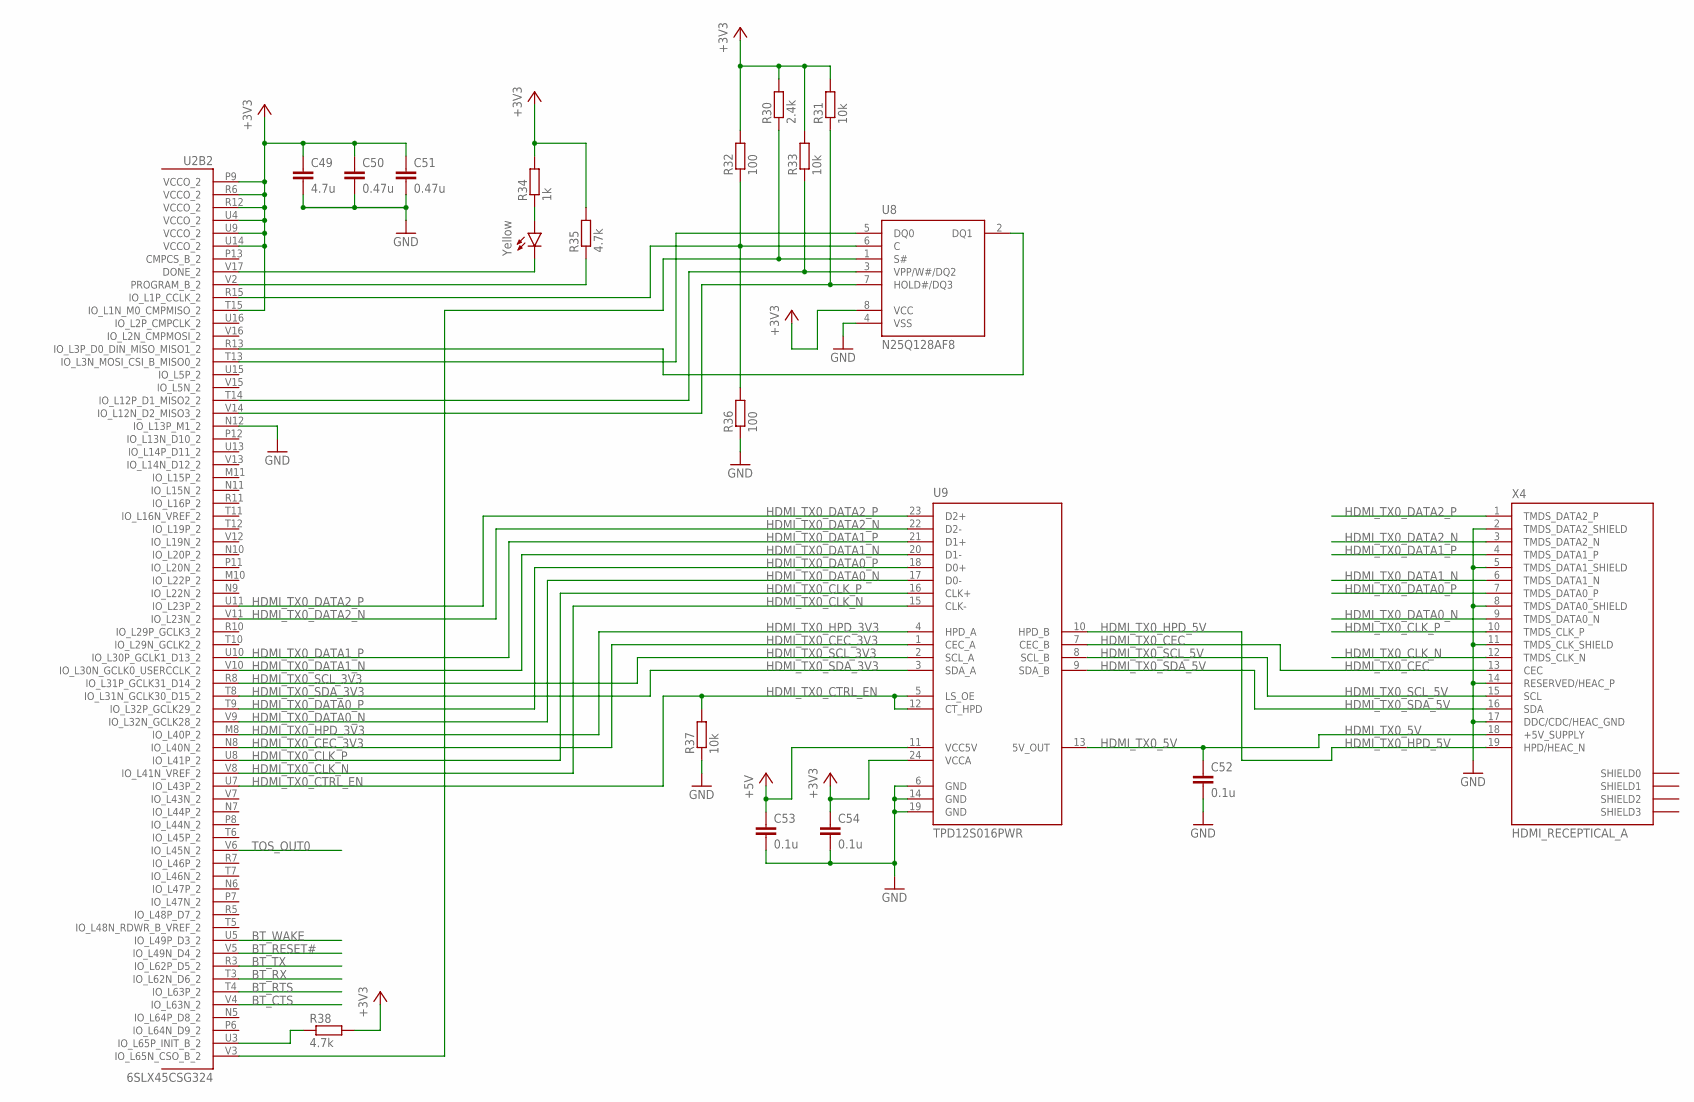
[picture p33: schematic hdmi.sch, sheet 5, B2, HDMI Tx0]

Parts:
C49: 4.7u; 0402
C50, C51: 0.47u; 0402
C52, C53, C54: 0.1u; 0402
LED2: Yellow; LED-0603
R30: 2.4k; 0402
R31, R33, R37: 10k; 0402
R32, R36: 100; 0402
R34: 1k; 0402
R35, R38: 4.7k; 0402
U2: 6SLX45CSG324; CS324
U8: N25Q128AF8; V-PDFN-8_8X6
U9: TPD12S016PWR; PW_R-PDSO-G24
X4: HDMI_RECEPTICAL_A; HDMI_TYPE_A_RECEPTICAL

Connections:
+3V3: C49.1, C50.1, C51.1, C54.1, R30.2, R31.2, R32.2, R33.2, R34.2, R35.2, R38.2, U2.P9 (VCCO_2), U2.R6 (VCCO_2), U2.R12 (VCCO_2), U2.T15 (IO_L1N_M0_CMPMISO_2), U2.U4 (VCCO_2), U2.U9 (VCCO_2), U2.U14 (VCCO_2), U8.8 (VCC), U9.24 (VCCA); also elsewhere on the board
+5V: C53.1, U9.11 (VCC5V); also elsewhere on the board
BT_CTS: U2.V4 (IO_L63N_2); also elsewhere on the board
BT_RESET#: U2.V5 (IO_L49N_D4_2); also elsewhere on the board
BT_RTS: U2.T4 (IO_L63P_2); also elsewhere on the board
BT_RX: U2.T3 (IO_L62N_D6_2); also elsewhere on the board
BT_TX: U2.R3 (IO_L62P_D5_2); also elsewhere on the board
BT_WAKE: U2.U5 (IO_L49P_D3_2); also elsewhere on the board
GND: C49.2, C50.2, C51.2, C52.2, C53.2, C54.2, R36.1, R37.1, U2.N12 (IO_L13P_M1_2), U8.4 (VSS), U9.6 (GND), U9.14 (GND), U9.19 (GND), X4.2 (TMDS_DATA2_SHIELD), X4.5 (TMDS_DATA1_SHIELD), X4.8 (TMDS_DATA0_SHIELD), X4.11 (TMDS_CLK_SHIELD), X4.14 (RESERVED/HEAC_P), X4.17 (DDC/CDC/HEAC_GND); also elsewhere on the board
HDMI_TX0_5V: C52.1, U9.13 (5V_OUT), X4.18 (+5V_SUPPLY)
HDMI_TX0_CEC: U9.7 (CEC_B), X4.13 (CEC)
HDMI_TX0_CEC_3V3: U2.N8 (IO_L40N_2), U9.1 (CEC_A)
HDMI_TX0_CLK_N: U2.V8 (IO_L41N_VREF_2), U9.15 (CLK-), X4.12 (TMDS_CLK_N)
HDMI_TX0_CLK_P: U2.U8 (IO_L41P_2), U9.16 (CLK+), X4.10 (TMDS_CLK_P)
HDMI_TX0_CTRL_EN: R37.2, U2.U7 (IO_L43P_2), U9.5 (LS_OE), U9.12 (CT_HPD)
HDMI_TX0_DATA0_N: U2.V9 (IO_L32N_GCLK28_2), U9.17 (D0-), X4.9 (TMDS_DATA0_N)
HDMI_TX0_DATA0_P: U2.T9 (IO_L32P_GCLK29_2), U9.18 (D0+), X4.7 (TMDS_DATA0_P)
HDMI_TX0_DATA1_N: U2.V10 (IO_L30N_GCLK0_USERCCLK_2), U9.20 (D1-), X4.6 (TMDS_DATA1_N)
HDMI_TX0_DATA1_P: U2.U10 (IO_L30P_GCLK1_D13_2), U9.21 (D1+), X4.4 (TMDS_DATA1_P)
HDMI_TX0_DATA2_N: U2.V11 (IO_L23N_2), U9.22 (D2-), X4.3 (TMDS_DATA2_N)
HDMI_TX0_DATA2_P: U2.U11 (IO_L23P_2), U9.23 (D2+), X4.1 (TMDS_DATA2_P)
HDMI_TX0_HPD_3V3: U2.M8 (IO_L40P_2), U9.4 (HPD_A)
HDMI_TX0_HPD_5V: U9.10 (HPD_B), X4.19 (HPD/HEAC_N)
HDMI_TX0_SCL_3V3: U2.R8 (IO_L31P_GCLK31_D14_2), U9.2 (SCL_A)
HDMI_TX0_SCL_5V: U9.8 (SCL_B), X4.15 (SCL)
HDMI_TX0_SDA_3V3: U2.T8 (IO_L31N_GCLK30_D15_2), U9.3 (SDA_A)
HDMI_TX0_SDA_5V: U9.9 (SDA_B), X4.16 (SDA)
unnamed: LED2.C, U2.V17 (DONE_2)
unnamed: R35.1, U2.V2 (PROGRAM_B_2)
unnamed: LED2.A, R34.1
unnamed: R38.1, U2.U3 (IO_L65P_INIT_B_2)
unnamed: U2.T13 (IO_L3N_MOSI_CSI_B_MISO0_2), U8.5 (DQ0)
unnamed: R30.1, U2.V3 (IO_L65N_CSO_B_2), U8.1 (S#)
unnamed: R32.1, R36.2, U2.R15 (IO_L1P_CCLK_2), U8.6 (C)
unnamed: U2.R13 (IO_L3P_D0_DIN_MISO_MISO1_2), U8.2 (DQ1)
unnamed: R33.1, U2.T14 (IO_L12P_D1_MISO2_2), U8.3 (VPP/W#/DQ2)
unnamed: R31.1, U2.V14 (IO_L12N_D2_MISO3_2), U8.7 (HOLD#/DQ3)
TOS_OUT0: U2.V6 (IO_L45N_2); also elsewhere on the board
