panda73111/HDMI-eagle/hdmi.brd

## EAGLE design hdmi.brd (continued)

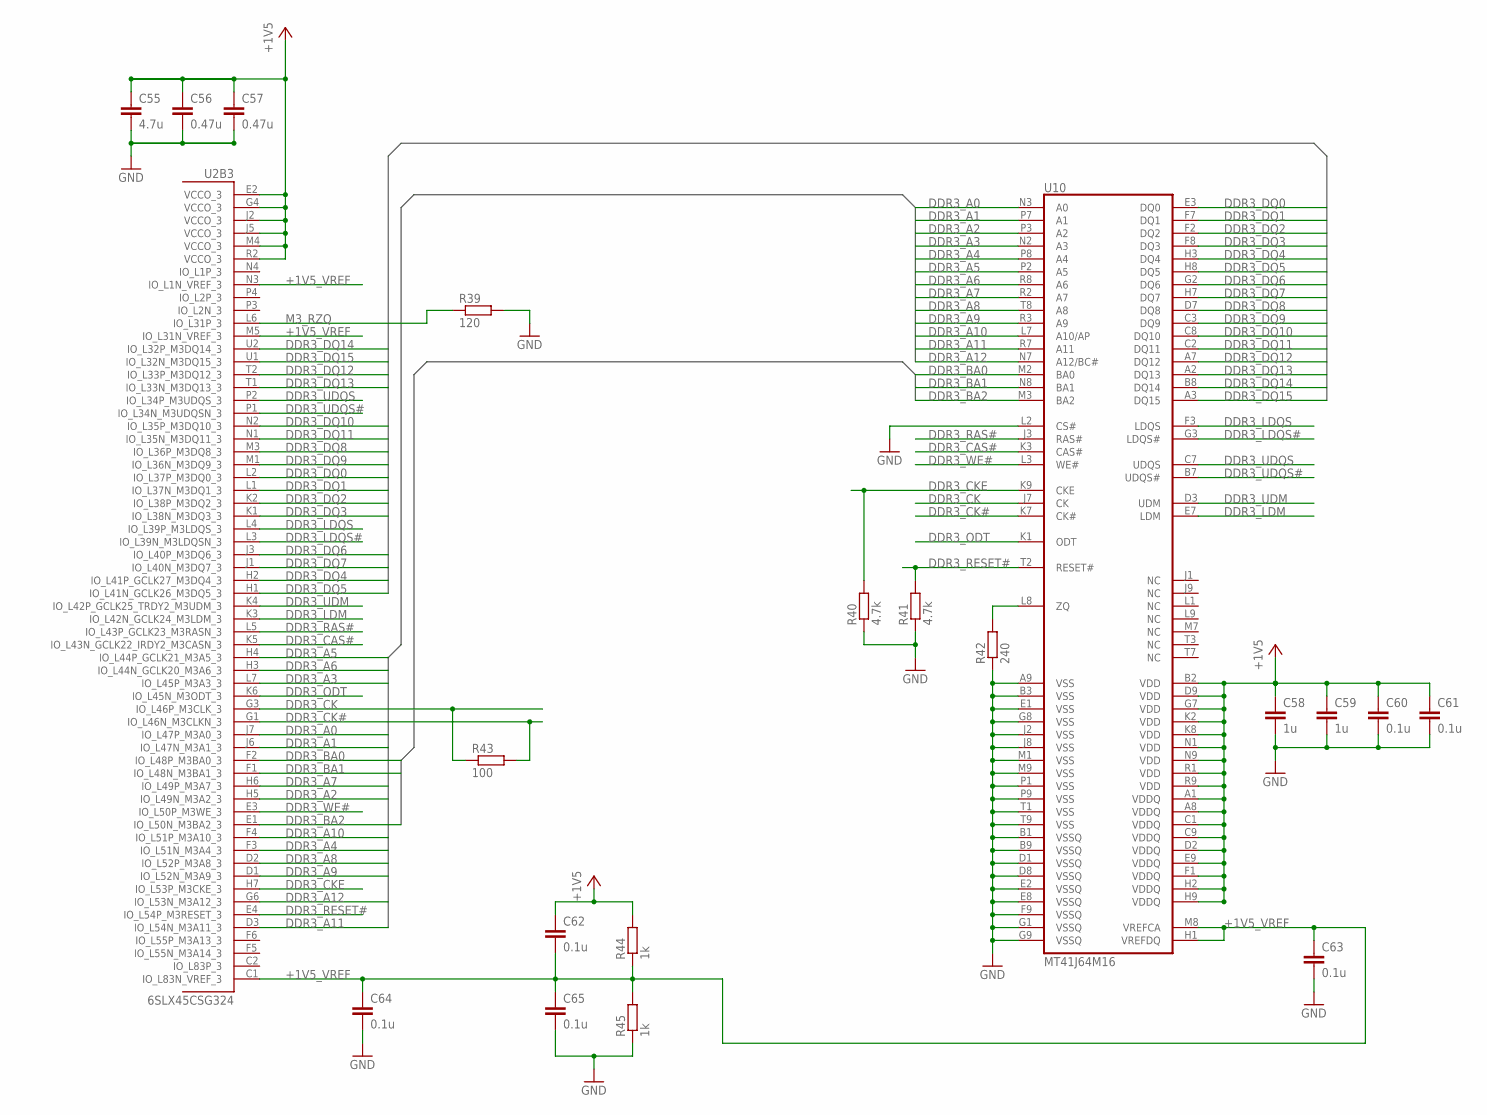
[picture p34: schematic hdmi.sch, sheet 6, B3, DDR3]

Parts:
C55: 4.7u; 0402
C56, C57: 0.47u; 0402
C58, C59: 1u; 0402
C60, C61, C62, C63, C64, C65: 0.1u; 0402
R39: 120; 0402
R40, R41: 4.7k; 0402
R42: 240; 0402
R43: 100; 0402
R44, R45: 1k; 0402
U2: 6SLX45CSG324; CS324
U10: MT41J64M16; FBGA96-JT

Connections:
+1V5: C55.1, C56.1, C57.1, C58.1, C59.1, C60.1, C61.1, C62.1, R44.2, U2.E2 (VCCO_3), U2.G4 (VCCO_3), U2.J2 (VCCO_3), U2.J5 (VCCO_3), U2.M4 (VCCO_3), U2.R2 (VCCO_3), U10.A1 (VDDQ), U10.A8 (VDDQ), U10.B2 (VDD), U10.C1 (VDDQ), U10.C9 (VDDQ), U10.D2 (VDDQ), U10.D9 (VDD), U10.E9 (VDDQ), U10.F1 (VDDQ), U10.G7 (VDD), U10.H2 (VDDQ), U10.H9 (VDDQ), U10.K2 (VDD), U10.K8 (VDD), U10.N1 (VDD), U10.N9 (VDD), U10.R1 (VDD), U10.R9 (VDD); also elsewhere on the board
+1V5_VREF: C62.2, C63.1, C64.1, C65.1, R44.1, R45.2, U2.C1 (IO_L83N_VREF_3), U2.M5 (IO_L31N_VREF_3), U2.N3 (IO_L1N_VREF_3), U10.H1 (VREFDQ), U10.M8 (VREFCA)
DDR3_A0: U2.J7 (IO_L47P_M3A0_3), U10.N3 (A0)
DDR3_A1: U2.J6 (IO_L47N_M3A1_3), U10.P7 (A1)
DDR3_A2: U2.H5 (IO_L49N_M3A2_3), U10.P3 (A2)
DDR3_A3: U2.L7 (IO_L45P_M3A3_3), U10.N2 (A3)
DDR3_A4: U2.F3 (IO_L51N_M3A4_3), U10.P8 (A4)
DDR3_A5: U2.H4 (IO_L44P_GCLK21_M3A5_3), U10.P2 (A5)
DDR3_A6: U2.H3 (IO_L44N_GCLK20_M3A6_3), U10.R8 (A6)
DDR3_A7: U2.H6 (IO_L49P_M3A7_3), U10.R2 (A7)
DDR3_A8: U2.D2 (IO_L52P_M3A8_3), U10.T8 (A8)
DDR3_A9: U2.D1 (IO_L52N_M3A9_3), U10.R3 (A9)
DDR3_A10: U2.F4 (IO_L51P_M3A10_3), U10.L7 (A10/AP)
DDR3_A11: U2.D3 (IO_L54N_M3A11_3), U10.R7 (A11)
DDR3_A12: U2.G6 (IO_L53N_M3A12_3), U10.N7 (A12/BC#)
DDR3_BA0: U2.F2 (IO_L48P_M3BA0_3), U10.M2 (BA0)
DDR3_BA1: U2.F1 (IO_L48N_M3BA1_3), U10.N8 (BA1)
DDR3_BA2: U2.E1 (IO_L50N_M3BA2_3), U10.M3 (BA2)
DDR3_CAS#: U2.K5 (IO_L43N_GCLK22_IRDY2_M3CASN_3), U10.K3 (CAS#)
DDR3_CK: R43.1, U2.G3 (IO_L46P_M3CLK_3), U10.J7 (CK)
DDR3_CK#: R43.2, U2.G1 (IO_L46N_M3CLKN_3), U10.K7 (CK#)
DDR3_CKE: R40.2, U2.H7 (IO_L53P_M3CKE_3), U10.K9 (CKE)
DDR3_DQ0: U2.L2 (IO_L37P_M3DQ0_3), U10.E3 (DQ0)
DDR3_DQ1: U2.L1 (IO_L37N_M3DQ1_3), U10.F7 (DQ1)
DDR3_DQ2: U2.K2 (IO_L38P_M3DQ2_3), U10.F2 (DQ2)
DDR3_DQ3: U2.K1 (IO_L38N_M3DQ3_3), U10.F8 (DQ3)
DDR3_DQ4: U2.H2 (IO_L41P_GCLK27_M3DQ4_3), U10.H3 (DQ4)
DDR3_DQ5: U2.H1 (IO_L41N_GCLK26_M3DQ5_3), U10.H8 (DQ5)
DDR3_DQ6: U2.J3 (IO_L40P_M3DQ6_3), U10.G2 (DQ6)
DDR3_DQ7: U2.J1 (IO_L40N_M3DQ7_3), U10.H7 (DQ7)
DDR3_DQ8: U2.M3 (IO_L36P_M3DQ8_3), U10.D7 (DQ8)
DDR3_DQ9: U2.M1 (IO_L36N_M3DQ9_3), U10.C3 (DQ9)
DDR3_DQ10: U2.N2 (IO_L35P_M3DQ10_3), U10.C8 (DQ10)
DDR3_DQ11: U2.N1 (IO_L35N_M3DQ11_3), U10.C2 (DQ11)
DDR3_DQ12: U2.T2 (IO_L33P_M3DQ12_3), U10.A7 (DQ12)
DDR3_DQ13: U2.T1 (IO_L33N_M3DQ13_3), U10.A2 (DQ13)
DDR3_DQ14: U2.U2 (IO_L32P_M3DQ14_3), U10.B8 (DQ14)
DDR3_DQ15: U2.U1 (IO_L32N_M3DQ15_3), U10.A3 (DQ15)
DDR3_LDM: U2.K3 (IO_L42N_GCLK24_M3LDM_3), U10.E7 (LDM)
DDR3_LDQS: U2.L4 (IO_L39P_M3LDQS_3), U10.F3 (LDQS)
DDR3_LDQS#: U2.L3 (IO_L39N_M3LDQSN_3), U10.G3 (LDQS#)
DDR3_ODT: U2.K6 (IO_L45N_M3ODT_3), U10.K1 (ODT)
DDR3_RAS#: U2.L5 (IO_L43P_GCLK23_M3RASN_3), U10.J3 (RAS#)
DDR3_RESET#: R41.2, U2.E4 (IO_L54P_M3RESET_3), U10.T2 (RESET#)
DDR3_UDM: U2.K4 (IO_L42P_GCLK25_TRDY2_M3UDM_3), U10.D3 (UDM)
DDR3_UDQS: U2.P2 (IO_L34P_M3UDQS_3), U10.C7 (UDQS)
DDR3_UDQS#: U2.P1 (IO_L34N_M3UDQSN_3), U10.B7 (UDQS#)
DDR3_WE#: U2.E3 (IO_L50P_M3WE_3), U10.L3 (WE#)
GND: C55.2, C56.2, C57.2, C58.2, C59.2, C60.2, C61.2, C63.2, C64.2, C65.2, R39.2, R40.1, R41.1, R42.1, R45.1, U10.A9 (VSS), U10.B1 (VSSQ), U10.B3 (VSS), U10.B9 (VSSQ), U10.D1 (VSSQ), U10.D8 (VSSQ), U10.E1 (VSS), U10.E2 (VSSQ), U10.E8 (VSSQ), U10.F9 (VSSQ), U10.G1 (VSSQ), U10.G8 (VSS), U10.G9 (VSSQ), U10.J2 (VSS), U10.J8 (VSS), U10.L2 (CS#), U10.M1 (VSS), U10.M9 (VSS), U10.P1 (VSS), U10.P9 (VSS), U10.T1 (VSS), U10.T9 (VSS); also elsewhere on the board
M3_RZQ: R39.1, U2.L6 (IO_L31P_3)
unnamed: R42.2, U10.L8 (ZQ)

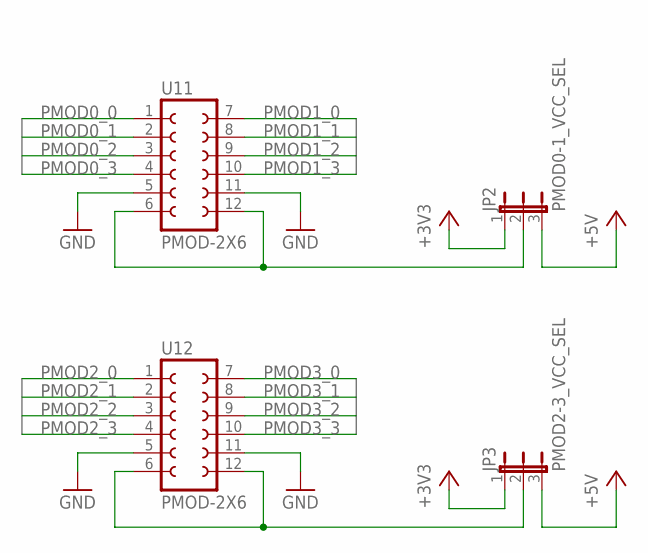
[picture p35: schematic hdmi.sch, sheet 7, PMOD]

Parts:
JP2: PMOD0-1_VCC_SEL; JP2
JP3: PMOD2-3_VCC_SEL; JP2
U11, U12: PMOD-2X6

Connections:
+3V3: JP2.1, JP3.1; also elsewhere on the board
+5V: JP2.3, JP3.3; also elsewhere on the board
GND: U11.5, U11.11, U12.5, U12.11; also elsewhere on the board
unnamed: JP3.2, U12.6, U12.12
unnamed: JP2.2, U11.6, U11.12
PMOD0_0: U11.1; also elsewhere on the board
PMOD0_1: U11.2; also elsewhere on the board
PMOD0_2: U11.3; also elsewhere on the board
PMOD0_3: U11.4; also elsewhere on the board
PMOD1_0: U11.7; also elsewhere on the board
PMOD1_1: U11.8; also elsewhere on the board
PMOD1_2: U11.9; also elsewhere on the board
PMOD1_3: U11.10; also elsewhere on the board
PMOD2_0: U12.1; also elsewhere on the board
PMOD2_1: U12.2; also elsewhere on the board
PMOD2_2: U12.3; also elsewhere on the board
PMOD2_3: U12.4; also elsewhere on the board
PMOD3_0: U12.7; also elsewhere on the board
PMOD3_1: U12.8; also elsewhere on the board
PMOD3_2: U12.9; also elsewhere on the board
PMOD3_3: U12.10; also elsewhere on the board

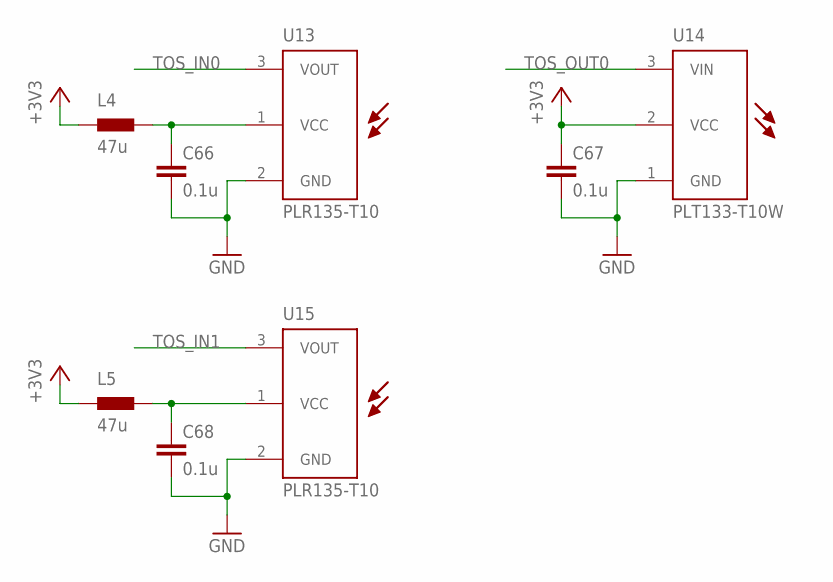
[picture p36: schematic hdmi.sch, sheet 8, Audio]

Parts:
C66, C67, C68: 0.1u; 0402
L4, L5: 47u; 0603
U13, U15: PLR135-T10; PLR135-T10_PLT133-T10W
U14: PLT133-T10W; PLR135-T10_PLT133-T10W

Connections:
+3V3: C67.1, L4.1, L5.1, U14.2 (VCC); also elsewhere on the board
GND: C66.2, C67.2, C68.2, U13.2 (GND), U14.1 (GND), U15.2 (GND); also elsewhere on the board
unnamed: C68.1, L5.2, U15.1 (VCC)
unnamed: C66.1, L4.2, U13.1 (VCC)
TOS_IN0: U13.3 (VOUT); also elsewhere on the board
TOS_IN1: U15.3 (VOUT); also elsewhere on the board
TOS_OUT0: U14.3 (VIN); also elsewhere on the board

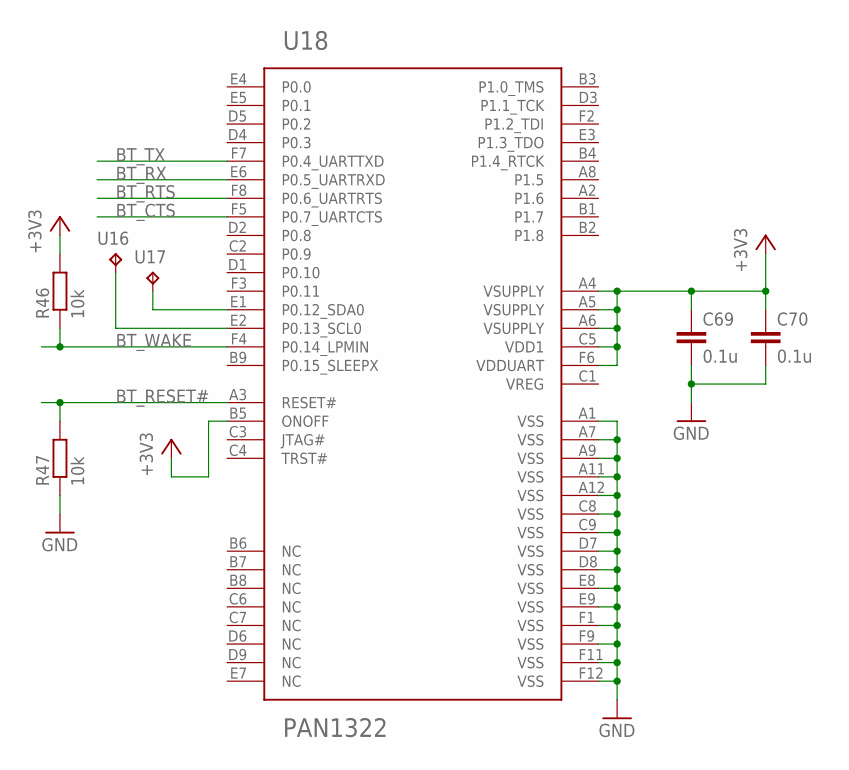
[picture p37: schematic hdmi.sch, sheet 9, Bluetooth]

Parts:
C69, C70: 0.1u; 0402
R46, R47: 10k; 0402
U16, U17: TP10SQ
U18: PAN1322

Connections:
+3V3: C69.1, C70.1, R46.2, U18.A4 (VSUPPLY), U18.A5 (VSUPPLY), U18.A6 (VSUPPLY), U18.B5 (ONOFF), U18.C5 (VDD1), U18.F6 (VDDUART); also elsewhere on the board
BT_CTS: U18.F5 (P0.7_UARTCTS); also elsewhere on the board
BT_RESET#: R47.2, U18.A3 (RESET#); also elsewhere on the board
BT_RTS: U18.F8 (P0.6_UARTRTS); also elsewhere on the board
BT_RX: U18.E6 (P0.5_UARTRXD); also elsewhere on the board
BT_TX: U18.F7 (P0.4_UARTTXD); also elsewhere on the board
BT_WAKE: R46.1, U18.F4 (P0.14_LPMIN); also elsewhere on the board
GND: C69.2, C70.2, R47.1, U18.A1 (VSS), U18.A7 (VSS), U18.A9 (VSS), U18.A11 (VSS), U18.A12 (VSS), U18.C8 (VSS), U18.C9 (VSS), U18.D7 (VSS), U18.D8 (VSS), U18.E8 (VSS), U18.E9 (VSS), U18.F1 (VSS), U18.F9 (VSS), U18.F11 (VSS), U18.F12 (VSS); also elsewhere on the board
unnamed: U17.TP, U18.E1 (P0.12_SDA0)
unnamed: U16.TP, U18.E2 (P0.13_SCL0)

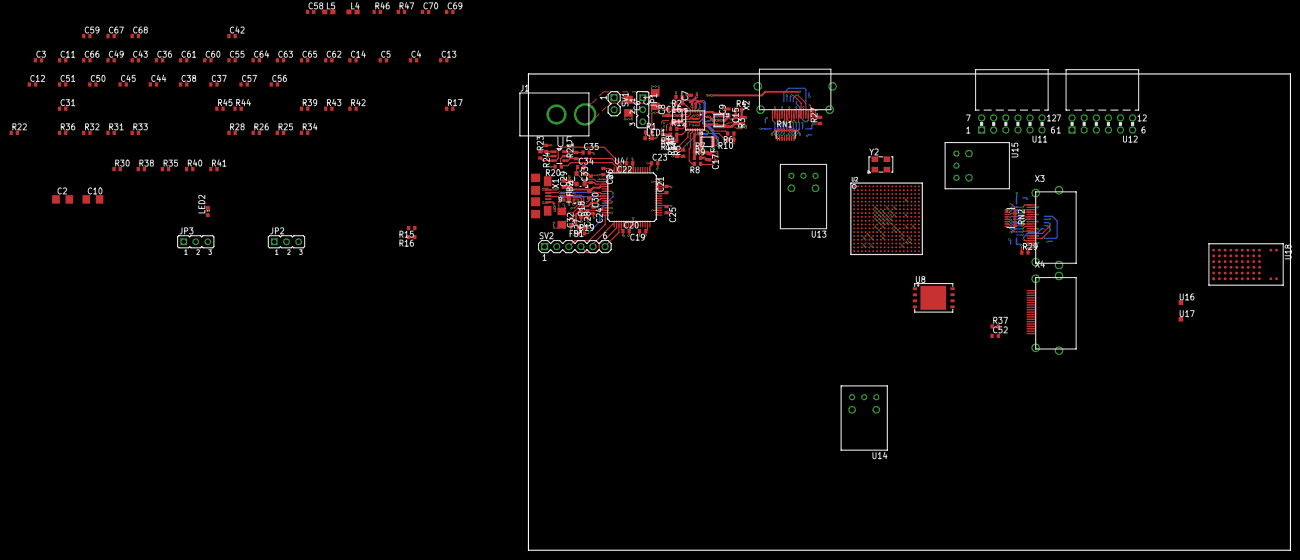
[picture p38: board hdmi.brd from above]

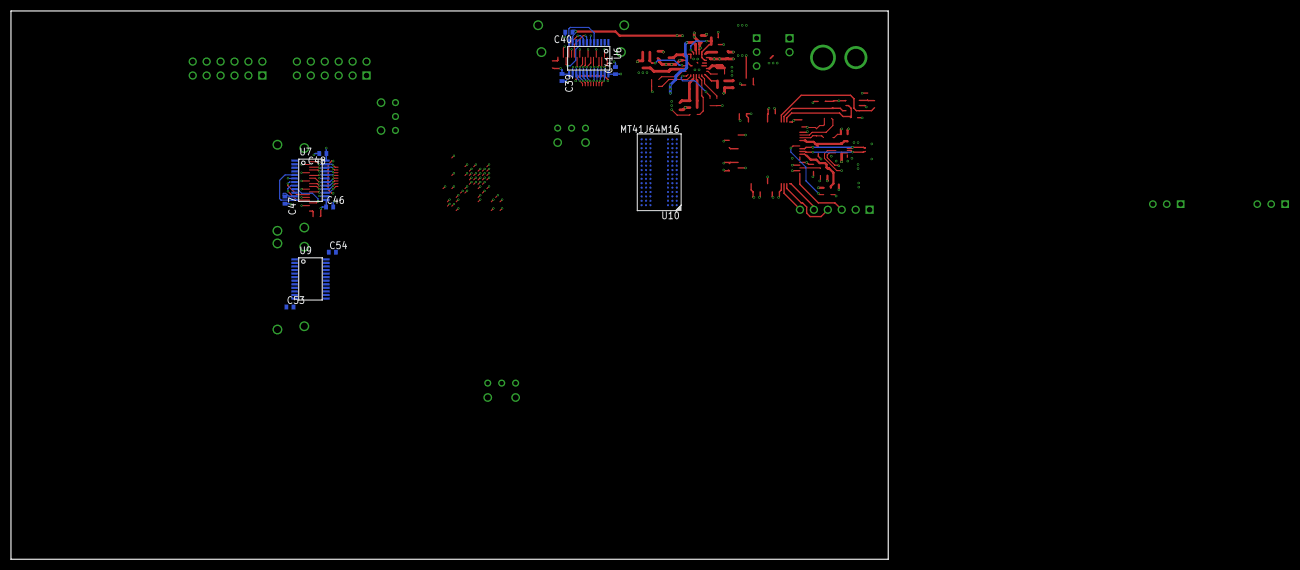
[picture p39: board hdmi.brd from below]

Board: 4 copper layers, 160.0 x 100.0 mm, 158 parts (12 on the bottom side), 202 nets.
