panda73111/HDMI-eagle/(commit log)

2014-03-05 +prj-hdmi.lbr, +5V protection
    [hdmi.brd, hdmi.sch]
2014-03-05 began mergin and cleaning up libraries
    [hdmi.brd, hdmi.sch]
2014-03-06 +5V supply zener diode and minor misc. changes
    [hdmi.brd, hdmi.sch]
2014-03-07 +N-MOSFET at 5V supply, HDMI connector pin swap, minor wiring changes
    [hdmi.brd, hdmi.sch]
2014-03-10 switched from hot swap controller to buck regulator, +PMOD
    [hdmi.brd, hdmi.sch]
2014-03-10 minor schematic placement changes
    [hdmi.brd, hdmi.sch]
2014-04-01 +Toslink connections
    [hdmi.brd, hdmi.sch]
2014-04-15 +Schematic notes
    [hdmi.brd, hdmi.sch]
2014-05-08 Removed regulator for external power, schematics look good I think
    [hdmi.brd, hdmi.sch]
2014-05-10 Slight schematic part relocations
    [hdmi.sch]
2014-05-11 +Bluetooth module
    [hdmi.brd, hdmi.sch]
2014-05-12 Began moving components in the board layout
    [hdmi.brd, hdmi.sch]
2014-05-12 +First layout of power management
    [hdmi.brd, hdmi.sch]
2014-05-12 Moved bypass capacitors at the power management to the top layer
    [hdmi.brd]
2014-05-13 Rerouted USB, added more bypass capacitors at the FT2232H
    [hdmi.brd, hdmi.sch]
2014-05-13 More USB related routing
    [hdmi.brd, hdmi.sch]
2014-05-14 Changed FT2232H from package QFN to LQFP; Finished first routing of power management and USB
    [hdmi.brd, hdmi.sch]
2014-05-16 Moved chips to their general direction
    [DRILEGEND.CFG, hdmi.brd, hdmi.sch]
2014-05-17 Switched HDMI companion chip package, finished routing of the first HDMI group
    [hdmi.brd, hdmi.sch]
2014-05-18 Switched all parts to the version of prj-hdmi.lbr; Corrected the "+5V" ping naming conflict; Exported BOM.xlsx
    [BOM.xlsx, DRILEGEND.CFG, hdmi.brd, hdmi.sch]
2014-05-19 Customized some of the library parts
    [hdmi.brd, hdmi.sch]
2014-05-22 Device management
    [hdmi.brd]
2014-05-27 Changed FT2232H crystal
    [hdmi.brd, hdmi.sch]
2014-05-29 Routed HDMI_RX1
    [hdmi.brd]
2014-05-30 Corrected some library/schemantic inconsistencies due to device renaming; Renamed and numbered all devices in order of placement using the library prefix
    [hdmi.brd, hdmi.sch]
2014-06-01 Changed project name and file names to "pandaLight"; Routed connections FPGA to oscillator and HDMI_RX0
    [pandaLight.brd, pandaLight.sch]
2014-06-03 Began adding BOM-ex parts
    [pandaLight.brd, pandaLight.sch]
2014-06-04 Switched to an available DDR3 SDRAM chip; Finished first BOM-ex; Matched the length of the HDMI RX0 traces
    [BOM.xlsx, pandaLight.brd, pandaLight.sch, pandaLight_DigiKeyOrder.csv]
2014-06-04 Switched the buck regulator to an available one; Corrected wrong packages and BOM-ex
    [pandaLight.brd, pandaLight.sch, pandaLight_DigiKeyOrder.csv]
2014-06-04 Routed the new buck regulator
    [pandaLight.brd, pandaLight.sch]
2014-06-10 Corrected the FPGA placement and routing the its ball pitch
    [pandaLight.brd, pandaLight.sch]
2014-06-10 Temporarily unconnected the PMOD and USB to FPGA wires; Moved power management and USB a little closer together; Began routing HDMI_RX1
    [pandaLight.brd, pandaLight.sch]
2014-06-11 Began length matching the HDMI_RX1 traces
    [pandaLight.brd, pandaLight.sch]
2014-06-13 Finished first routing of HDMI_RX1; Corrected some traces and placements
    [pandaLight.brd, pandaLight.sch]
2014-06-13 Straightened some via stubs
    [pandaLight.brd]
2014-06-13 Moved the FPGA to the center of the PCB, which is now 10mm x 5mm in size
    [pandaLight.brd]
2014-06-13 Actually resized the board; Tweaked some FT223H related traces
    [pandaLight.brd, pandaLight.sch]
2014-06-14 Set polygon sizes from 0 to 5mil (for later GERBER generation)
    [DRILEGEND.CFG, pandaLight.brd]
2014-06-14 Placed some bypass capacitors
    [pandaLight.brd]
2014-06-14 Routed blutooth module
    [pandaLight.brd, pandaLight.sch]
2014-06-14 Corrected the blutooth module's footprint being slighty misaligned
    [pandaLight.brd, pandaLight.sch]
2014-06-14 First routing of the serial flash; Placed some more bypass capacitors
    [pandaLight.brd, pandaLight.sch]
2014-06-15 Routed HDMI_TX0; Placed the PMODs to the board's bottom left edge
    [pandaLight.brd, pandaLight.sch]
2014-06-15 Switched the 1*8 resistor networks with 2*4 ones; Moved the HDMI_RX0 nets to the top layer
    [pandaLight.brd, pandaLight.sch]
2014-06-15 Finished moving the HDMI_RX0 traces to the top layer; Began doing the same with the HDMI_RX1 traces
    [pandaLight.brd, pandaLight.sch]
2014-06-16 Finished putting the HDMI_RX1 traces on the top layer
    [pandaLight.brd]
2014-06-16 Forgot some vias at HDMI_RX1
    [pandaLight.brd]
2014-06-16 Tried the differential routing and the meander
    [pandaLight.brd, pandaLight.sch]
2014-06-17 Used the meander on the HDMI_RX1 traces
    [pandaLight.brd, pandaLight.sch]
2014-06-19 Moved the pullup resistor networks and removed vias from the HDMI_RX* traces
    [pandaLight.brd, pandaLight.sch]
2014-06-19 Began routing the DDR3 RAM
    [pandaLight.brd, pandaLight.sch]
2014-06-21 First routing of the DDR3 address lines
    [pandaLight.brd, pandaLight.sch]
2014-06-22 Finished routing the first DDR3 signal group: A* BA* RAS# CAS# WE#, now to length matching that group...
    [pandaLight.brd]
2014-06-23 Some tweaking and length matching of the DDR3 traces
    [pandaLight.brd, pandaLight.sch]
2014-06-23 Four signals of the DDR3 address signal group length matched!
    [pandaLight.brd]
2014-06-23 Length matched a whole lot of signals!
    [pandaLight.brd]
2014-06-23 Finished length matching the DDR3 address trace group!
    [pandaLight.brd]
2014-06-26 NEEDS MOVING OF THE RX HDMI CLOCK CHANNELS TO DIFFERENTIAL GLOBAL CLOCK INPUTS!!
    [pandaLight.sch]
2014-08-20 pandaLight -> pandaLightPlus; New board: smaller, LX9 FPGA
    [DRILEGEND.CFG, pandaLight.brd, pandaLight.sch, pandaLightPlus.brd, pandaLightPlus.sch, pandaLightPlus_DigiKeyOrder.csv]
2014-08-21 Continued switching to LX9
    [pandaLight.brd, pandaLight.sch]
2014-08-22 Made new signal connections; Removed old signals; New buck regulator; Reset the board layout
    [pandaLight.brd, pandaLight.sch]
2014-08-24 Created BOM; Began routing; Changed to available LEDs
    [pandaLight.brd, pandaLight.sch, pandaLight_DigiKeyOrder.csv]
2014-08-25 Little bit of routing
    [pandaLight.brd]
2014-08-25 Removed the USB companion chip; Routed USB part
    [pandaLight.brd, pandaLight.sch]
2014-08-26 Routed HDMI TX
    [pandaLight.brd, pandaLight.sch]
2014-08-26 Minor library changes; Searching for CMOS to TTL level shifters for the LED strip outputs
    [pandaLight.brd, pandaLight.sch]
2014-08-27 Minor changes; Still looking for decent pin protection
    [pandaLight.brd, pandaLight.sch]
2014-08-28 Added LED signal CMOS to TTL level shifter
    [pandaLight.brd, pandaLight.sch]
2014-08-31 Added second LED strip connector; Switched to 4-Bit level shifter
    [pandaLight.brd, pandaLight.sch]
2014-08-31 Routed HDMI RX
    [pandaLight.brd]
2014-08-31 Adjusted the board size; Approximately placed the larger components
    [pandaLight.brd]
2014-08-31 Minor routing
    [pandaLight.brd]
2014-09-01 Routed USB to FPGA signals
    [pandaLight.brd, pandaLight.sch]
2014-09-01 Routed PMODs
    [pandaLight.brd, pandaLight.sch]
2014-09-03 Switched 3.3V with ground layer (now ground is on top); Adjusted board width to 90mm; Routed everything, about 10 airwires left!
    [pandaLight.brd, pandaLight.sch]
2014-09-03 No more airwires! Added ESD protection at 5V_SUP
    [pandaLight.brd, pandaLight.sch]
2014-09-03 Move S6LX9 to own library; Adjusted parts' "place" layer; USB_PWRSAV#
    [pandaLight.brd, pandaLight.sch]
2014-09-04 Part renumber; "place" layer changes
    [pandaLight.brd, pandaLight.sch]
2014-09-05 Changed all 7mil traces to 6mil; Set library part prefixes; Applied all part attributes
    [pandaLight.brd, pandaLight.sch]
2014-09-08 Major design change: I remembered multiboot! That makes it possible to use two HDMI receivers again! So I removed the SPDI/Fs, for which there was no more space, and I added the HDMI receptical and r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
    [pandaLight.brd, pandaLight.sch, pandaLight_DigiKeyOrder.csv]
2014-09-08 Added Feducias; Added logos; Minor silkscreen changes
    [pandaLight.brd, pandaLight.sch]
2014-09-09 Adjusted and placed part names; refreshed BOM
    [pandaLight.brd, pandaLight.sch, pandaLight_DigiKeyOrder.csv]
2014-09-10 Moved names awaay from the pads a little; added port descriptions
    [pandaLight.brd]
2014-09-10 Added HDMI port arrows
    [pandaLight.brd]
2014-09-28 Corrected wrong BOMex part number of the inductors (after ordering them...); Switched to smaller 0402, 0603, 1206 footprint: Many of my hand placed passives are crooked; Moved all names away from vias
    [pandaLight.brd, pandaLight.sch]
2014-09-29 Trying EagleUp; Now using R* and C* parts for caps and resistors
    [pandaLight.brd, pandaLight.sch]
2014-09-29 First draft of SketchUp model; Set extra part for ferrite beads
    [pandaLight.brd, pandaLight_rev1.skp]
2014-09-29 Forgot saving
    [pandaLight.brd, pandaLight.sch]
2014-10-05 Corrected wrongly aligned HDMI connector; First version of SketchUp render, only the bluetooth module is missing
    [pandaLight.brd, pandaLight.sch]
2014-10-12 Changed buck regulator and level translator to SOT packages, yet unrouted
    [pandaLight.brd, pandaLight.sch]
2014-10-13 Routed new buck regulator
    [pandaLight.brd, pandaLight.sch]
2014-10-13 Routed everything, corrected unconnected ground pins (due to higher isolation)
    [pandaLight.brd, pandaLight.sch]
2014-10-14 Minor improvements of labels
    [pandaLight.brd]
2014-10-14 Finalized rev.1 design; Exported new BOM; rendered new SketchUp model
    [pandaLight.brd, pandaLight.sch, pandaLight_DigiKeyOrder.csv]
2014-11-09 Final rev.1 silksreen adjustments; Generated final BOM & partlist; Added Seeedstudio gerber files
    [pandaLight.GBL, pandaLight.GBO, pandaLight.GBP, pandaLight.GBS, pandaLight.GTL, pandaLight.GTO, pandaLight.GTP, pandaLight.GTS]
2015-01-06 Corrected LEDs control wiring error
    [pandaLight.brd, pandaLight.sch]
2017-02-08 Replaced PAN1322 with ESP-WROOM-32
    Connected it to UART and JTAG; Began routing
    [pandaLight.brd, pandaLight.sch]
2017-02-09 Added borders to all capacitor and resistor packages
    [pandaLight.brd, pandaLight.sch]
2017-02-10 Routed some of the HDMI signals
    [pandaLight.brd, pandaLight.sch]
2017-02-20 Finished routing HDMI RX1 and ESP-32
    [pandaLight.brd, pandaLight.sch]
2017-02-20 Rotated bottom labels; Minor routing changes
    [pandaLight.brd]
2017-02-20 5V polygon size adjustment
    [pandaLight.brd]
2017-02-20 Fixed ESP32 south pad placement
    [pandaLight.brd, pandaLight.sch]
2017-02-20 rev.2; Logo beams on tStop layer
    [pandaLight.brd]
2017-02-20 Exported rev.2 Gerber files
    [pandaLight.GBL, pandaLight.GBO, pandaLight.GBP, pandaLight.GBS, pandaLight.GTL, pandaLight.GTO, pandaLight.GTP, pandaLight.GTS]
2017-02-20 Added missing _tSilk layer to Gerber export
    [pandaLight.GTO]
2017-02-20 Showing dimension units
    [pandaLight.brd]
2017-02-20 Added ESP_EN and ESP_IO0 to FPGA for programming the ESP32
    [pandaLight.brd, pandaLight.sch]
2017-02-20 Rerouted HDMI RX1 signals
    [pandaLight.brd]
2017-02-20 New Gerber export
    [pandaLight.GBL, pandaLight.GTL, pandaLight.GTO, pandaLight.GTP, pandaLight.GTS]
